iti-luebeck/BEEP/Hardware/3D-CAD/Robot.png

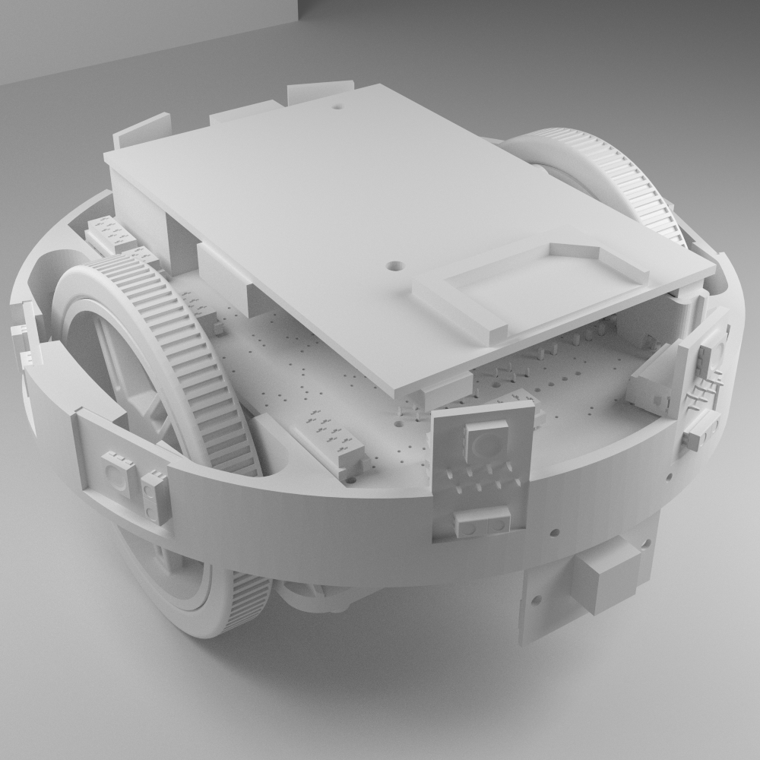
Hardware/3D-CAD/Robot.png
