iti-luebeck/BEEP/Images/BEEP 0.2/case_2.JPG

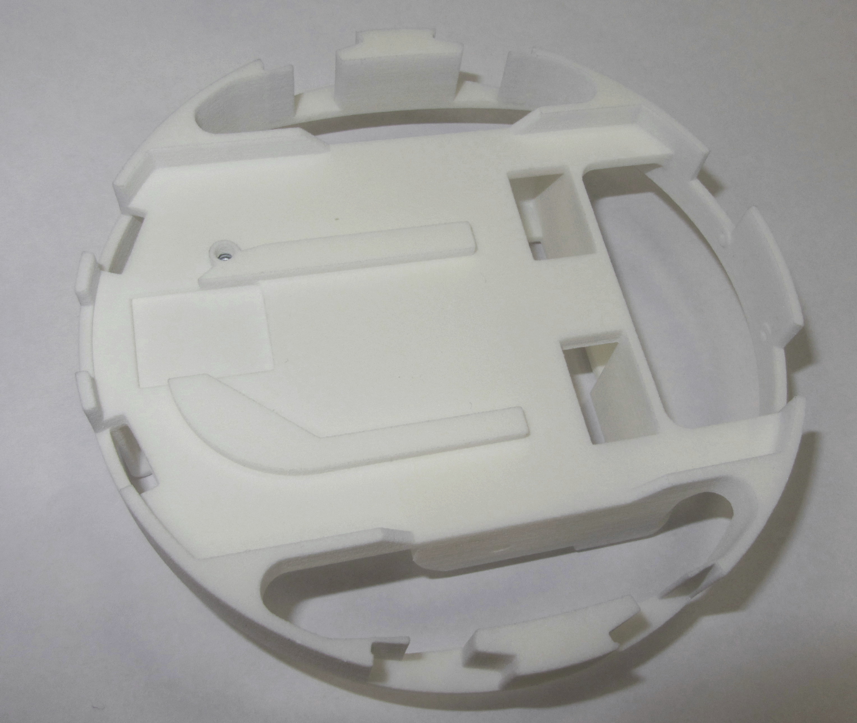
Images/BEEP 0.2/case_2.JPG
