iti-luebeck/BEEP/README.md

BEEP
====

BEEP is a small mobile robot build for education purposes.
