iti-luebeck/BEEP/Hardware/PCBs/BEEP_0.1/AIO/src/AIO.tex

\documentclass[a4paper]{scrartcl}
\usepackage[margin=1cm]{geometry}
\usepackage{graphicx}
\parindent=0pt
\parskip=5mm
\pagestyle{empty}
\begin{document}
\hspace{5mm}
\hspace{5mm}
\hspace{5mm}

\hspace{5mm}
\hspace{5mm}
\hspace{5mm}
\hspace{5mm}

\hspace{5mm}
\hspace{5mm}
\end{document}
