iti-luebeck/BEEP/Hardware/3D-CAD/exploded-view_1000.png

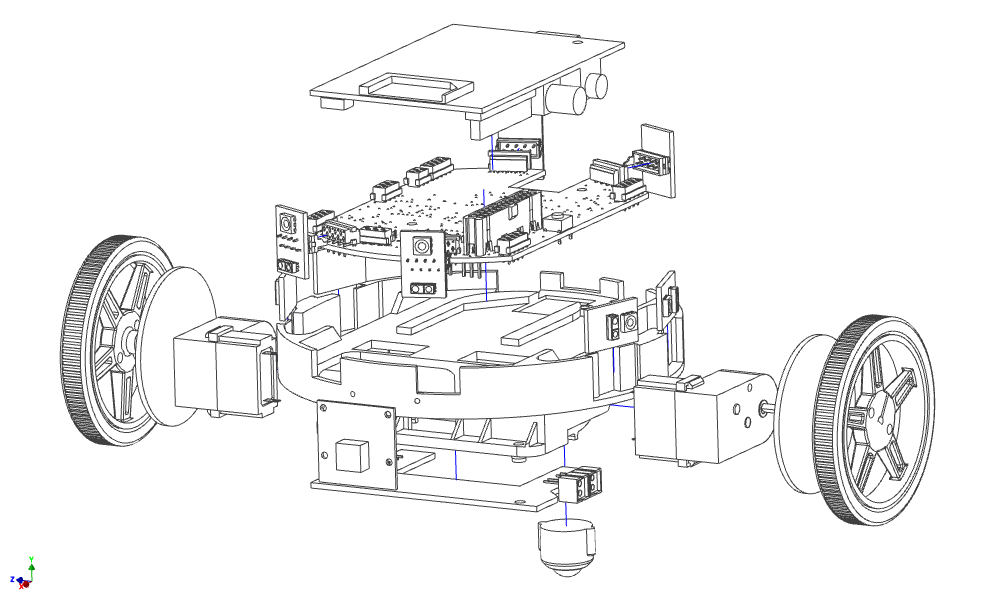
Hardware/3D-CAD/exploded-view_1000.png
