iti-luebeck/BEEP/Hardware/3D-CAD/parts/electronic/BEEP/AIO.png

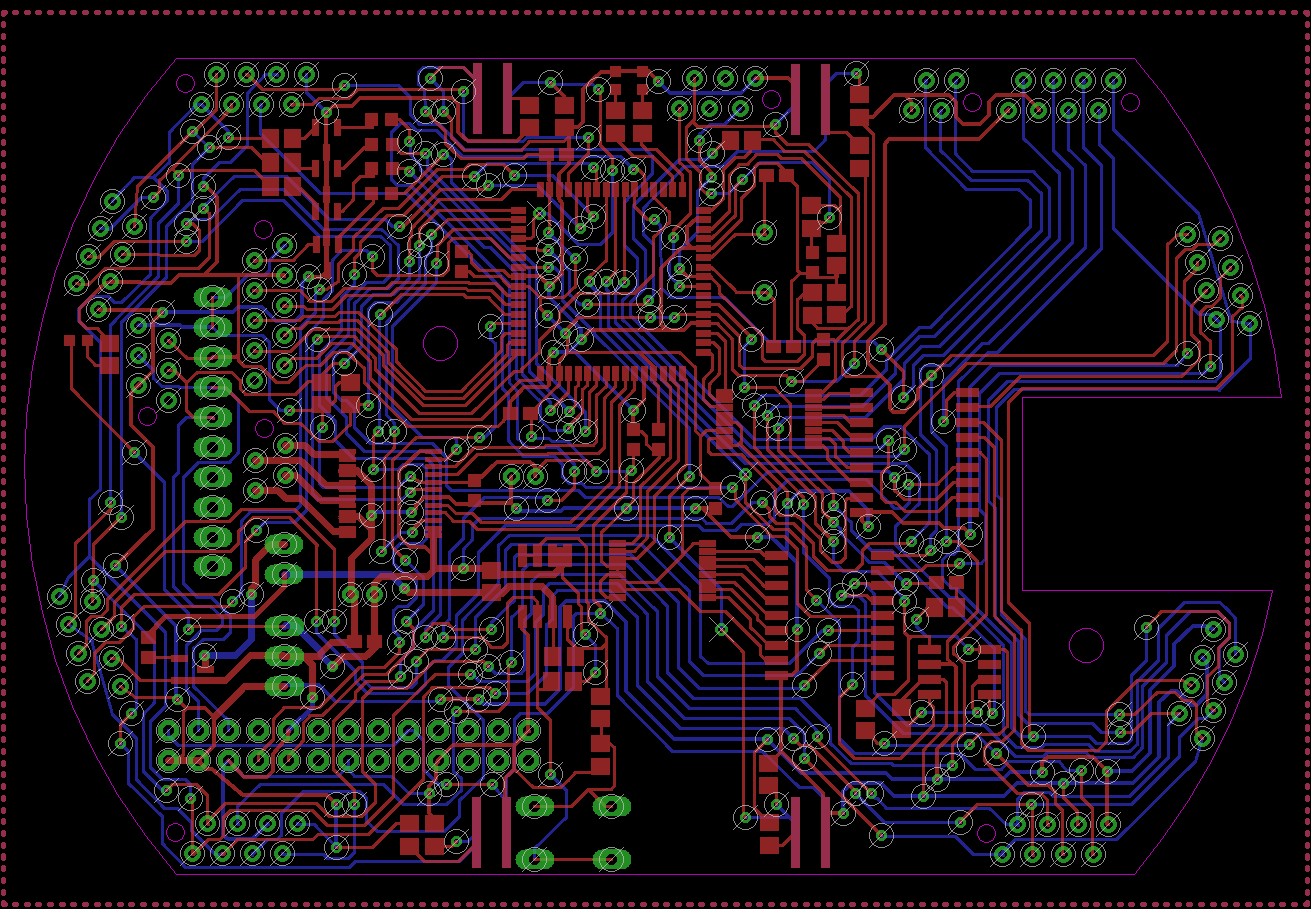
Hardware/3D-CAD/parts/electronic/BEEP/AIO.png
