iti-luebeck/BEEP/Hardware/PCBs/BEEP_0.1/3D/8_RGB_SMD_LEDs/8_RGB_SMD_LEDs_pcb_t.pov.png

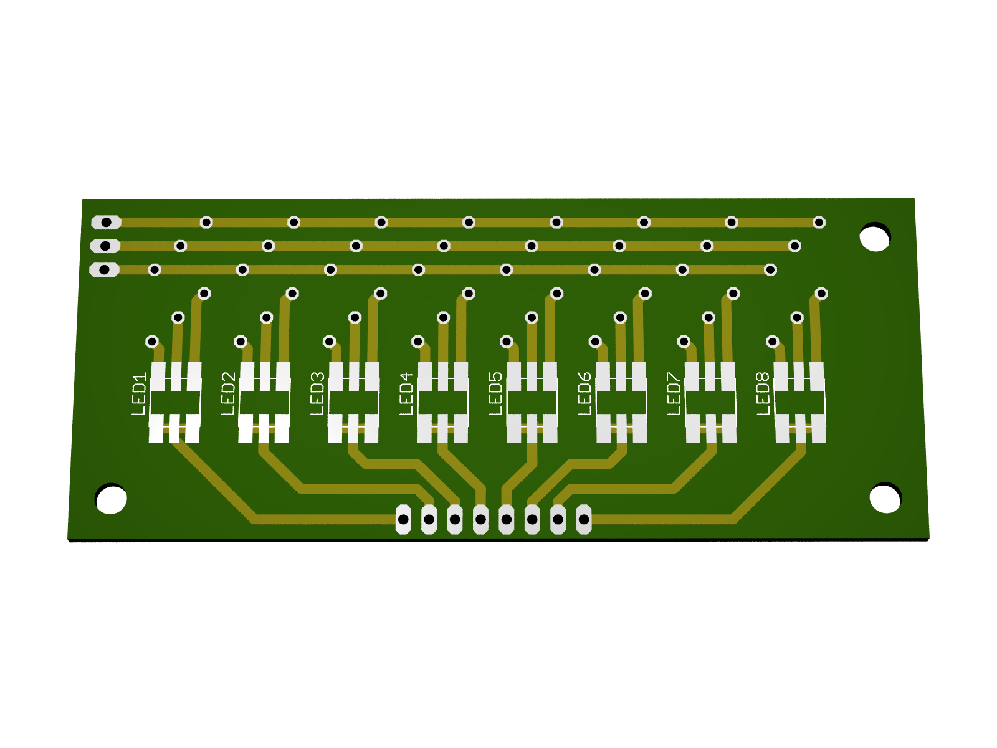
Hardware/PCBs/BEEP_0.1/3D/8_RGB_SMD_LEDs/8_RGB_SMD_LEDs_pcb_t.pov.png
