iti-luebeck/BEEP/Hardware/PCBs/BEEP_0.1/3D/APDS-9801/APDS-9801_pcb_b.pov.png

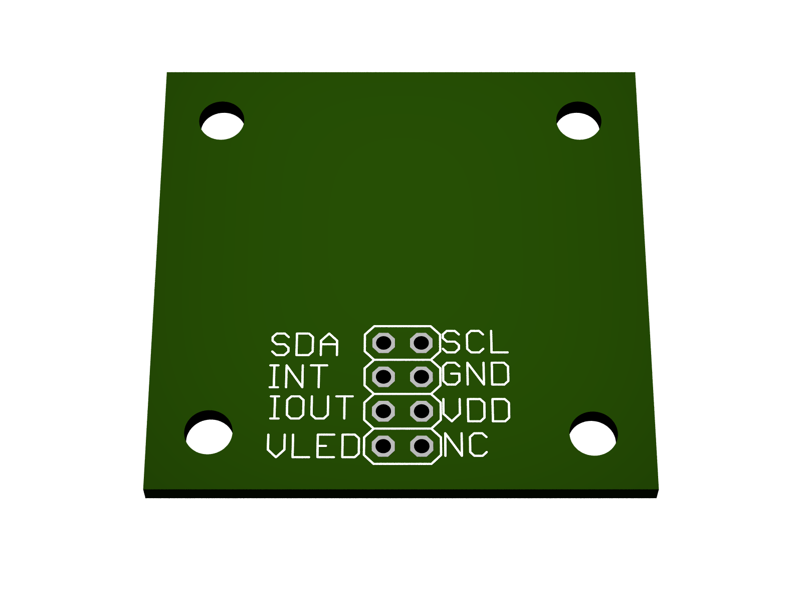
Hardware/PCBs/BEEP_0.1/3D/APDS-9801/APDS-9801_pcb_b.pov.png
