iti-luebeck/BEEP/Hardware/PCBs/BEEP_0.1/3D/ATMEGA168/ATMEGA168_pcb_t.pov.png

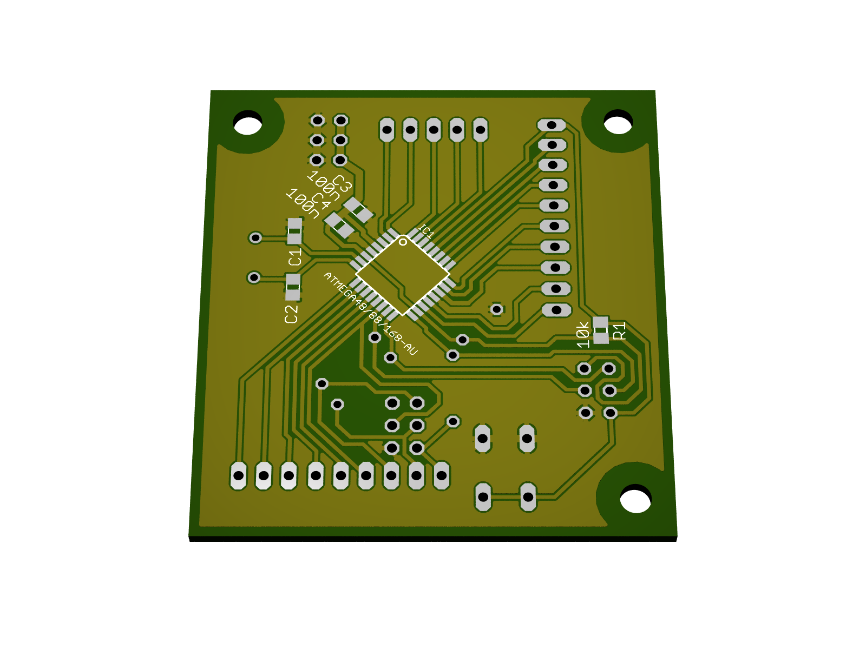
Hardware/PCBs/BEEP_0.1/3D/ATMEGA168/ATMEGA168_pcb_t.pov.png
