iti-luebeck/BEEP/Hardware/PCBs/BEEP_0.1/3D/Easy_LED/Easy_LED_pcb_t.pov.png

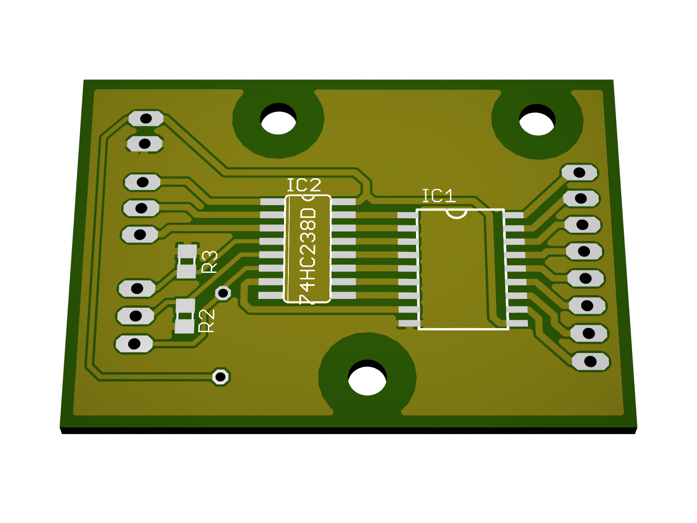
Hardware/PCBs/BEEP_0.1/3D/Easy_LED/Easy_LED_pcb_t.pov.png
