iti-luebeck/BEEP/Hardware/PCBs/BEEP_0.1/3D/HSDL-9100/HSDL-9100_pcb_t.pov.png

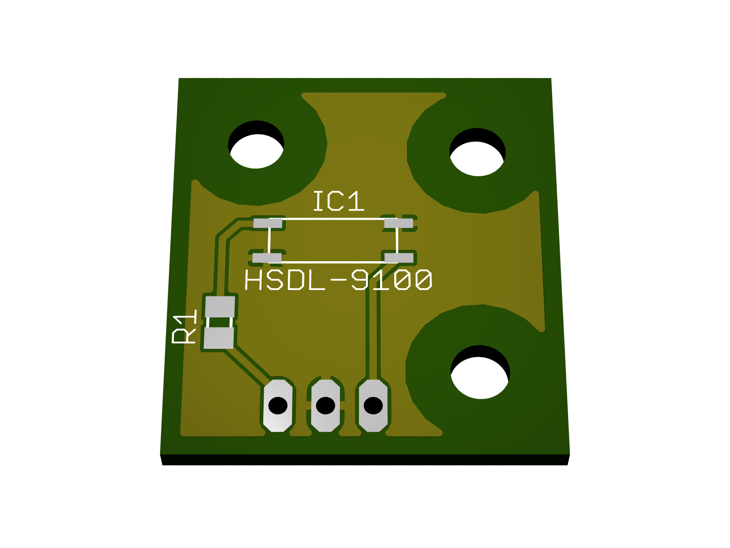
Hardware/PCBs/BEEP_0.1/3D/HSDL-9100/HSDL-9100_pcb_t.pov.png
