iti-luebeck/BEEP/Hardware/PCBs/BEEP_0.1/3D/PCA9548A/PCA9548A_t.pov.png

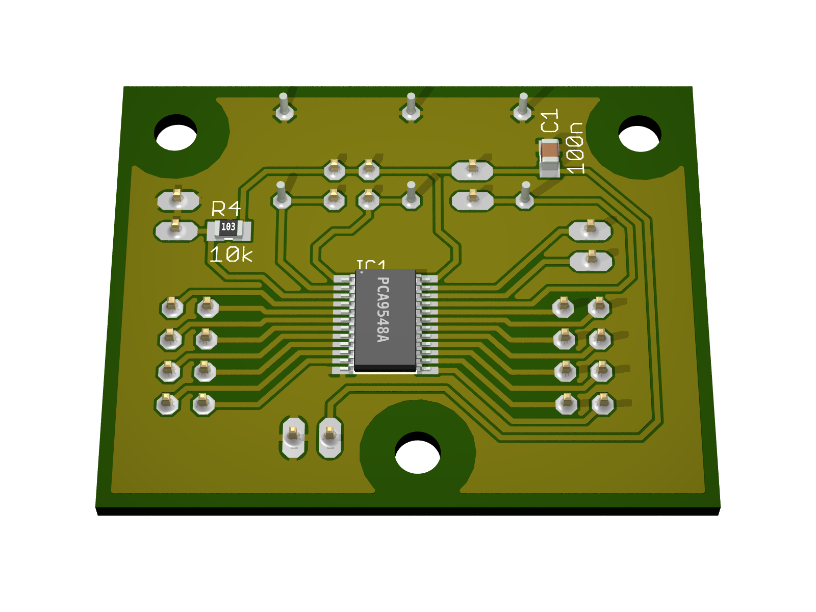
Hardware/PCBs/BEEP_0.1/3D/PCA9548A/PCA9548A_t.pov.png
