iti-luebeck/BEEP/Hardware/PCBs/BEEP_0.1/3D/TCS32X0/TCS32X0_pcb_t.pov.png

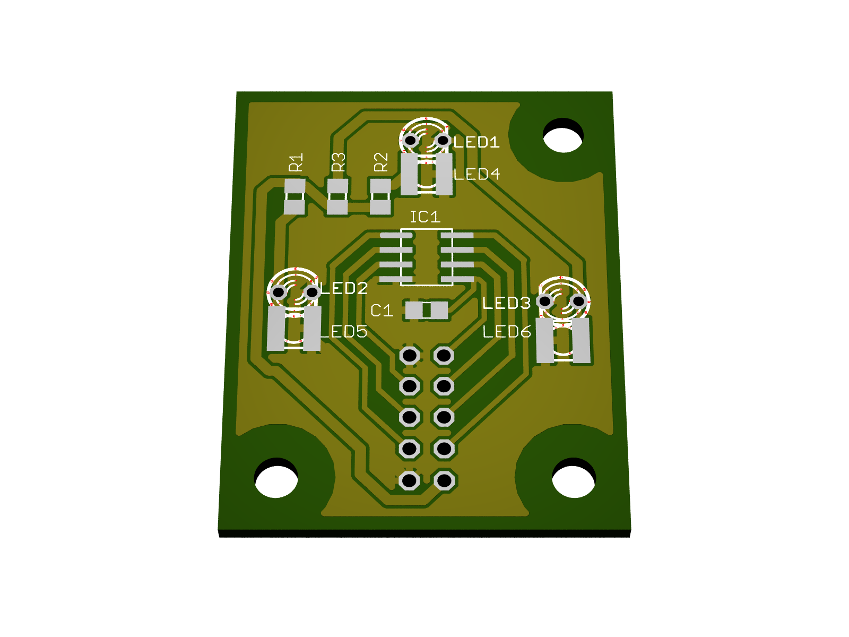
Hardware/PCBs/BEEP_0.1/3D/TCS32X0/TCS32X0_pcb_t.pov.png
