iti-luebeck/BEEP/Hardware/PCBs/BEEP_0.1/3D/TCS3103/TCS3103_b.pov.png

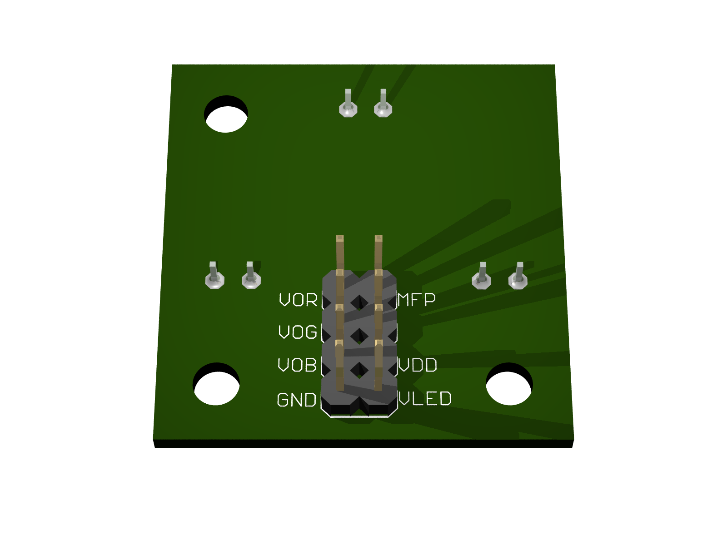
Hardware/PCBs/BEEP_0.1/3D/TCS3103/TCS3103_b.pov.png
