iti-luebeck/BEEP/Hardware/PCBs/BEEP_0.1/3D/TCS3103/TCS3103_pcb_t.pov.png

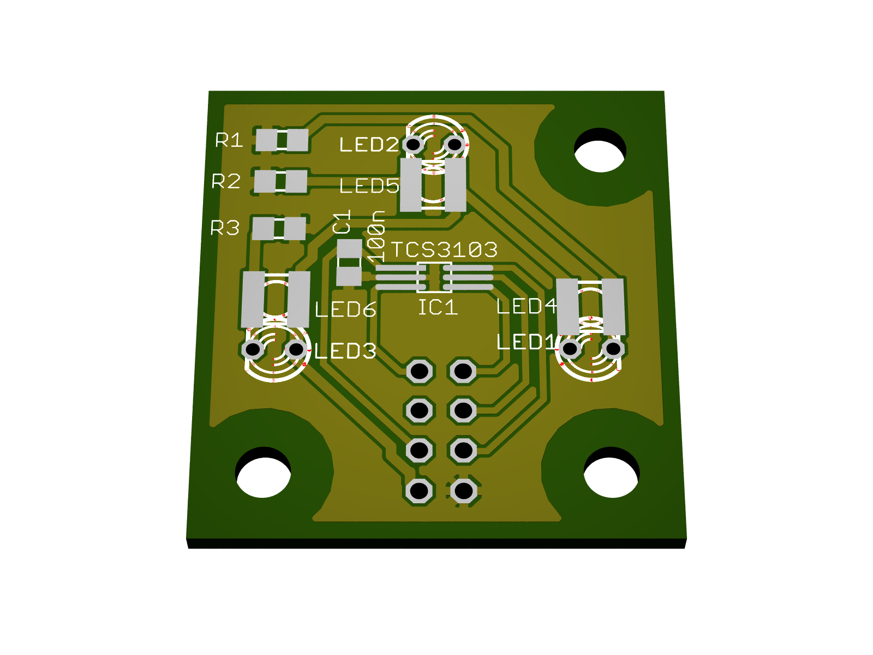
Hardware/PCBs/BEEP_0.1/3D/TCS3103/TCS3103_pcb_t.pov.png
