iti-luebeck/BEEP/Hardware/PCBs/BEEP_0.1/3D/TSL2671/TSL2671_b.pov.png

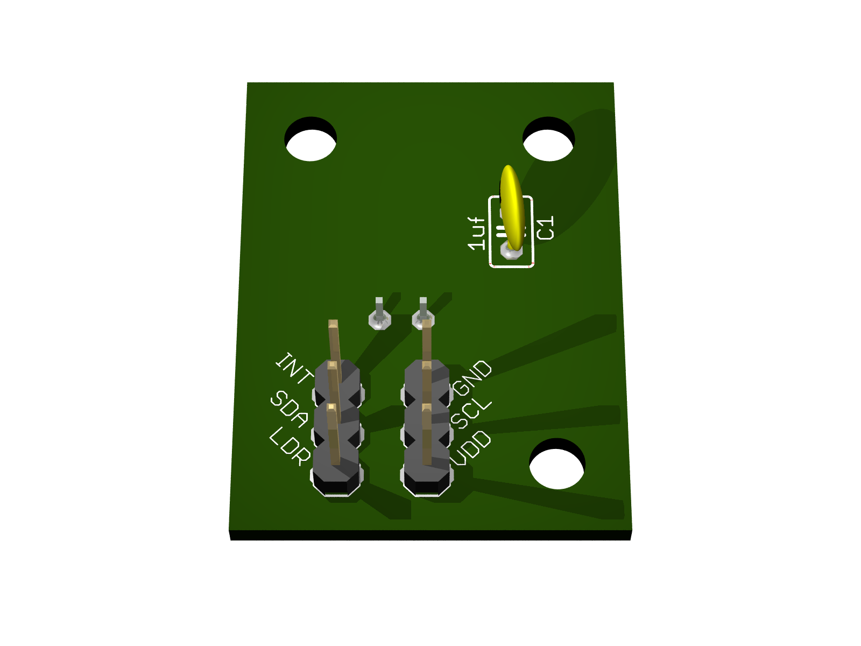
Hardware/PCBs/BEEP_0.1/3D/TSL2671/TSL2671_b.pov.png
