iti-luebeck/BEEP/Hardware/PCBs/BEEP_0.2/main-bottom.png

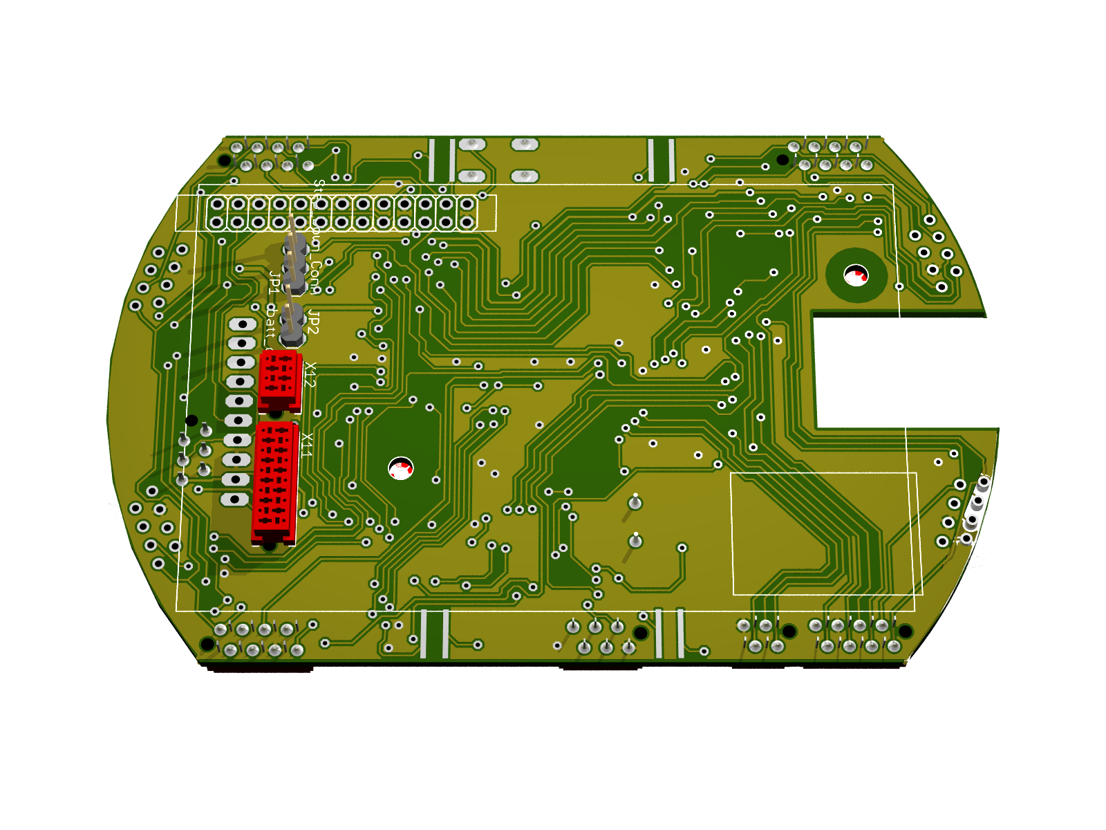
Hardware/PCBs/BEEP_0.2/main-bottom.png
