iti-luebeck/BEEP/Hardware/PCBs/BEEP_0.2/main_top.png

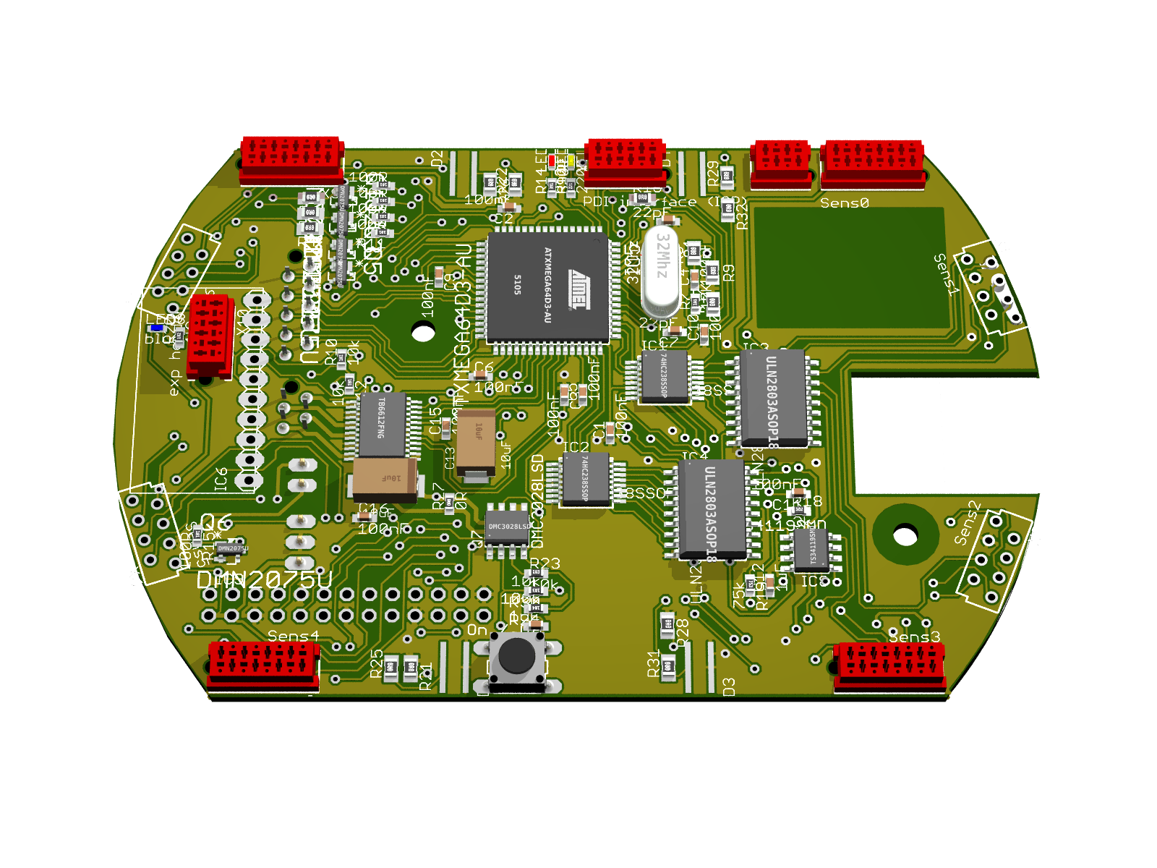
Hardware/PCBs/BEEP_0.2/main_top.png
