iti-luebeck/BEEP/Images/BEEP 0.2/CAD.png

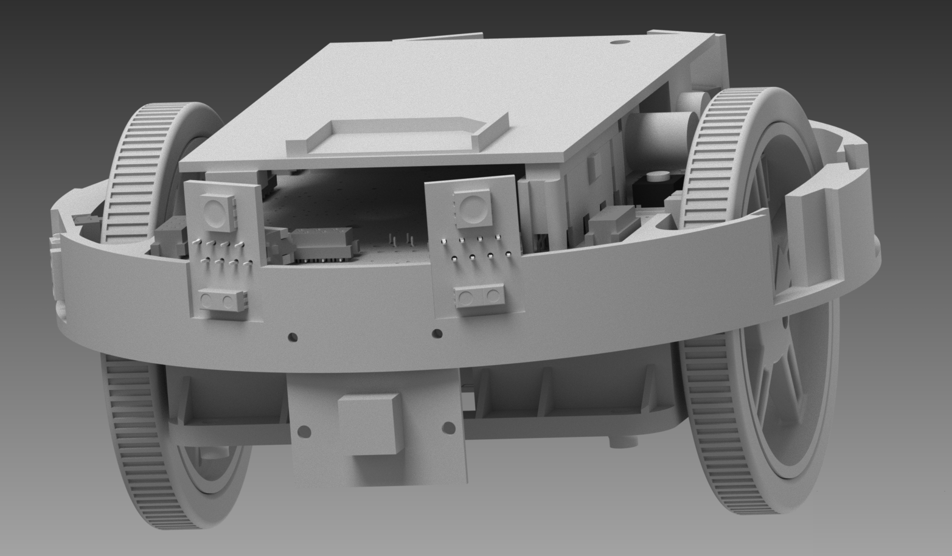
Images/BEEP 0.2/CAD.png
