iti-luebeck/BEEP/Images/BEEP 0.2/case_1.JPG

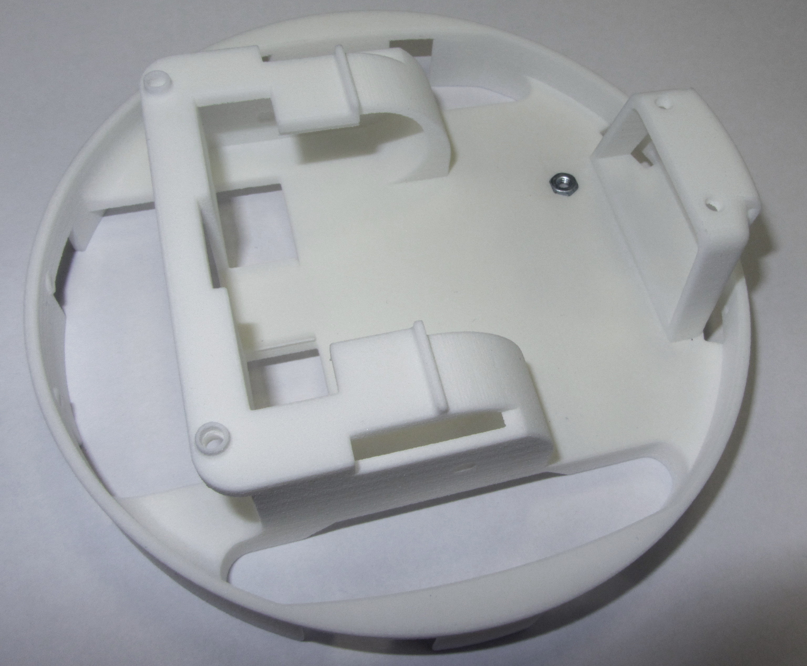
Images/BEEP 0.2/case_1.JPG
