iti-luebeck/BEEP/Images/BEEP 0.2/case_pcb_4.JPG

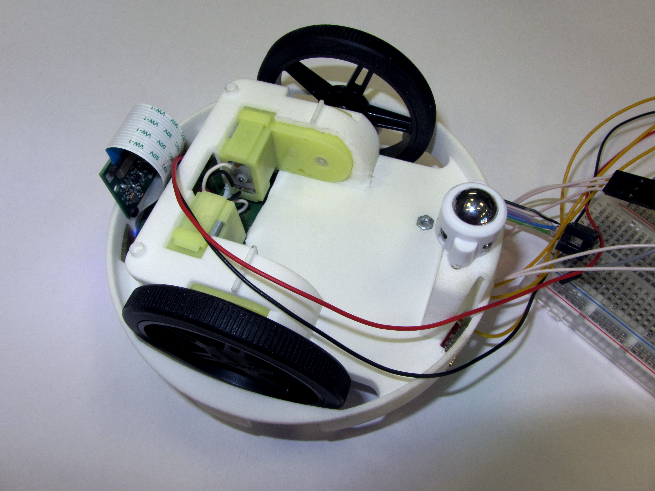
Images/BEEP 0.2/case_pcb_4.JPG
