iti-luebeck/BEEP/Images/BEEP 0.2/pcb_beep_2.JPG

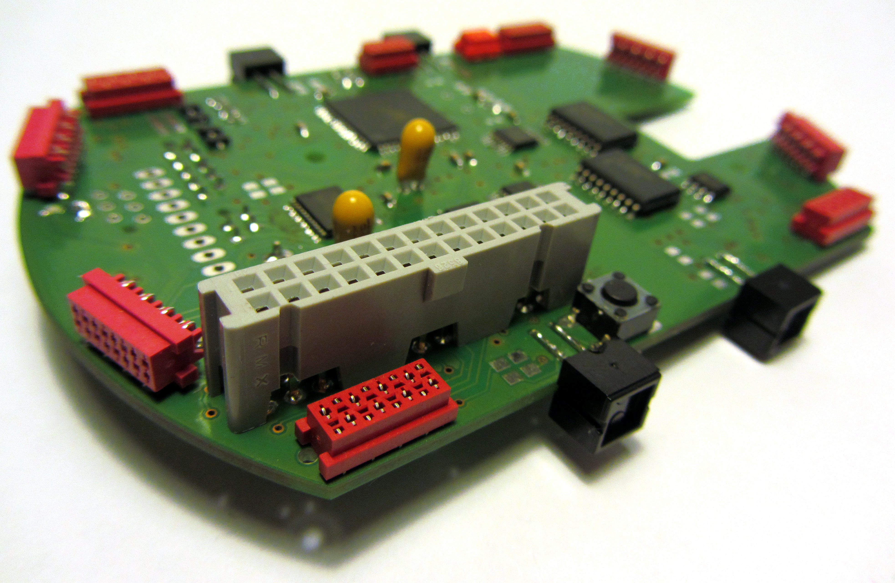
Images/BEEP 0.2/pcb_beep_2.JPG
