iti-luebeck/BEEP/Images/BEEP 0.2/pcb_combo_1.JPG

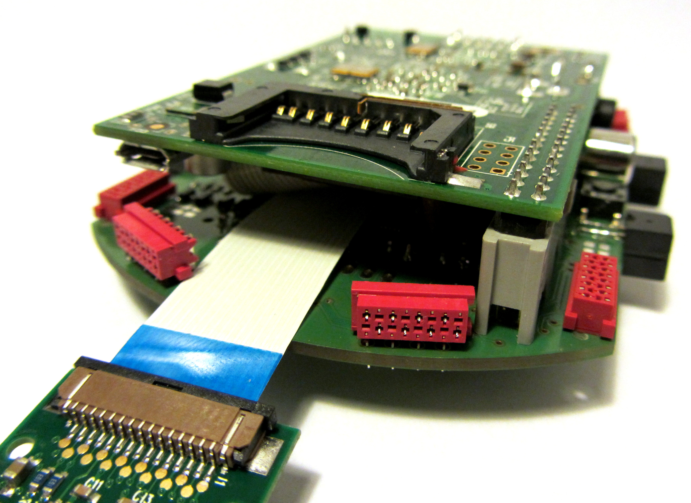
Images/BEEP 0.2/pcb_combo_1.JPG
