iti-luebeck/BEEP/Images/BEEP 0.2/pcb_combo_2.JPG

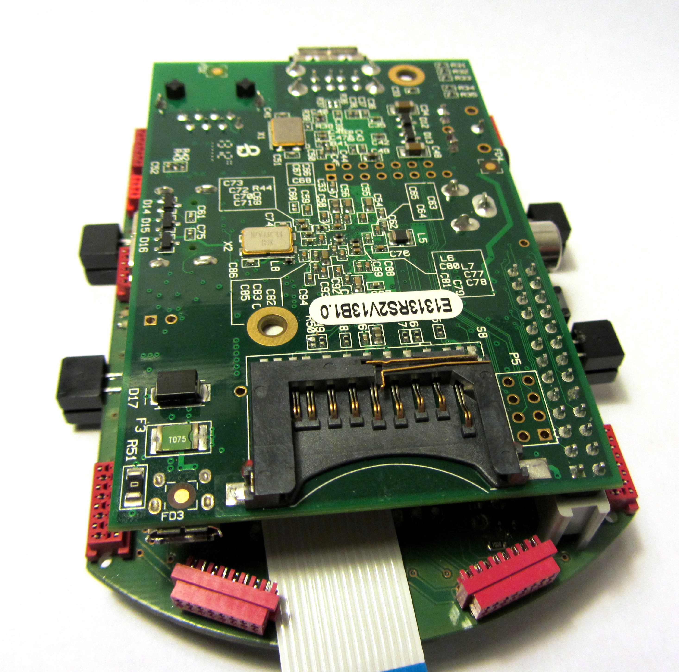
Images/BEEP 0.2/pcb_combo_2.JPG
