iti-luebeck/BEEP/Branding/BEEP.dxf

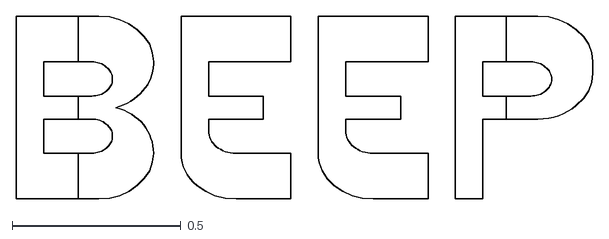
[picture p45: CAD file, 2013-05-05]
Branding/BEEP.dxf
1.71 x 0.541
