iti-luebeck/BEEP/Hardware/3D-CAD/parts/encoder_wheel.stp

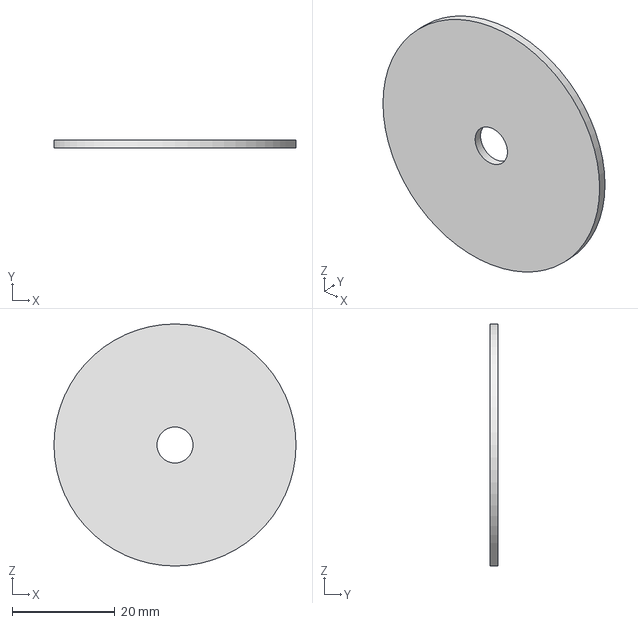
[picture p46: CAD file, 2013-08-02]
Hardware/3D-CAD/parts/encoder_wheel.stp
47.0 x 1.50 x 47.0 mm
