iti-luebeck/BEEP/Hardware/3D-CAD/pcb_space.dxf

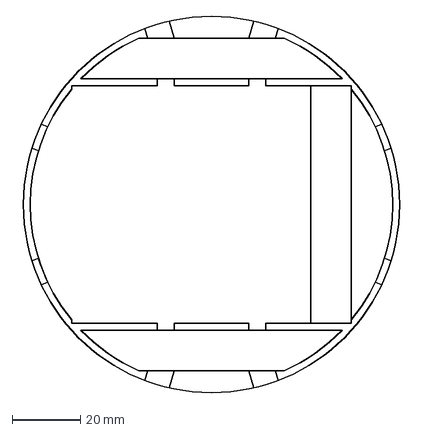
[picture p47: CAD file, 2013-06-28]
Hardware/3D-CAD/pcb_space.dxf
114.1 x 110.0 mm
