iti-luebeck/BEEP/Hardware/PCBs/BEEP_0.2/rgb_and_irdistance.dxf

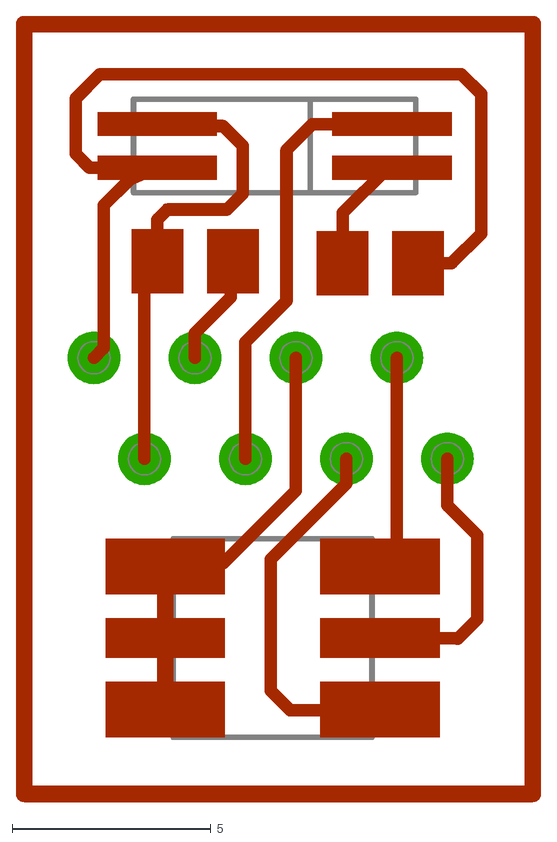
[picture p48: CAD file, 2013-08-30]
Hardware/PCBs/BEEP_0.2/rgb_and_irdistance.dxf
13.2 x 19.8
