iti-luebeck/BEEP/(list of files, cad)

Other CAD files:
Hardware/3D-CAD/ASUS_XtionPro_Live/head.ipt
Hardware/3D-CAD/Robot.iam
Hardware/3D-CAD/Robot.ipn
Hardware/3D-CAD/ball_caster/ball.ipt
Hardware/3D-CAD/ball_caster/ballcaster.iam
Hardware/3D-CAD/ball_caster/case.ipt
Hardware/3D-CAD/bottom_sensor.ipt
Hardware/3D-CAD/case/base.ipt
Hardware/3D-CAD/encoder_wheel.ipt
Hardware/3D-CAD/parts/Pololu_Wheel_6mm/Wheel.iam
Hardware/3D-CAD/parts/Pololu_Wheel_6mm/felloe.ipt
Hardware/3D-CAD/parts/Pololu_Wheel_6mm/tire.ipt
Hardware/3D-CAD/parts/Pololu_gear_motor_1_180/front.ipt
Hardware/3D-CAD/parts/Pololu_gear_motor_1_180/gear_motor.iam
Hardware/3D-CAD/parts/Pololu_gear_motor_1_180/motor_contact.ipt
Hardware/3D-CAD/parts/Pololu_gear_motor_1_180/motor_shaft.ipt
Hardware/3D-CAD/parts/Pololu_gear_motor_1_180/wheel_shaft.ipt
Hardware/3D-CAD/parts/battery_holder/battery_18500.ipt
Hardware/3D-CAD/parts/battery_holder/battery_18650.ipt
Hardware/3D-CAD/parts/battery_holder/holder_18500.ipt
Hardware/3D-CAD/parts/battery_holder/holder_18650.ipt
Hardware/3D-CAD/parts/battery_holder/holder_with_batteries_18500.iam
Hardware/3D-CAD/parts/battery_holder/holder_with_batteries_18650.iam
Hardware/3D-CAD/parts/electronic/BEEP/beep_main_assembled.iam
Hardware/3D-CAD/parts/electronic/BEEP/beep_main_new.ipt
Hardware/3D-CAD/parts/electronic/BEEP/beep_rgb_ir.ipt
Hardware/3D-CAD/parts/electronic/BEEP/beep_rgb_ir_assembled.iam
Hardware/3D-CAD/parts/electronic/BEEP/beep_rgb_ir_assembled_2.iam
Hardware/3D-CAD/parts/electronic/BEEP/components/12520.ipt
Hardware/3D-CAD/parts/electronic/BEEP/components/12521.ipt
Hardware/3D-CAD/parts/electronic/BEEP/components/5050 LED/5050_LED.ipt
Hardware/3D-CAD/parts/electronic/BEEP/components/8526-4500pl-01.ipt
Hardware/3D-CAD/parts/electronic/BEEP/components/HSDL-9100-024/HSDL-9100.iam
Hardware/3D-CAD/parts/electronic/BEEP/components/HSDL-9100-024/bottom_pcb.ipt
Hardware/3D-CAD/parts/electronic/BEEP/components/HSDL-9100-024/top.ipt
Hardware/3D-CAD/parts/electronic/BEEP/components/b3w-1000.ipt
Hardware/3D-CAD/parts/electronic/BEEP/components/ball_caster/top.ipt
Hardware/3D-CAD/parts/electronic/BEEP/components/c-215460-8-h-3d.ipt
Hardware/3D-CAD/parts/electronic/BEEP/components/cny-70.ipt
Hardware/3D-CAD/parts/electronic/BEEP/components/micro-miniature_steckverbinder_a-30-08p-1300.ipt
Hardware/3D-CAD/parts/electronic/BEEP/components/micro-miniature_steckverbinder_a-31-08p-1300.iam
Hardware/3D-CAD/parts/electronic/BEEP/components/micro-miniature_steckverbinder_a-31-08p-1300_01.ipt
Hardware/3D-CAD/parts/electronic/BEEP/components/micro-miniature_steckverbinder_a-31-08p-1300_02.ipt
Hardware/3D-CAD/parts/electronic/BEEP/components/micro-miniature_steckverbinder_a-32-04v-130x0.ipt
Hardware/3D-CAD/parts/electronic/BEEP/components/micro-miniature_steckverbinder_a-32-06v-130x0.ipt
Hardware/3D-CAD/parts/electronic/BEEP/components/micro-miniature_steckverbinder_a-32-08v-130x0.ipt
Hardware/3D-CAD/parts/electronic/BEEP/components/micro-miniature_steckverbinder_a-32-10v-130x0.ipt
Hardware/3D-CAD/parts/electronic/BEEP/components/micro_miniature_a-32-08h-130l.ipt
Hardware/3D-CAD/parts/electronic/RaspberryPi/PCB.ipt
Hardware/3D-CAD/parts/electronic/RaspberryPi/RaspberryPi.iam
Hardware/3D-CAD/parts/electronic/RaspberryPi/RaspberryPi_PCB.ipt
Hardware/3D-CAD/parts/electronic/RaspberryPi/RaspberryPi_with_frame.iam
Hardware/3D-CAD/parts/electronic/RaspberryPi/SD.ipt
Hardware/3D-CAD/parts/electronic/RaspberryPi/frame.ipt
Hardware/3D-CAD/parts/electronic/RaspberryPi_Camera/camera.ipt
Hardware/3D-CAD/parts/electronic/RaspberryPi_Camera/camera_modul.iam
Hardware/3D-CAD/parts/electronic/RaspberryPi_Camera/connector.ipt
Hardware/3D-CAD/parts/electronic/RaspberryPi_Camera/pcb.ipt
Hardware/3D-CAD/parts/electronic/pcb_assembly.iam
Hardware/3D-CAD/parts/encoder_wheel.ipt
Hardware/3D-CAD/parts/encoder_wheel.stl
Hardware/3D-CAD/sensorboard_assembly.iam
Hardware/Model/Baugruppe1.iam
