iti-luebeck/BEEP/Software/Evaluation IRfilterung.ods

Evaluation Tageslichtfilter
Abstand (mm) | Rohdaten |  | Gefiltert
 | unbeleuchtet | beleuchtet | unbeleuchtet | beleuchtet
10 | 201 | 227 | 191 | 192
20 | 77 | 184 | 69 | 70
30 | 41 | 154 | 33 | 34
40 | 26 | 110 | 19 | 19
50 | 18 | 113 | 11 | 11
60 | 14 | 99 | 7 | 7
70 | 12 | 108 | 5 | 5
80 | 10 | 103 | 3 | 3
90 | 9 | 106 | 2 | 2
100 | 9 | 106 | 1 | 1
