iti-luebeck/BEEP/Hardware/PCBs/BEEP_0.2/bottom.pdf

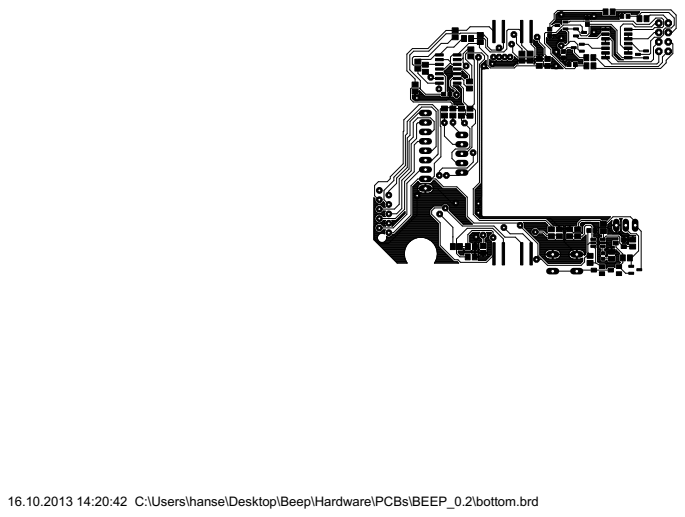
[picture p49: page 1]

16.10.2013 14:20:42 C:\Users\hanse\Desktop\Beep\Hardware\PCBs\BEEP_0.2\bottom.brd
