iti-luebeck/BEEP/Hardware/PCBs/BEEP_0.2/color_sensor.pdf

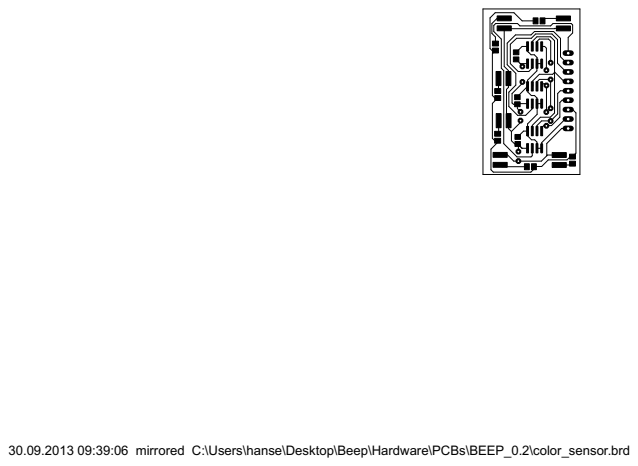
[picture p50: page 1]

30.09.2013 09:39:06 mirrored C:\Users\hanse\Desktop\Beep\Hardware\PCBs\BEEP_0.2\color_sensor.brd
