iti-luebeck/BEEP/Hardware/PCBs/BEEP_0.2/rgb_and_irdistance_side.pdf

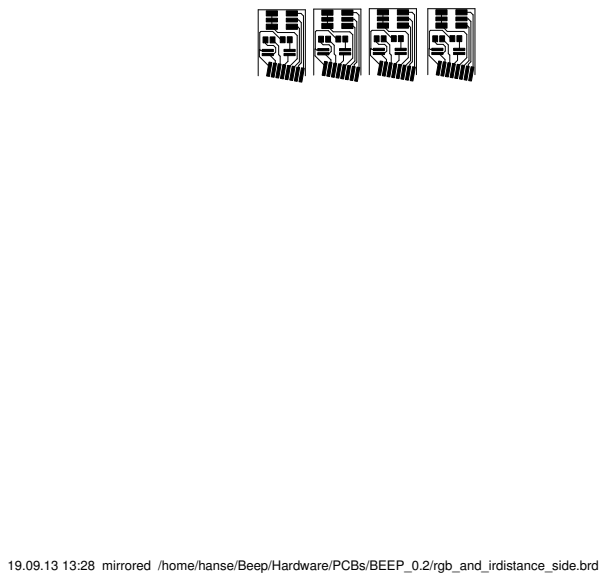
[picture p51: page 1]

19.09.13 13:28 mirrored /home/hanse/Beep/Hardware/PCBs/BEEP_0.2/rgb_and_irdistance_side.brd
