iti-luebeck/BEEP/Hardware/PCBs/BEEP_0.2/rgb_and_irdistance_side2,3.pdf

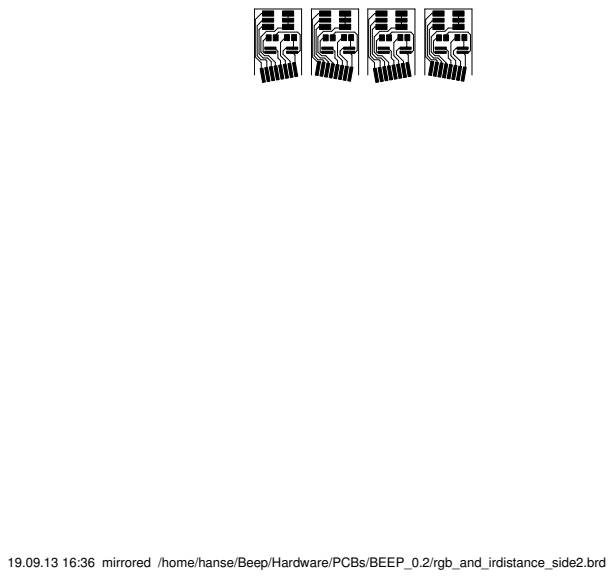
[picture p52: page 1]

19.09.13 16:36 mirrored /home/hanse/Beep/Hardware/PCBs/BEEP_0.2/rgb_and_irdistance_side2.brd
