iti-luebeck/BEEP/Hardware/PCBs/BEEP_0.1/AIO/APDS-9801.pdf

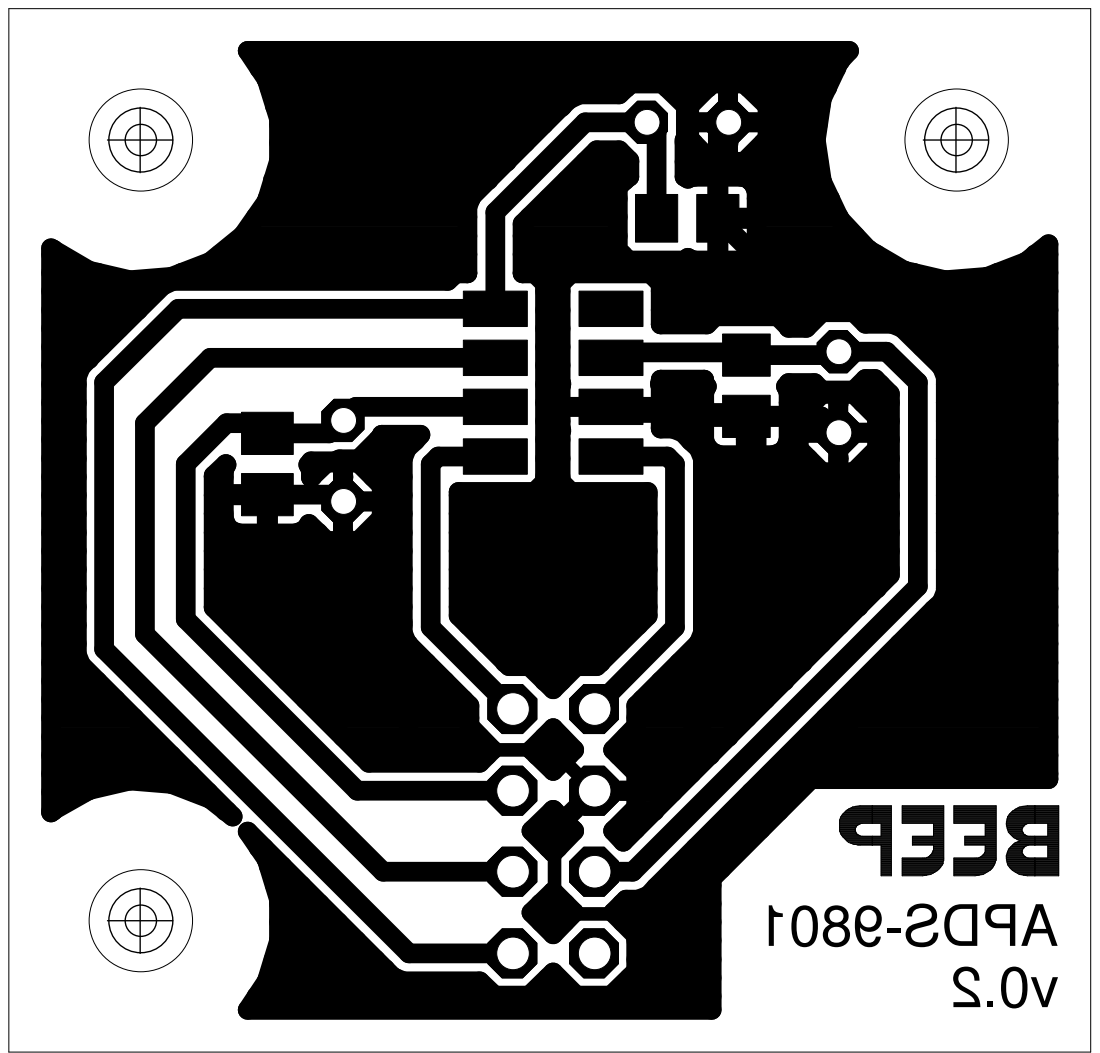
[picture p53: page 1]
1089- SDPA 2. 0v
