iti-luebeck/BEEP/Hardware/PCBs/BEEP_0.1/AIO/Easy_LED.pdf

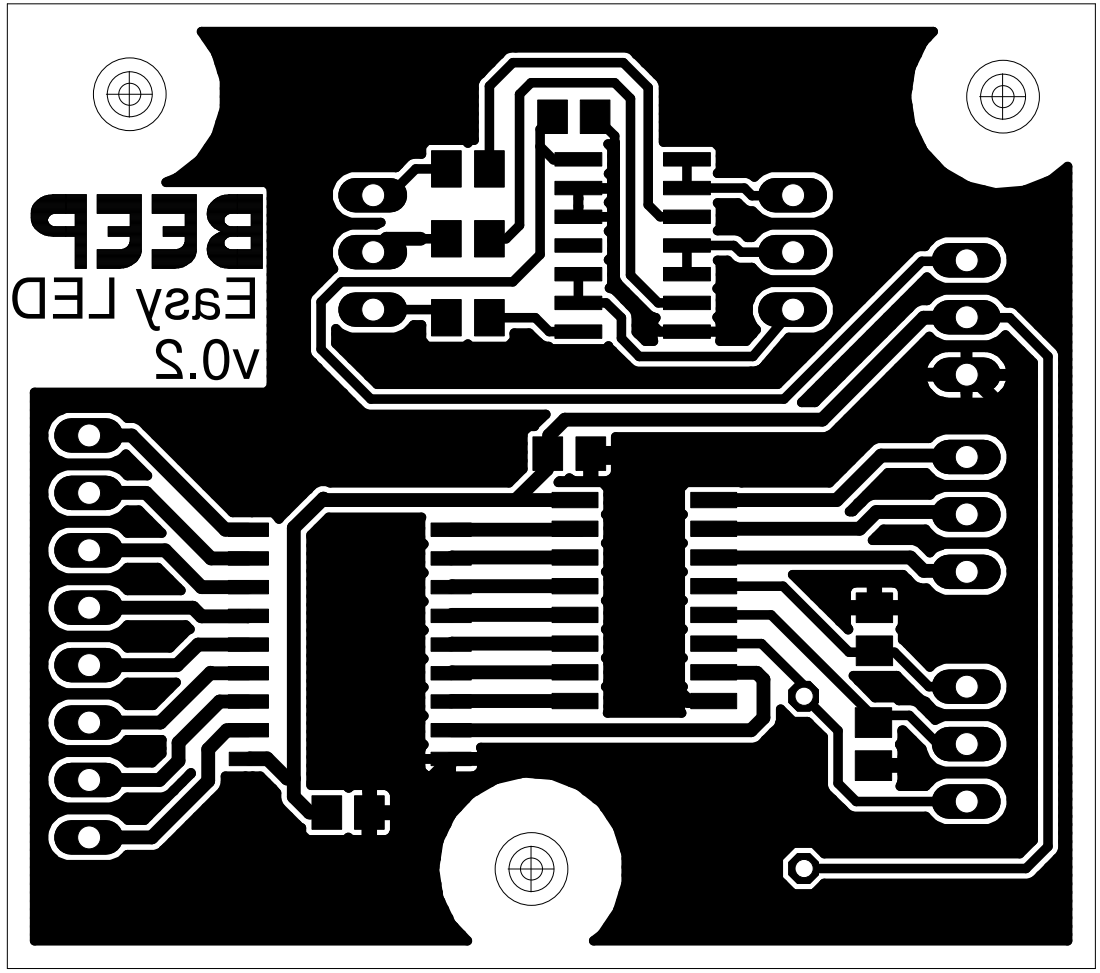
[picture p54: page 1]
DEL ysaE 2. 0v
