iti-luebeck/BEEP/Hardware/PCBs/BEEP_0.1/AIO/HSDL-9100.pdf

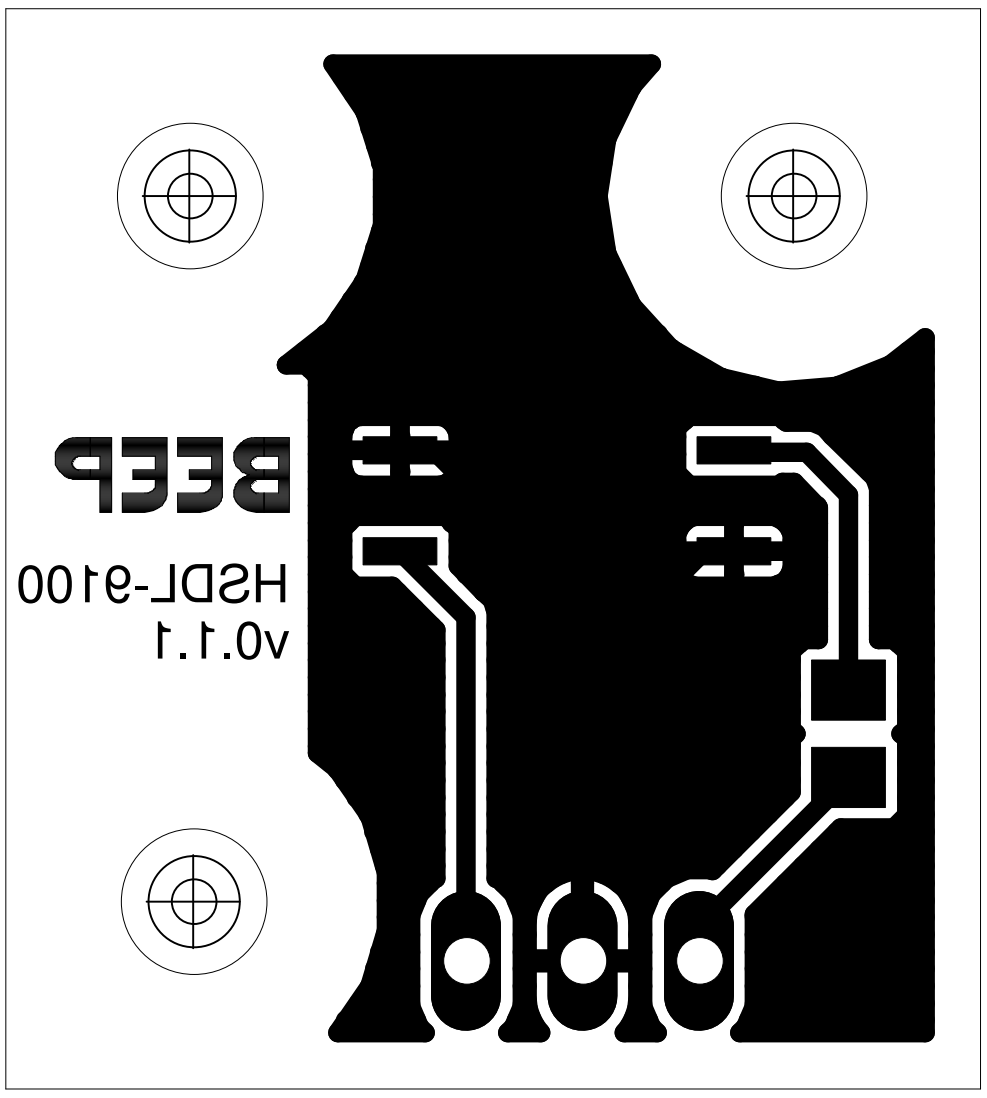
[picture p55: page 1]
0019- L DSH 1. 1. 0v
