iti-luebeck/BEEP/Hardware/PCBs/BEEP_0.1/AIO/PCA9548A.pdf

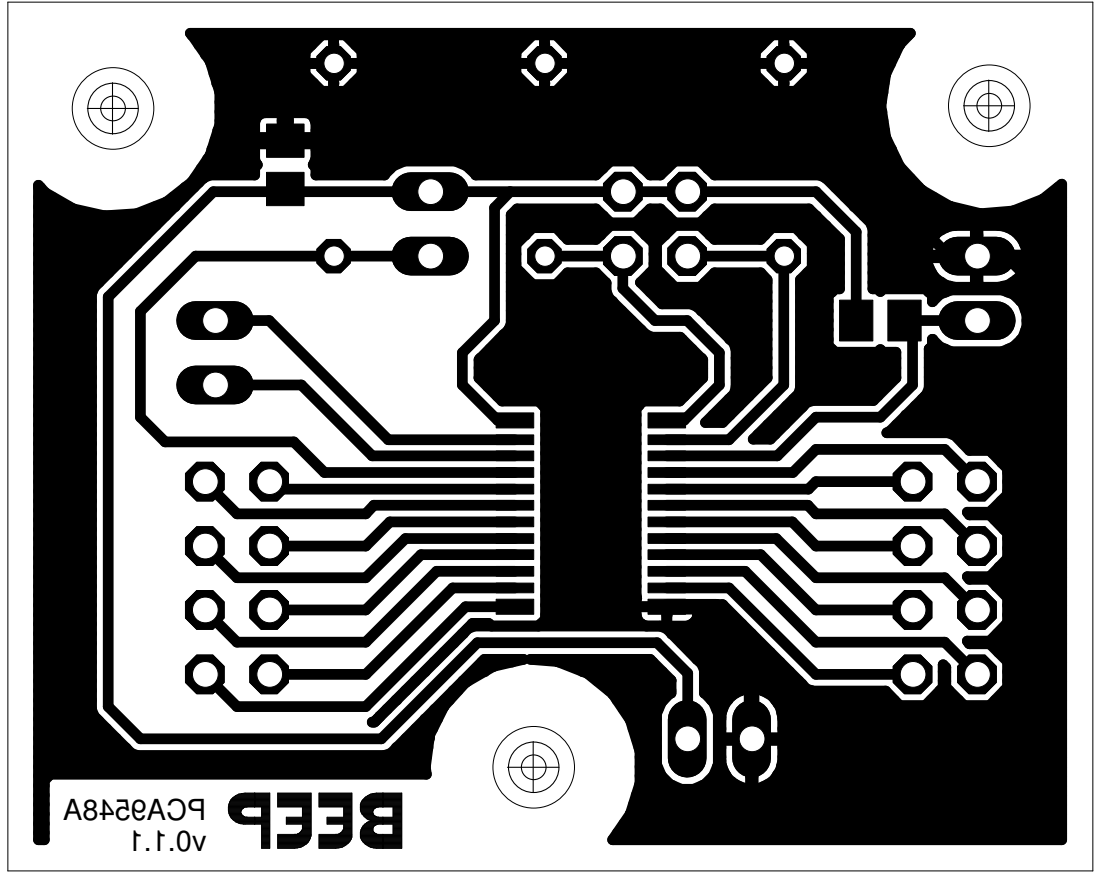
[picture p56: page 1]
A8459ACP 1. 1. 0v
