iti-luebeck/BEEP/Hardware/PCBs/BEEP_0.1/AIO/TCS32X0.pdf

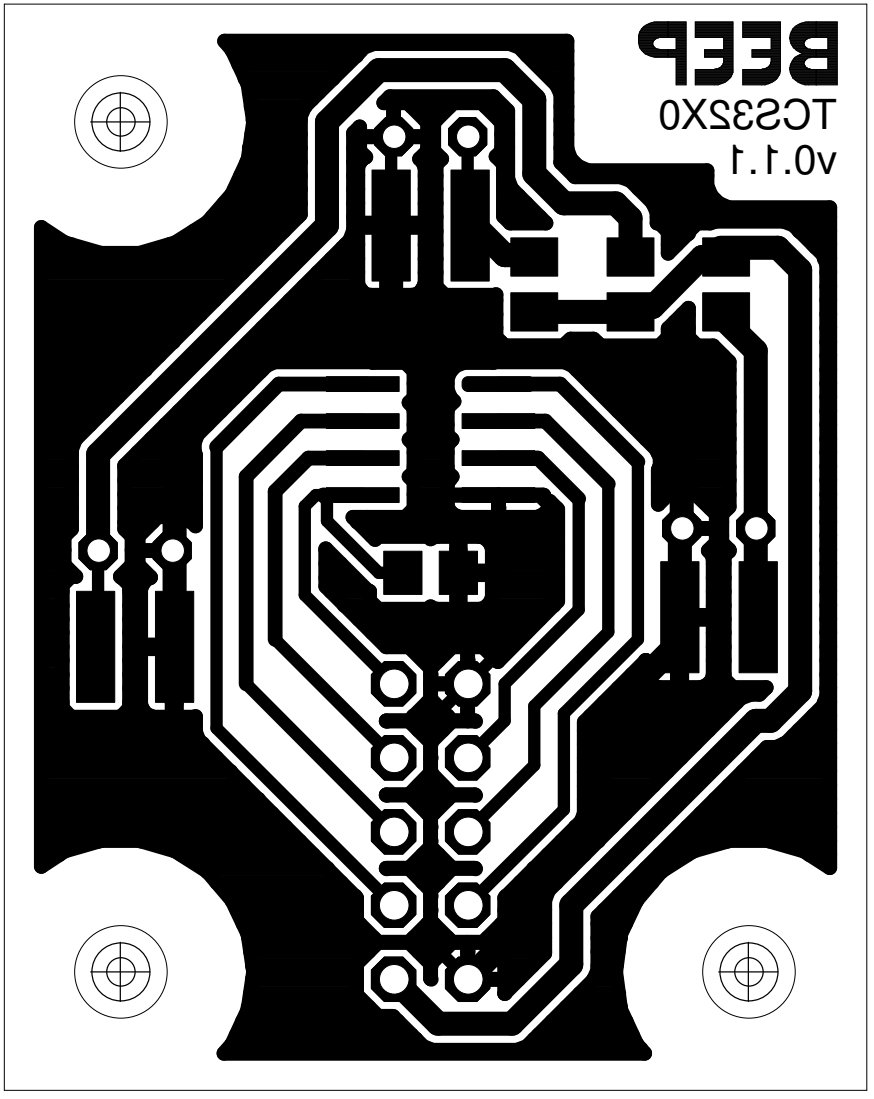
[picture p57: page 1]
0X23SCT 1. 1. 0v
