iti-luebeck/BEEP/Test/Color_Test.pdf

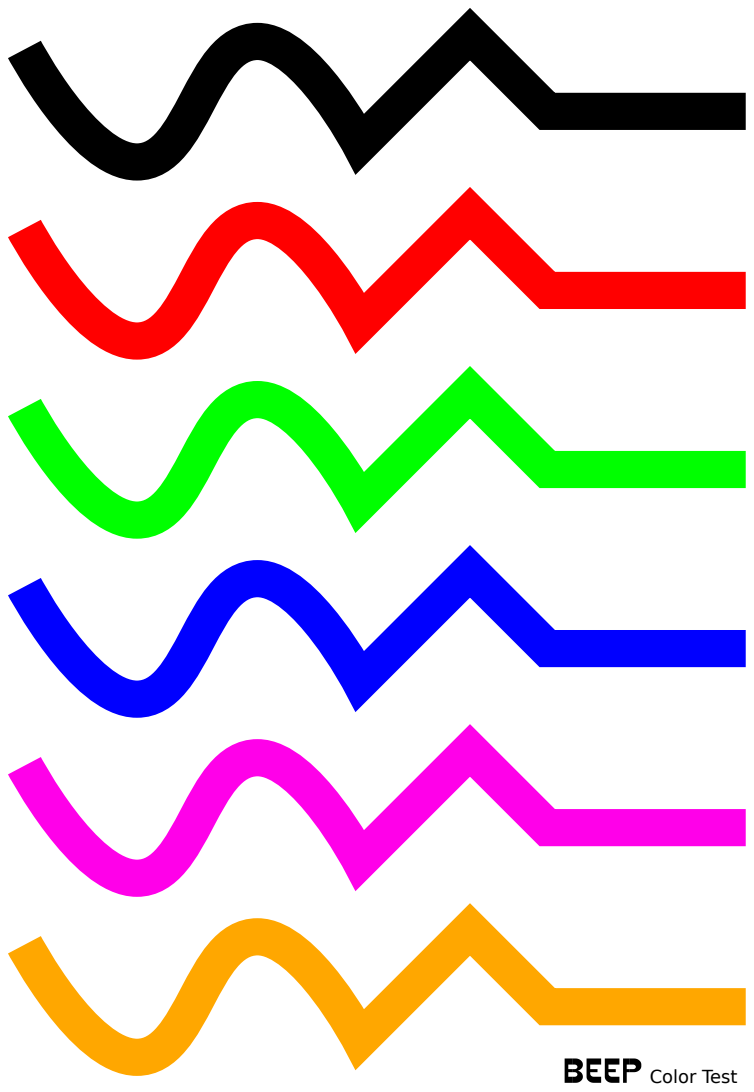
[picture p58: page 1]
Color Test
