iti-luebeck/BEEP/Hardware/PCBs/BEEP_0.1/HSDL-9100.pdf

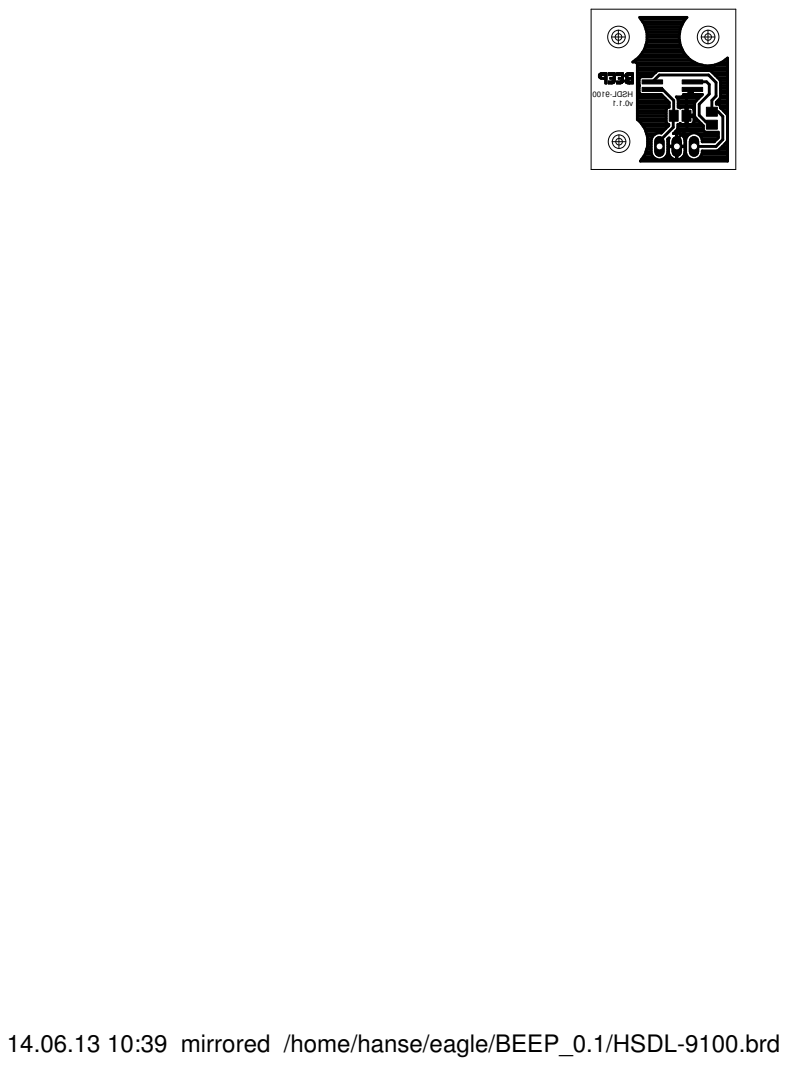
[picture p59: page 1]

14.06.13 10:39 mirrored /home/hanse/eagle/BEEP_0.1/HSDL-9100.brd
