iti-luebeck/BEEP/Hardware/PCBs/BEEP_0.1/EE-SX1131.pdf

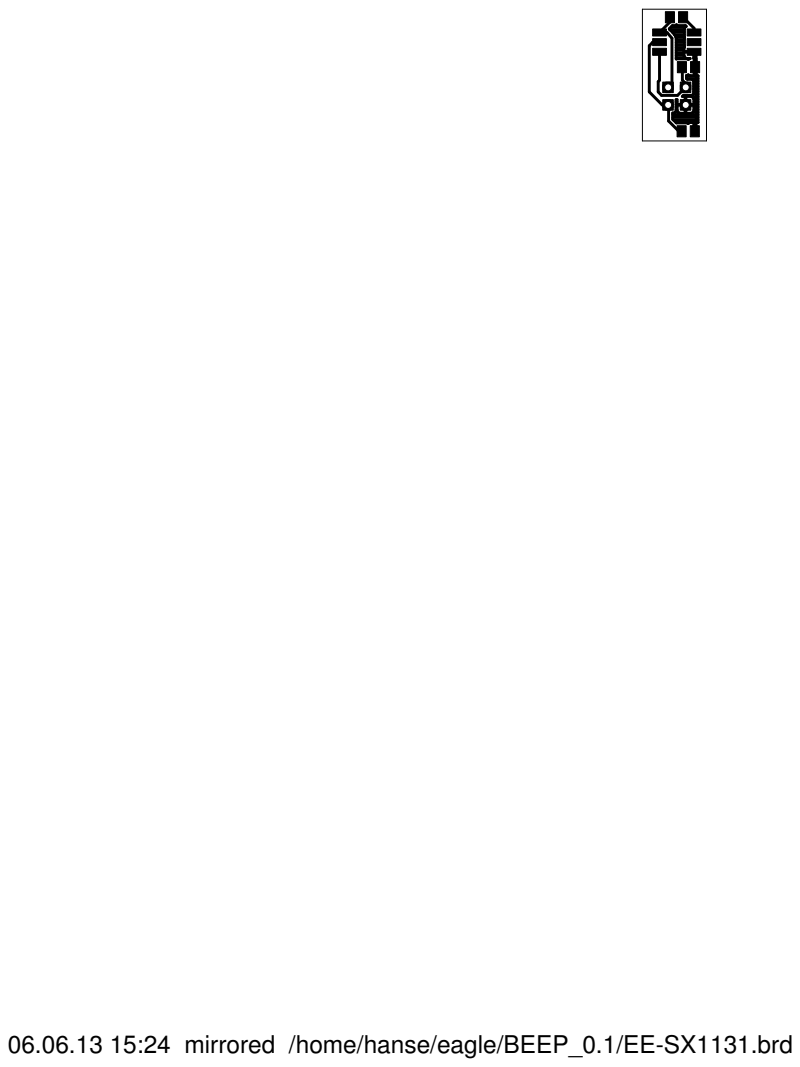
[picture p60: page 1]

06.06.13 15:24 mirrored /home/hanse/eagle/BEEP_0.1/EE-SX1131.brd
