iti-luebeck/BEEP/Hardware/PCBs/BEEP_0.1/TSL2671.pdf

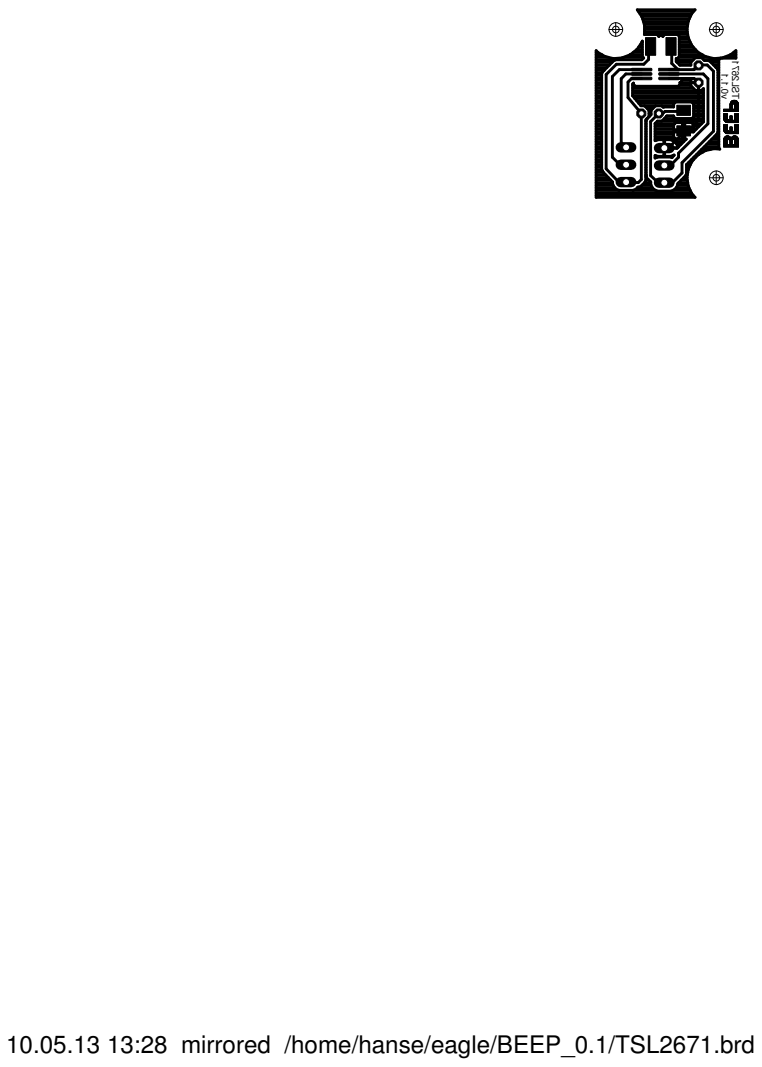
[picture p61: page 1]

10.05.13 13:28 mirrored /home/hanse/eagle/BEEP_0.1/TSL2671.brd
