iti-luebeck/BEEP/Hardware/PCBs/BEEP_0.1/8_RGB_SMD_LEDs.pdf

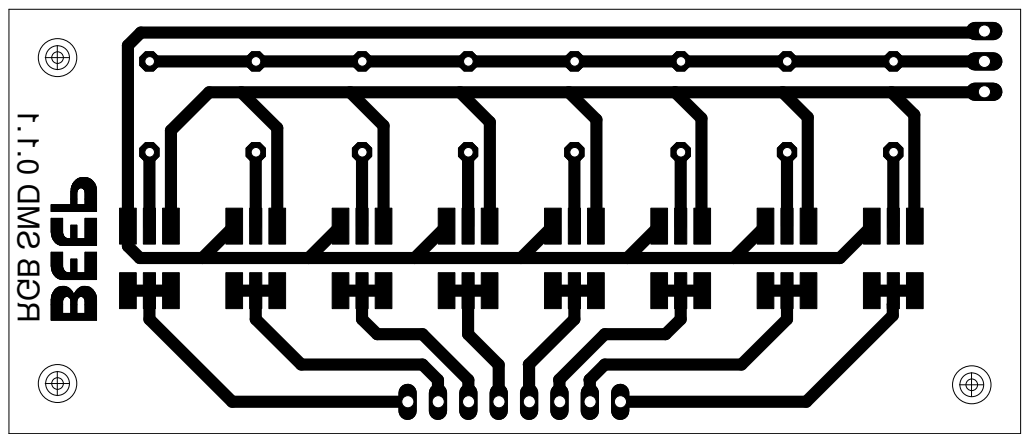
[picture p62: page 1]
