iti-luebeck/BEEP/Hardware/PCBs/BEEP_0.1/APDS-9801.pdf

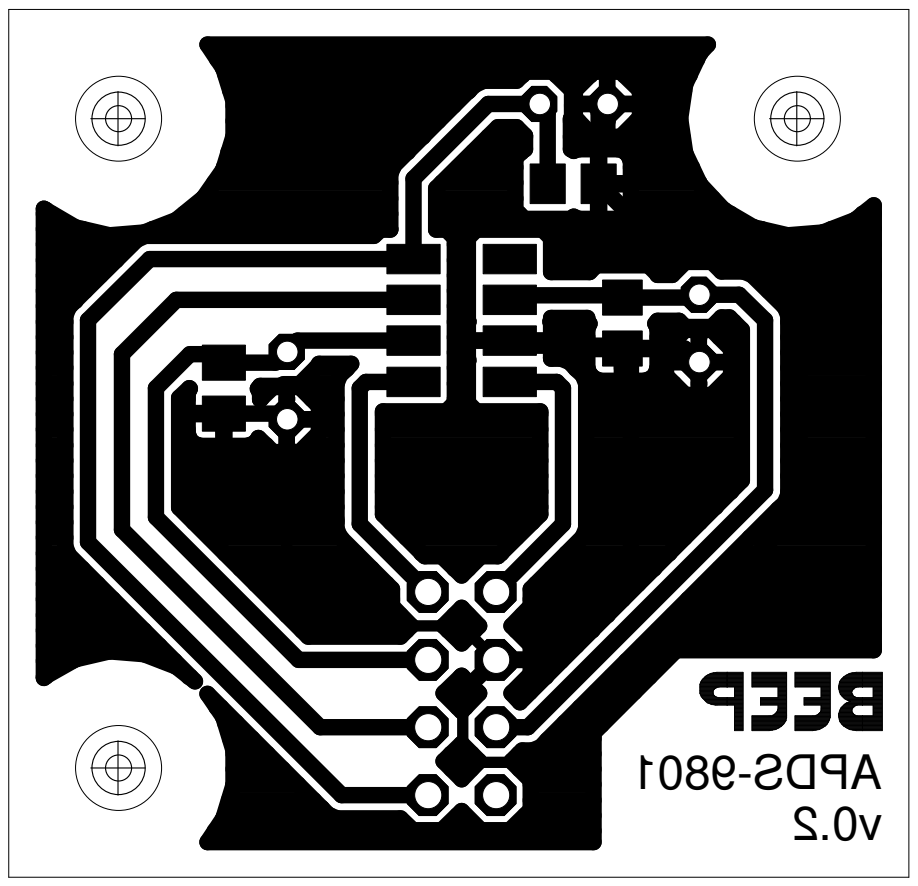
[picture p63: page 1]
