iti-luebeck/BEEP/Hardware/PCBs/BEEP_0.1/ATMEGA168.pdf

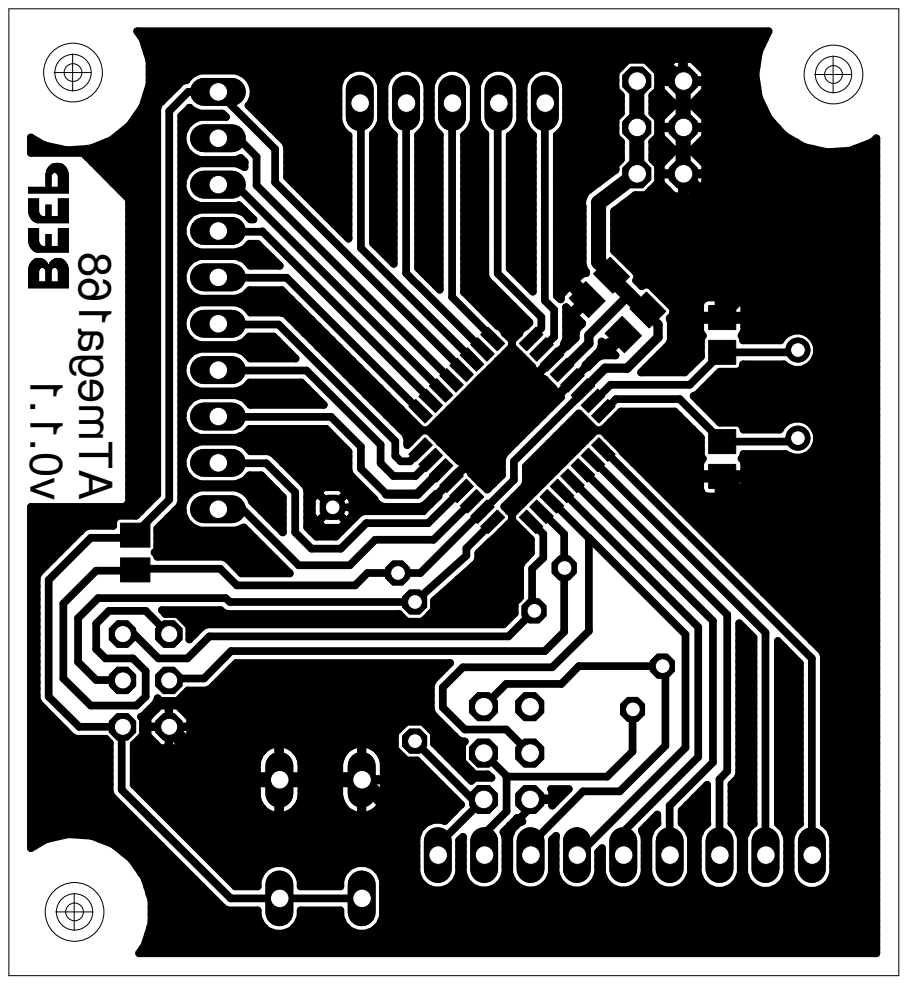
[picture p64: page 1]
