iti-luebeck/BEEP/Hardware/PCBs/BEEP_0.1/Easy_LED.pdf

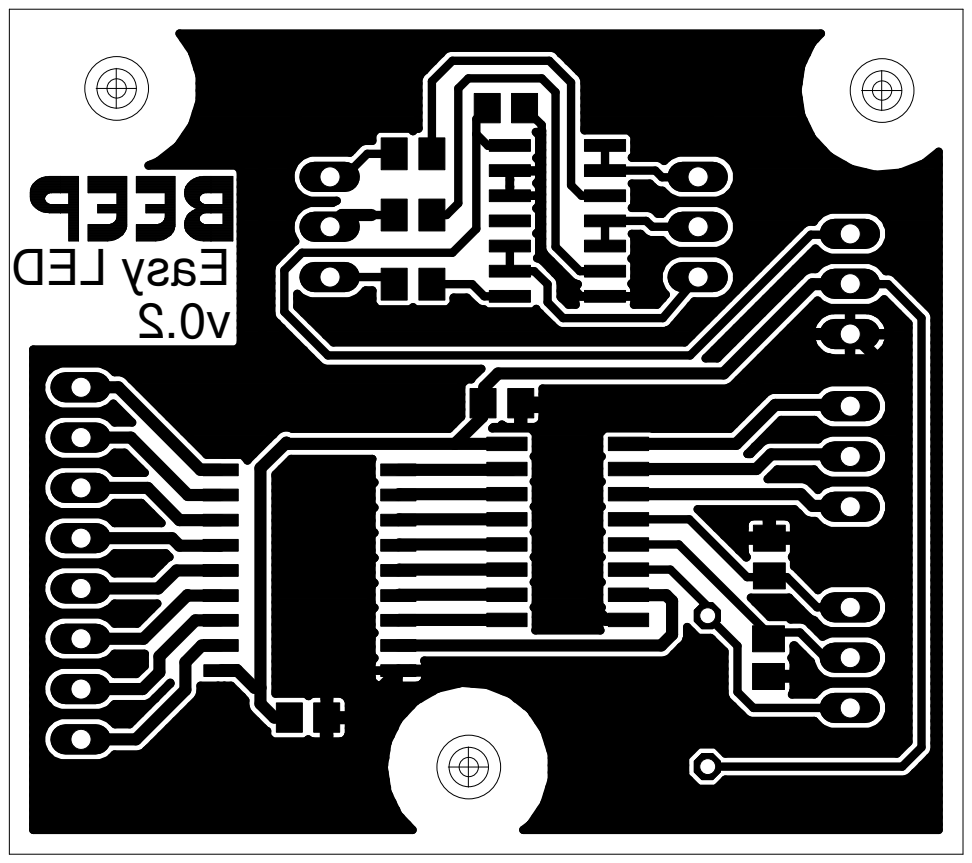
[picture p65: page 1]
