iti-luebeck/BEEP/Hardware/PCBs/BEEP_0.1/PCA9548A.pdf

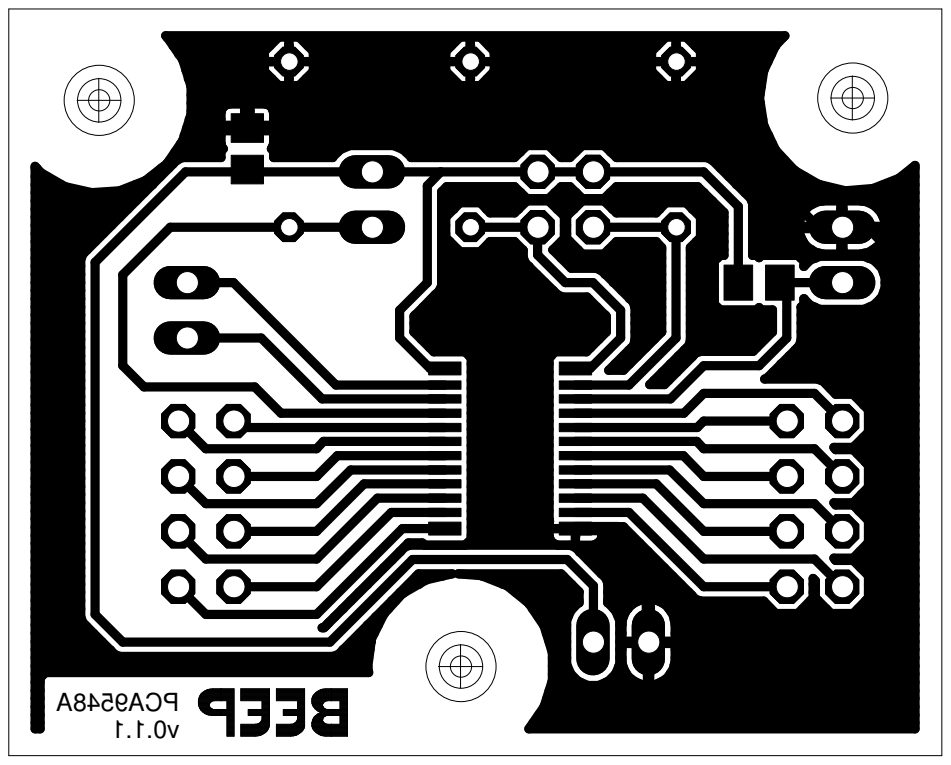
[picture p66: page 1]
