iti-luebeck/BEEP/Hardware/PCBs/BEEP_0.1/TCS3103.pdf

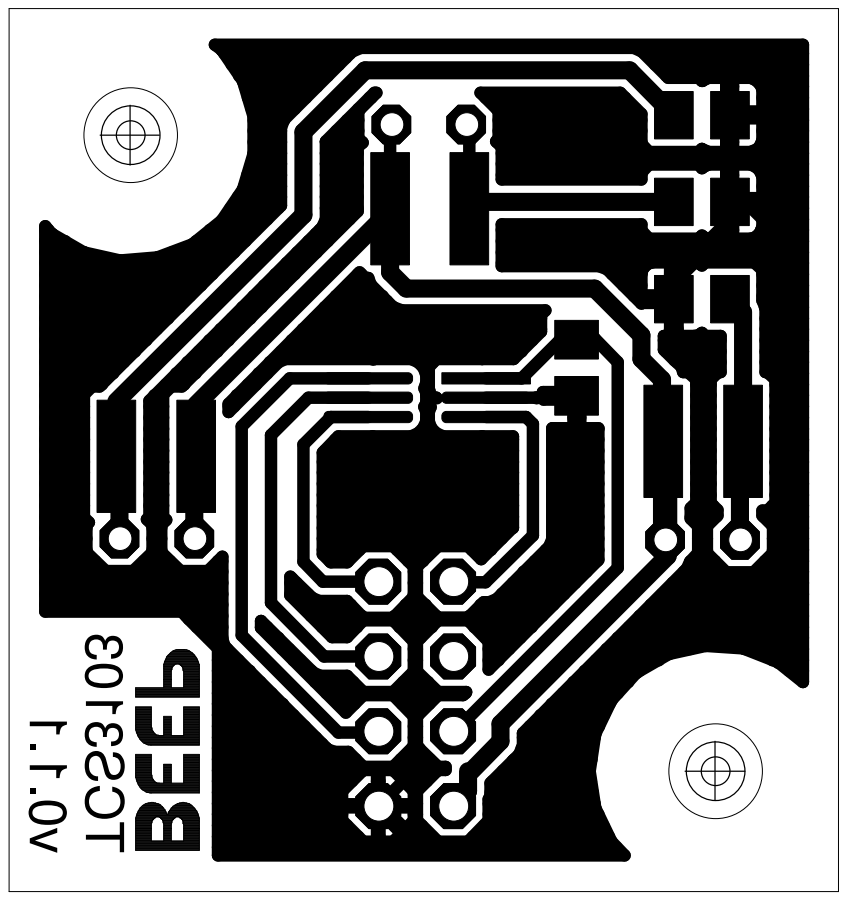
[picture p67: page 1]
