iti-luebeck/BEEP/Hardware/PCBs/BEEP_0.1/TCS32X0.pdf

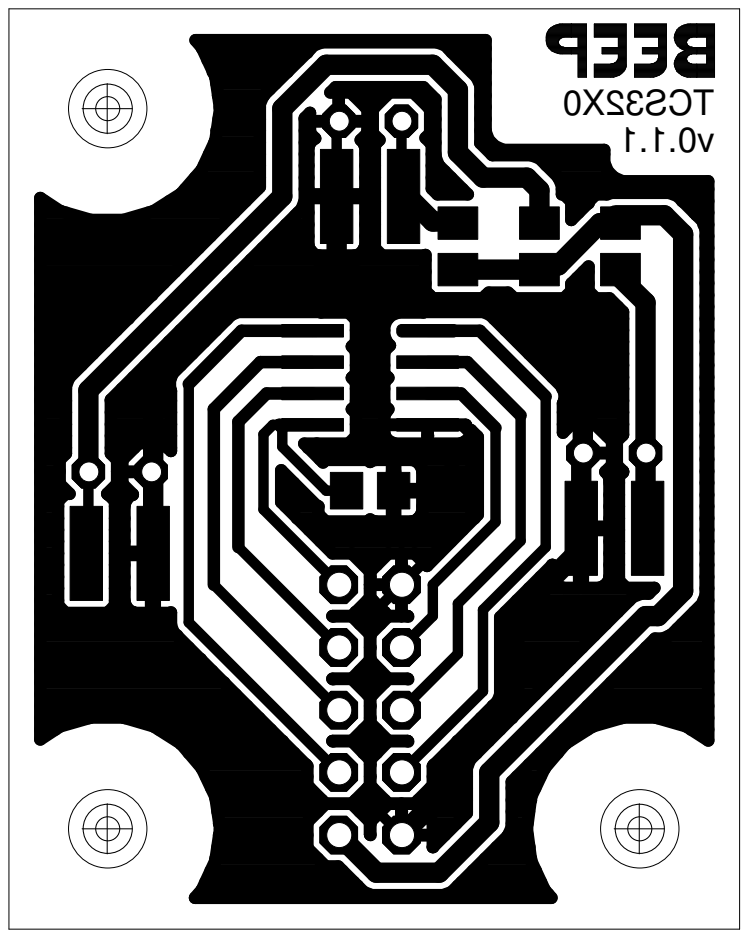
[picture p68: page 1]
