iti-luebeck/BEEP/Hardware/PCBs/BEEP_0.1/AIO/8_RGB_SMD_LEDs.pdf

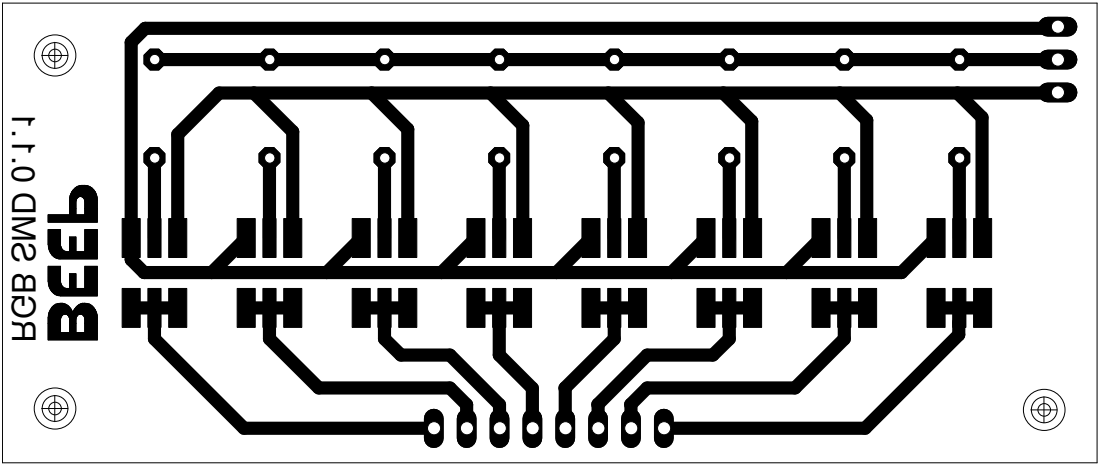
[picture p69: page 1]
RGB SMD 0.1.1
