iti-luebeck/BEEP/Hardware/PCBs/BEEP_0.1/AIO/AIO.pdf

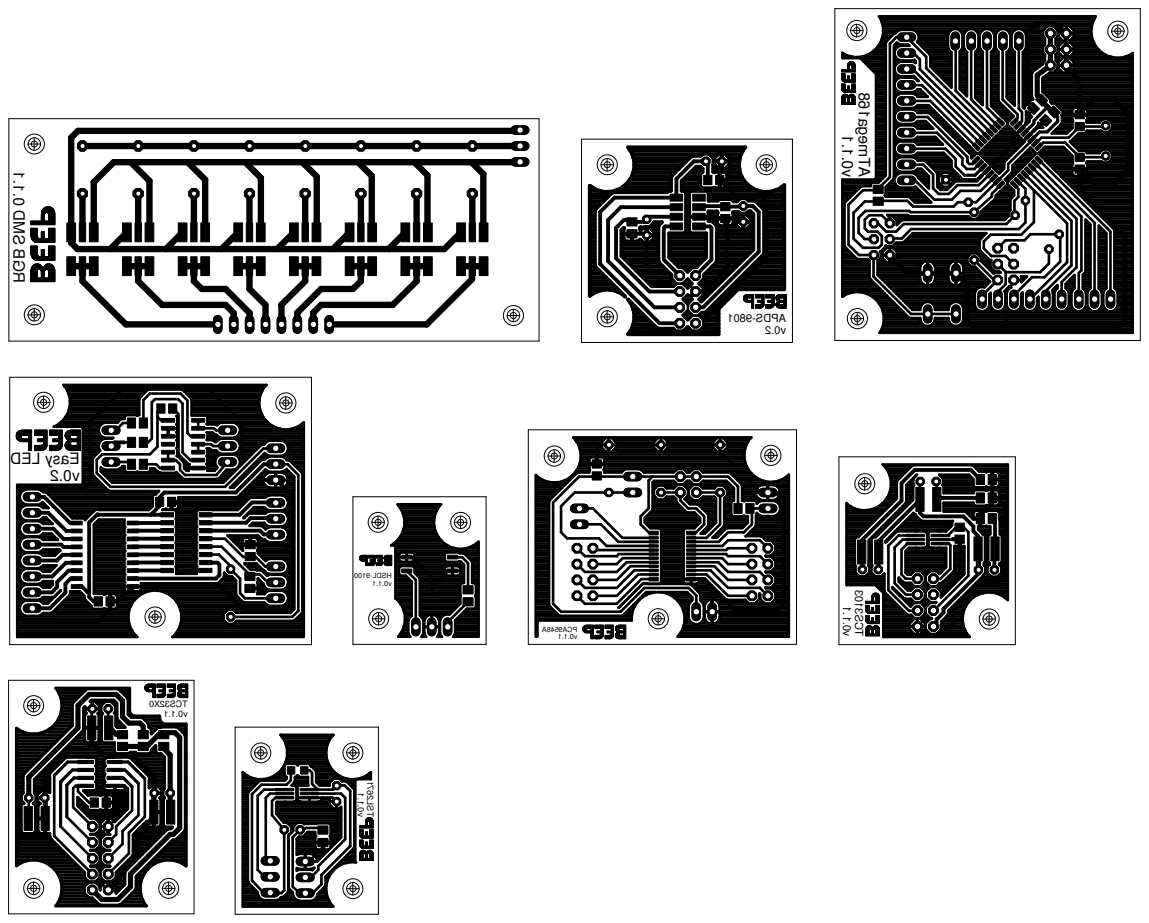
[picture p70: page 1]
RGB SMD 0.1.1; ATmega168; TSL2671 v0.1.1
