iti-luebeck/BEEP/Hardware/PCBs/BEEP_0.1/AIO/ATMEGA168.pdf

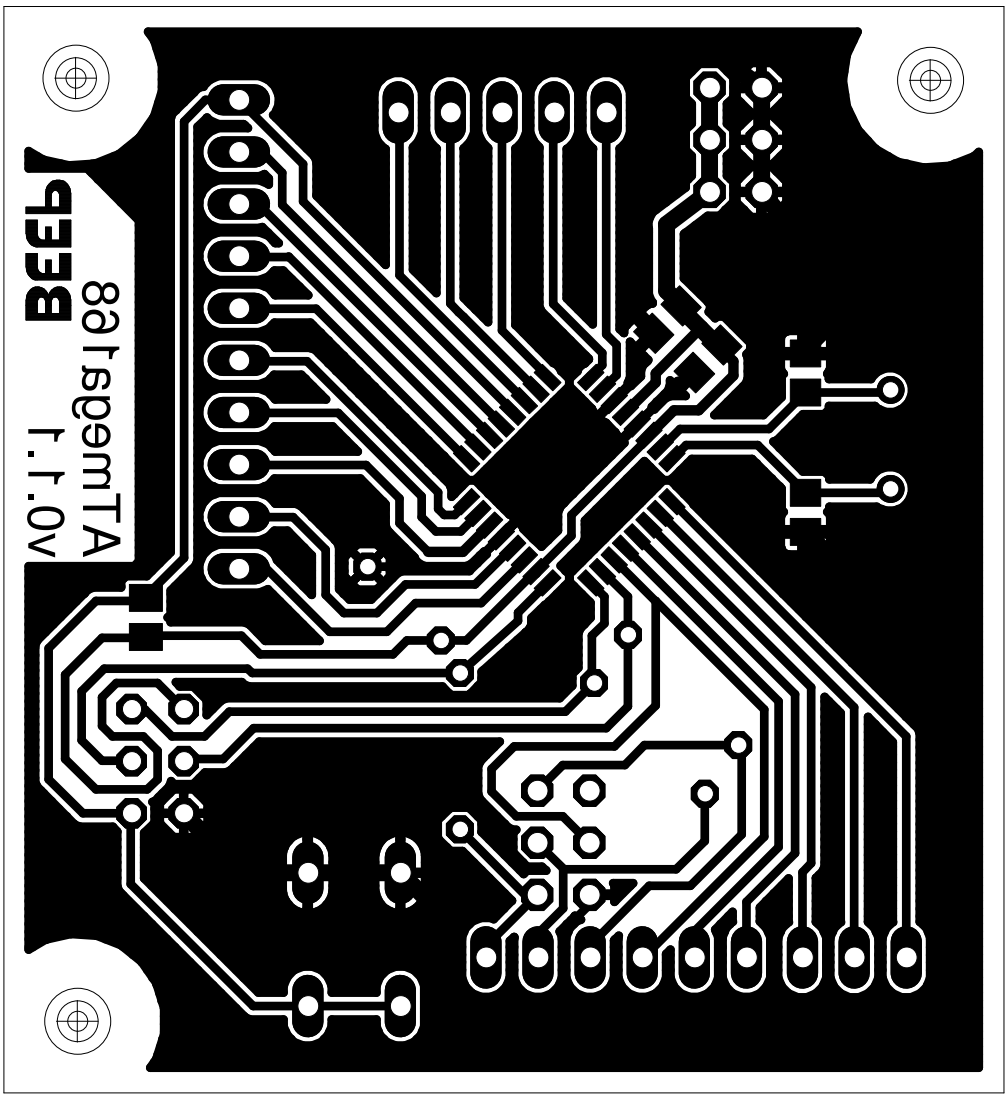
[picture p71: page 1]
ATmega168
