iti-luebeck/BEEP/Hardware/PCBs/BEEP_0.1/AIO/TCS3103.pdf

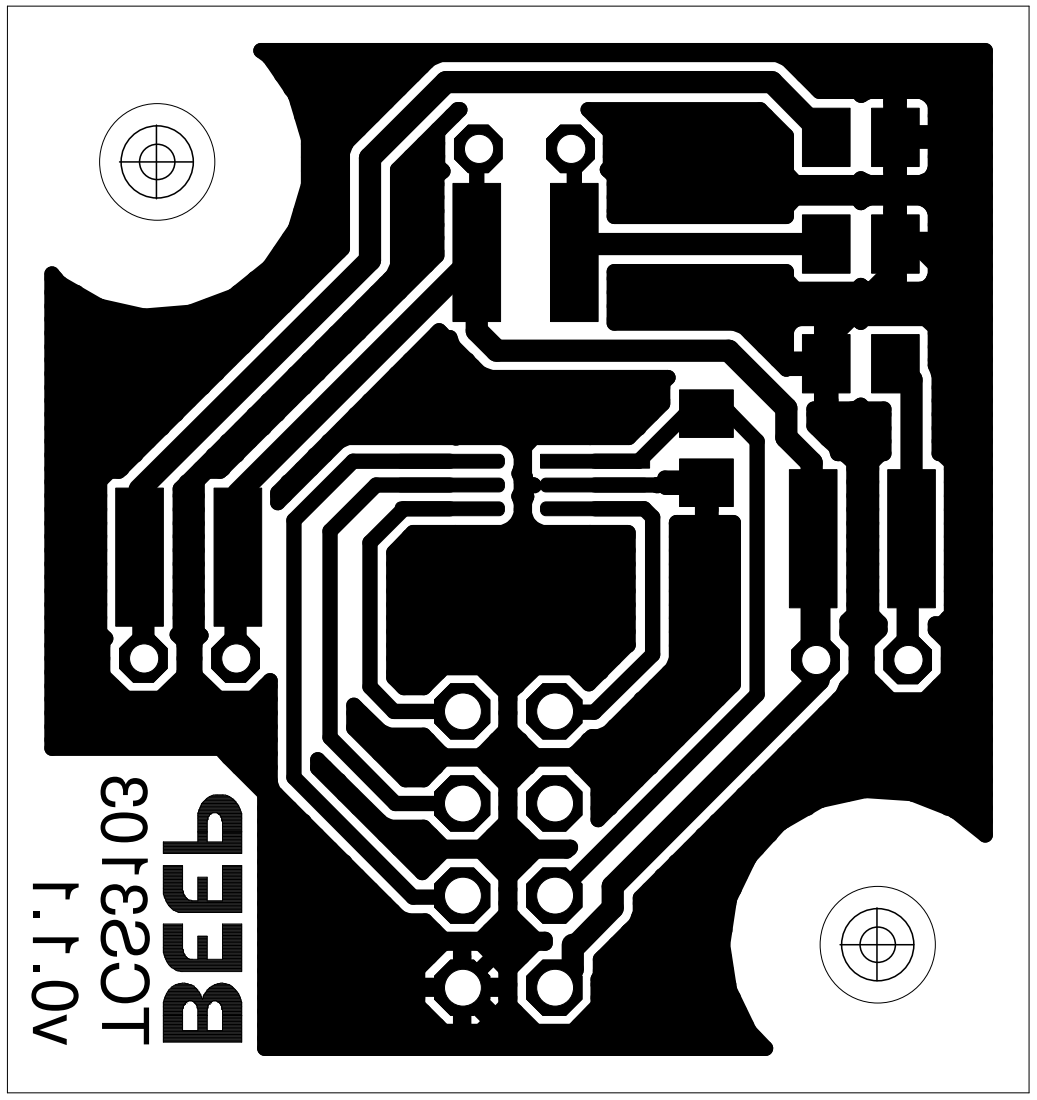
[picture p72: page 1]
TCS3103 v0.1.1
