iti-luebeck/BEEP/Hardware/PCBs/BEEP_0.1/AIO/TSL2671.pdf

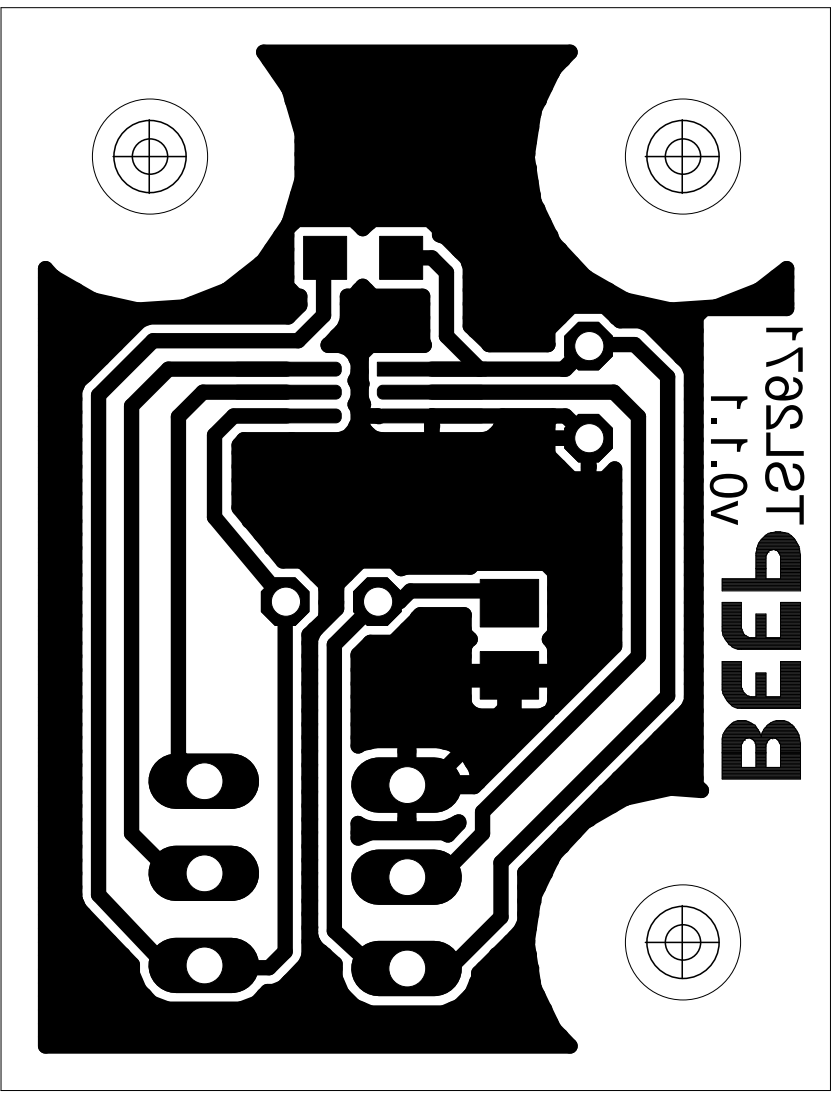
[picture p73: page 1]
TSL2671 v0.1.1
