iti-luebeck/BEEP/Hardware/Simulation/attiny_on_off/simv2.asc

C1: cap; 100µ
D4: schottky; 1N5817
D7: schottky; 1N5817
M2: pmos; IRF7220
Q2: npn; BC547B
R1: res; 1.2k
R2: res; 10k
R3: res; 1
R5: res; 10k
R6: res; 100k
R7: res; 1
R8: res; 10k
R10: res; 10k
R_Last: res; 10
S1: sw; SW_A
S2: sw
S3: sw
U1: 74hc125; VCC=3.3_supply  SPEED=1.0  TRIPDT=1e-9
U2: 74hc125; VCC=3.3_supply  SPEED=1.0  TRIPDT=1e-9
V1: voltage; PULSE(-1 1 500m 0 0 10m)
V2: voltage; 3.3
V5: voltage; 7
V6: voltage; PULSE(-1 1 100m 0 0 10m 50m 2)
Named nets: Sens, 0, _OFF, OUT, 3.3_supply, SENS
.tran 1
.inc DMN2075U.mod
.model SW SW()
.inc 74hc.lib
.model SW_A SW(Vt=5)
ATiny IO Ports
