iti-luebeck/BEEP/Hardware/Simulation/lm239_hysteresis/sim.asc

R1: res; 1meg
R2: res; 100k
R3: res; 100k
R4: res; 56k
R_LOAD: res; 100k
R_PULLUP: res; 4.7k
U1: opamp2; LM239
V1: voltage; 3.3
V3: voltage; SINE(2 0.7 27)
Named nets: 0, OUT
.inc LM239.mod
.tran 600m
