iti-luebeck/BEEP/Hardware/Simulation/mosfet_pwm_high_side/PWM.asc

D1: diode; 1N4148
D2: LED; LUW-W5AP
D5: diode; 1N4148
M1: pmos; nts4101p
MP2: pmos; irlml2244
R1: res; 50
R2: res; 1k
V1: voltage; 5
V2: voltage; PULSE(0 3 70u 0 0 70u 140u 8)
X: nmos; DI_DMN2075U
Named nets: 0
.tran 7m
.inc DMN2075U.mod
Simulate ULN2803
voltage drop ;)
.inc nts4101p.mod
.inc irlml2244.mod
