iti-luebeck/BEEP/Hardware/Simulation/attiny_on_off/simv3.asc

D1: schottky; 1N5817
D3: schottky; 1N5817
D4: schottky; 1N5817
D6: schottky; 1N5817
M1: nmos; DI_DMN2075U
Q1: pnp; BC557C
R1: res; 18k
R2: res; 10k
R4: res; 12k
R5: res; 10k
R7: res; 10k
R8: res; 1
R_Last: res; 10
S1: sw; SW_A
S2: sw
S3: sw
U2: 74hc125; VCC=3.3_supply  SPEED=1.0  TRIPDT=1e-9
V1: voltage; PULSE(-1 1 500m 0 0 10m)
V2: voltage; 3.3
V5: voltage; 7
V6: voltage; PULSE(-1 1 100m 0 0 10m 50m 2)
Named nets: Sens, 0, _OFF, OUT
.tran 1
.inc DMN2075U.mod
.model SW SW()
.inc 74hc.lib
.model SW_A SW(Vt=-2.5)
