iti-luebeck/BEEP/Hardware/Simulation/attiny_on_off/sim.asc

D1: zener; 1N750
D2: zener; 1N750
M1: nmos; DI_DMN2075U
R1: res; 100k
R2: res; 1k
R3: res; 1meg
R4: res; 10R
V1: voltage; 7
V2: voltage; 3.3
Named nets: 0
.tran 100m
.inc DMN2075U.mod
