iti-luebeck/BEEP/Hardware/Simulation/mosfet_power_switch/switch.asc

C1: cap; 1µF
C2: cap; 1000µ
M1: nmos; AO6408
M2: pmos; AO6407
R1: res; 10k
R2: res; 100k
R3: res; 10k
R4: res; 5
S1: sw
V1: voltage; 7.4
V2: voltage; PULSE(-1 1 5 0 0 1 10)
Named nets: 0, OUT
.tran 60
.model SW SW()
