iti-luebeck/BEEP/Hardware/PCBs/eval_boards/lm239d.brd

## EAGLE design Hardware/PCBs/eval_boards/lm239d.brd (2013-12-19)

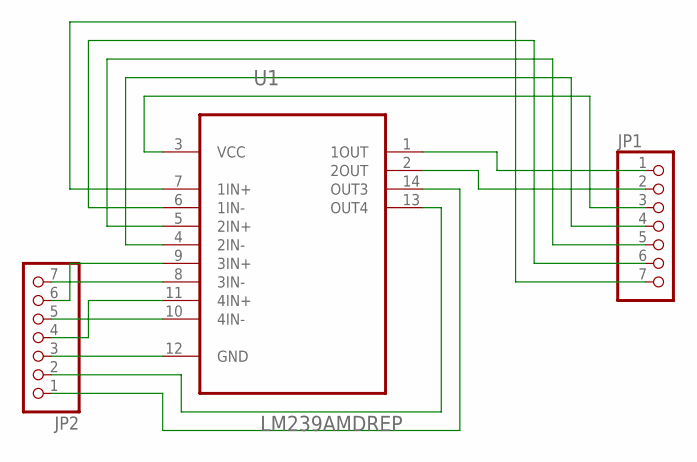
[picture p74: schematic lm239d.sch]

Parts:
JP1, JP2: PINHD-1X7; 1X07
U1: LM239AMDREP; SOIC127P600X175-14N

Connections:
unnamed: JP1.1, U1.1 (1OUT)
unnamed: JP1.2, U1.2 (2OUT)
unnamed: JP1.3, U1.3 (VCC)
unnamed: JP1.4, U1.4 (2IN-)
unnamed: JP1.5, U1.5 (2IN+)
unnamed: JP1.6, U1.6 (1IN-)
unnamed: JP1.7, U1.7 (1IN+)
unnamed: JP2.7, U1.8 (3IN-)
unnamed: JP2.6, U1.9 (3IN+)
unnamed: JP2.4, U1.11 (4IN+)
unnamed: JP2.5, U1.10 (4IN-)
unnamed: JP2.3, U1.12 (GND)
unnamed: JP2.2, U1.13 (OUT4)
unnamed: JP2.1, U1.14 (OUT3)

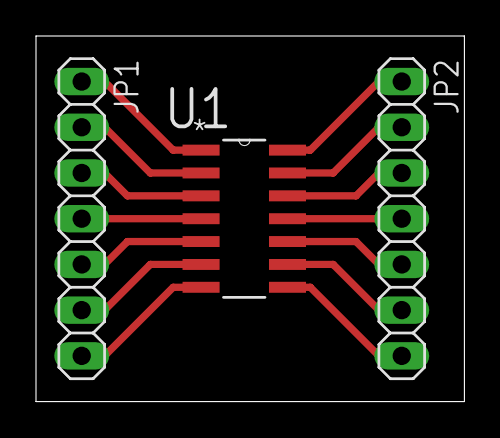
[picture p75: board lm239d.brd from above]

Board: 2 copper layers, 23.8 x 20.3 mm, 3 parts (0 on the bottom side), 14 nets.
