iti-luebeck/BEEP/Hardware/PCBs/BEEP_0.2/bottom.brd

## EAGLE design Hardware/PCBs/BEEP_0.2/bottom.brd (2013-12-19)

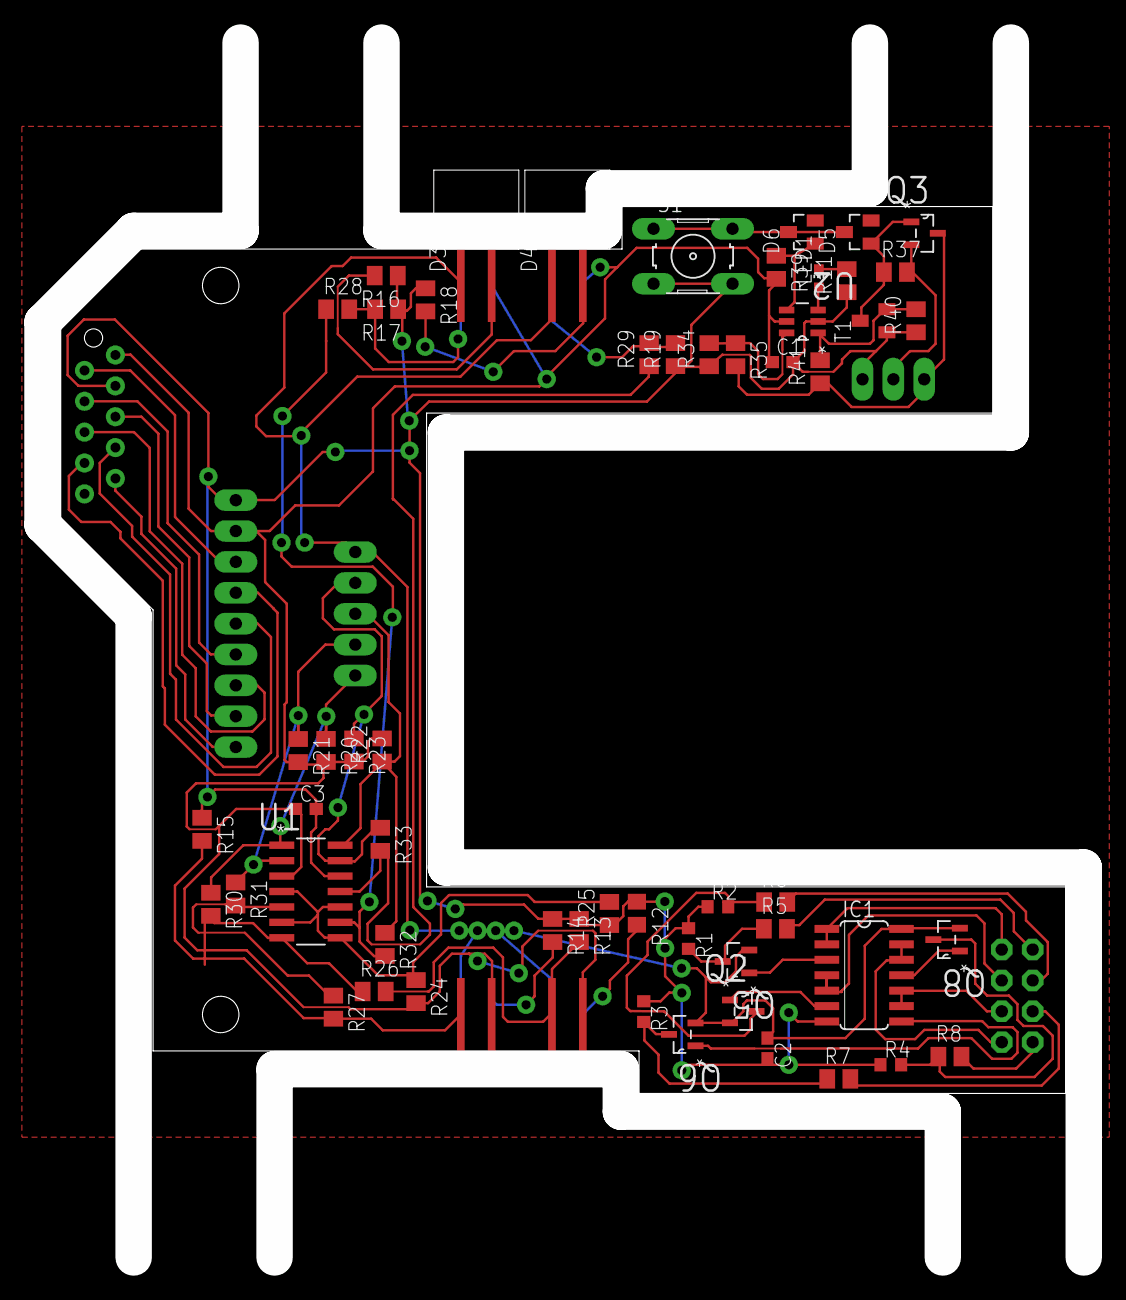
[picture p76: board bottom.brd from above]

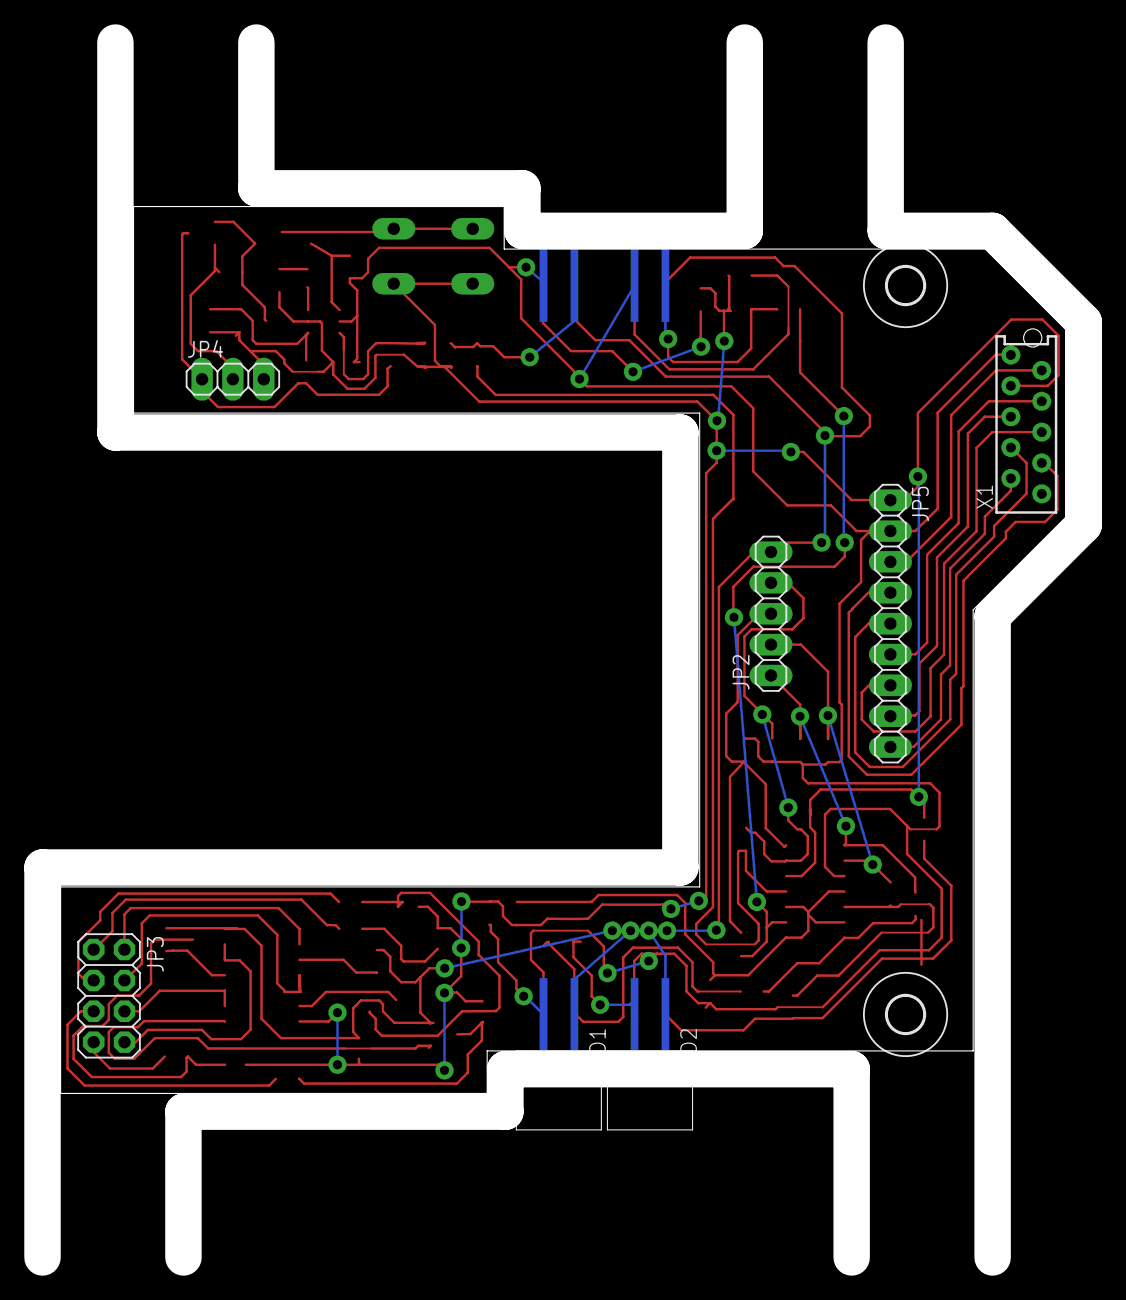
[picture p77: board bottom.brd from below]

Board: 2 copper layers, 82.7 x 73.0 mm, 64 parts (9 on the bottom side), 52 nets.

Parts:
C1, C2: 100n; C0603
C3: C0603
D1, D2, D3, D4: CNY70
D5, D6: BAS40; SOT23
IC1: 74HCT00D; SO14
JP2: 1X05
JP3: 2X04
JP4: 1X03
JP5: 1X09
LED1: CHIP-LED0603
Q2, Q3, Q5, Q6, Q8: IRLML2244; SOT95P240X112-3N
R1, R2, R3, R4: 10k; R0603
R5, R6, R7: 22R; M0805
R8: 0; M0805
R11: 100R; M0805
R12: 330R; R0805
R13, R15, R17, R19, R25, R37, R41: 10k; M0805
R14, R16, R18: 330R; M0805
R20, R21, R22, R23: 4.7k; M0805
R24: 5.6k; M0805
R26, R27, R28, R29, R39: 100k; M0805
R30, R31, R32, R33: 1M; M0805
R34, R35: M0805
R40: 1k; M0805
S1: B3F-10XX
T1: SOT23-EBC
U1: LM239AMDREP; SOIC127P600X175-14N
U2: ATTINY10-TSHR; SOT95P280X145-6N
U$1, U$2: 3,0
X1: FTOP-10

Connections:
!OFF!: R40.2, R41.2, T1.B, U2.1
+3V3: C1.1, C3.1, D1.TRANS_C, D2.TRANS_C, D3.TRANS_C, D4.TRANS_C, JP5.2, R20.2, R21.2, R22.2, R23.2, R24.2, R39.2, U1.3, U2.5, X1.10
+5V: C2.1, D1.LED_A, D2.LED_A, D3.LED_A, D4.LED_A, IC1.14, JP2.5, Q2.S, Q5.S, Q6.S, Q8.S
BATT: JP4.2, Q3.S, R37.2
COLOR_DIODE_1: JP5.5, X1.4
COLOR_DIODE_2: JP5.4, X1.3
COLOR_FREQ_OUT: JP5.6, X1.7
COLOR_SENSOR_1: JP5.9, X1.2
COLOR_SENSOR_2: JP5.8, X1.6
COLOR_SENSOR_3: JP5.7, X1.5
COLOR_SENSOR_PWM_LED: JP5.3, X1.9
ENC_L1: JP2.1, R20.1, R30.1, U1.1
ENC_L1_RAW: D1.TRANS_E, R13.2, R26.2
ENC_L2: JP2.2, R21.1, R31.1, U1.2
ENC_L2_RAW: D2.TRANS_E, R15.2, R27.2
ENC_R1: JP2.3, R22.1, R32.1, U1.14
ENC_R1_RAW: D3.TRANS_E, R17.2, R28.2
ENC_R2: JP2.4, R23.1, R33.1, U1.13
ENC_R2_RAW: D4.TRANS_E, R19.2, R29.2
GND: C1.2, C2.2, C3.2, IC1.7, JP4.3, JP5.1, R1.1, R2.1, R3.1, R4.1, R11.1, R12.1, R13.1, R14.1, R15.1, R16.1, R17.1, R18.1, R19.1, R25.1, R34.1, R40.1, S1.3, S1.4, T1.E, U1.12, U2.2, X1.8
unnamed: IC1.3, Q5.G
unnamed: IC1.6, Q2.G
unnamed: Q5.D, R1.2, R5.1
unnamed: IC1.8, Q6.G
unnamed: IC1.11, Q8.G
unnamed: LED1.C, R11.2
unnamed: D5.1, Q3.G, R37.1, T1.C
unnamed: D5.3, D6.3, S1.1, S1.2
unnamed: Q8.D, R4.2, R8.1
unnamed: Q6.D, R3.2, R7.1
unnamed: Q2.D, R2.2, R6.1
unnamed: D1.LED_C, R12.2
unnamed: R26.1, R30.2, U1.7
unnamed: R27.1, R31.2, U1.5
unnamed: D2.LED_C, R14.2
unnamed: R28.1, R32.2, U1.9
unnamed: D3.LED_C, R16.2
unnamed: R29.1, R33.2, U1.11
unnamed: D4.LED_C, R18.2
PB1/TPICLK: LED1.A, U2.3
PWM_IN1: IC1.1, IC1.2, JP3.2
PWM_IN2: IC1.4, IC1.5, JP3.4
PWM_IN3: IC1.9, IC1.10, JP3.6
PWM_IN4: IC1.12, IC1.13, JP3.8
PWM_OUT1: JP3.1, R5.2
PWM_OUT2: JP3.3, R6.2
PWM_OUT3: JP3.5, R7.2
PWM_OUT4: JP3.7, R8.2
RESET: R34.2, R35.1, U2.6
SENS: D6.1, R39.1, U2.4
SWITCHED_BATT: JP4.1, Q3.D, R35.2, R41.1
U_REF: R24.1, R25.2, U1.4, U1.6, U1.8, U1.10
