iti-luebeck/BEEP/Hardware/PCBs/eval_boards/tiny10.brd

## EAGLE design Hardware/PCBs/eval_boards/tiny10.brd (2013-12-19)

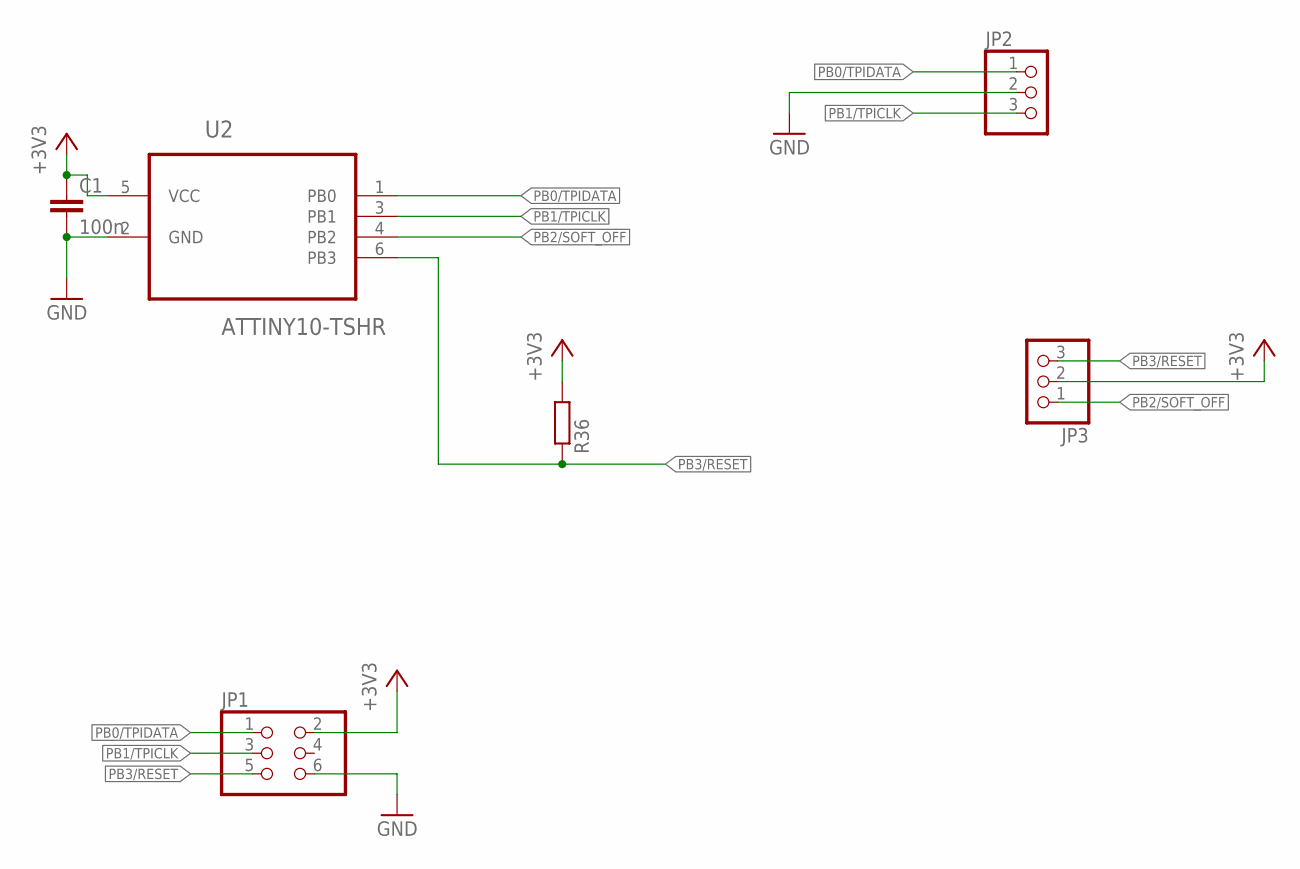
[picture p78: schematic tiny10.sch]

Parts:
C1: 100n; C0603
JP1: PINHD-2X3; 2X03
JP2, JP3: PINHD-1X3; 1X03
R36: R-EU_M0805; M0805
U2: ATTINY10-TSHR; SOT95P280X145-6N

Connections:
+3V3: C1.1, JP1.2, JP3.2, R36.2, U2.5 (VCC)
GND: C1.2, JP1.6, JP2.2, U2.2 (GND)
PB0/TPIDATA: JP1.1, JP2.1, U2.1 (PB0)
PB1/TPICLK: JP1.3, JP2.3, U2.3 (PB1)
PB2/SOFT_OFF: JP3.1, U2.4 (PB2)
PB3/RESET: JP1.5, JP3.3, R36.1, U2.6 (PB3)

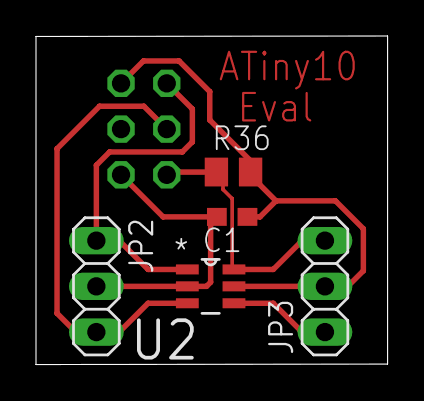
[picture p79: board tiny10.brd from above]

Board: 2 copper layers, 19.5 x 18.3 mm, 6 parts (1 on the bottom side), 6 nets.
