iti-luebeck/BEEP/Hardware/PCBs/BEEP_0.2/rgb_and_irdistance_side.brd

## EAGLE design Hardware/PCBs/BEEP_0.2/rgb_and_irdistance_side.brd (2013-12-19)

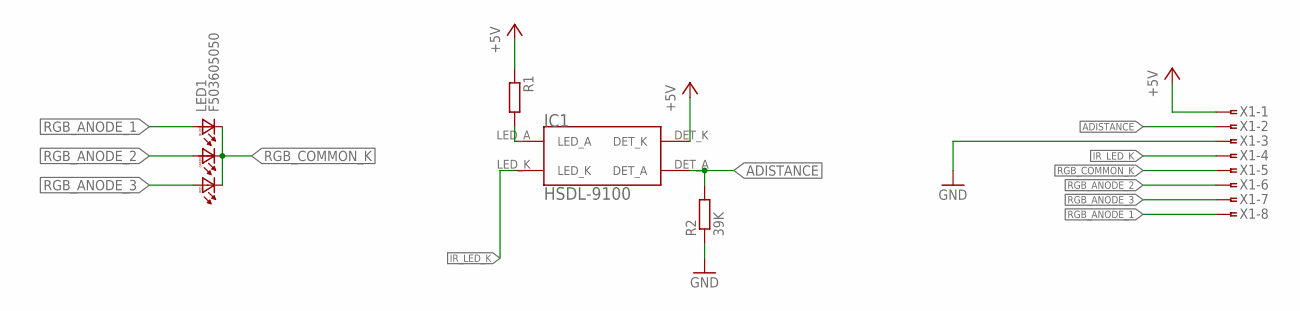
[picture p80: schematic rgb_and_irdistance_side.sch]

Parts:
IC1: HSDL-9100
LED1: F503605050; 5050LED
R1: R-EU_M0805; M0805
R2: 39K; M0805
X1: FTOP-8

Connections:
+5V: IC1.DET_K, R1.1, X1.1
ADISTANCE: IC1.DET_A, R2.2, X1.2
GND: R2.1, X1.3
IR_LED_K: IC1.LED_K, X1.4
unnamed: IC1.LED_A, R1.2
RGB_ANODE_1: LED1.B1 (BA), X1.8
RGB_ANODE_2: LED1.G1 (GA), X1.6
RGB_ANODE_3: LED1.R1 (RA), X1.7
RGB_COMMON_K: LED1.B2 (BC), LED1.G2 (GC), LED1.R2 (RC), X1.5

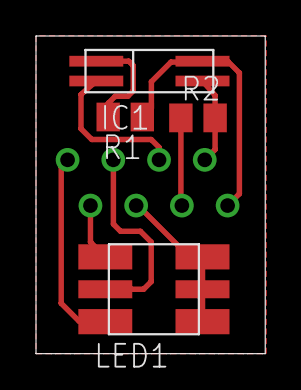
[picture p81: board rgb_and_irdistance_side.brd from above]

Board: 2 copper layers, 12.7 x 17.7 mm, 5 parts (1 on the bottom side), 9 nets.
