iti-luebeck/BEEP/Hardware/PCBs/BEEP_0.2/color_sensor.brd

## EAGLE design Hardware/PCBs/BEEP_0.2/color_sensor.brd (2013-12-19)

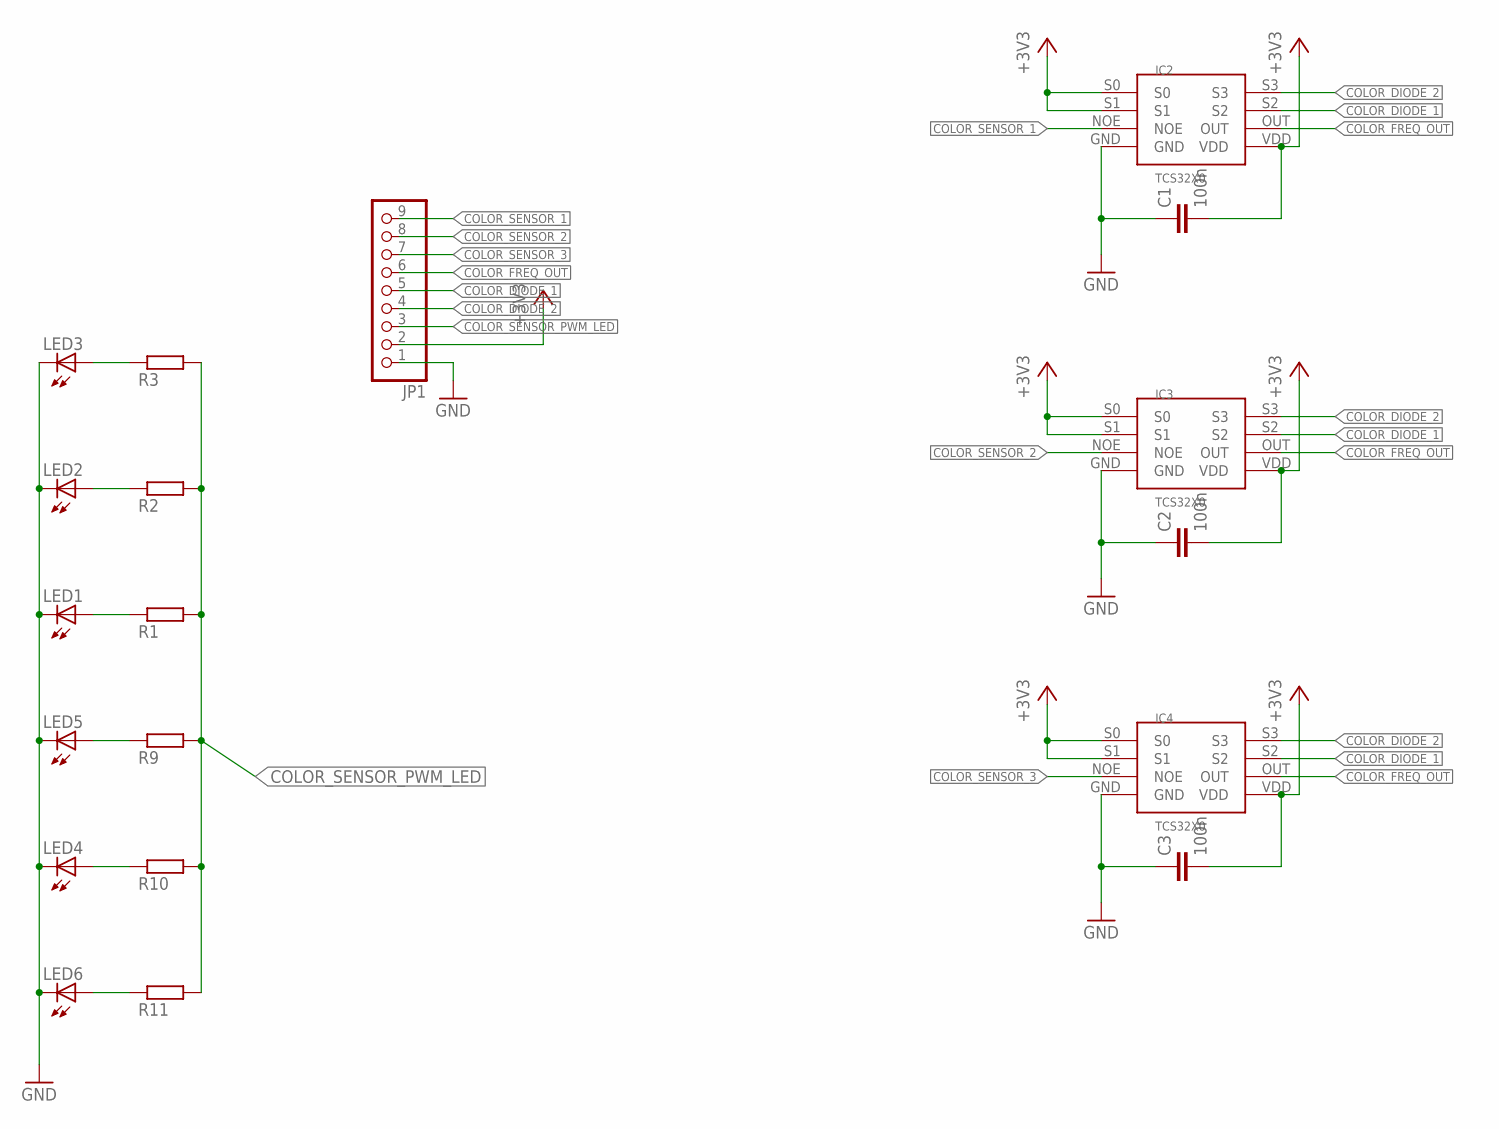
[picture p82: schematic color_sensor.sch]

Parts:
C1, C2, C3: 100n; C0805
IC2, IC3, IC4: TCS32X0
JP1: PINHD-1X9; 1X09
LED1, LED2, LED3, LED4, LED5, LED6: NFSG036BT
R1, R2, R3, R9, R10, R11: R-EU_M0805; M0805

Connections:
+3V3: C1.2, C2.2, C3.2, IC2.S0, IC2.S1, IC2.VDD, IC3.S0, IC3.S1, IC3.VDD, IC4.S0, IC4.S1, IC4.VDD, JP1.2
COLOR_DIODE_1: IC2.S2, IC3.S2, IC4.S2, JP1.5
COLOR_DIODE_2: IC2.S3, IC3.S3, IC4.S3, JP1.4
COLOR_FREQ_OUT: IC2.OUT, IC3.OUT, IC4.OUT, JP1.6
COLOR_SENSOR_1: IC2.NOE, JP1.9
COLOR_SENSOR_2: IC3.NOE, JP1.8
COLOR_SENSOR_3: IC4.NOE, JP1.7
COLOR_SENSOR_PWM_LED: JP1.3, R1.2, R2.2, R3.2, R9.2, R10.2, R11.2
GND: C1.1, C2.1, C3.1, IC2.GND, IC3.GND, IC4.GND, JP1.1, LED1.C, LED2.C, LED3.C, LED4.C, LED5.C, LED6.C
unnamed: LED1.A, R1.1
unnamed: LED2.A, R2.1
unnamed: LED3.A, R3.1
unnamed: LED5.A, R9.1
unnamed: LED4.A, R10.1
unnamed: LED6.A, R11.1

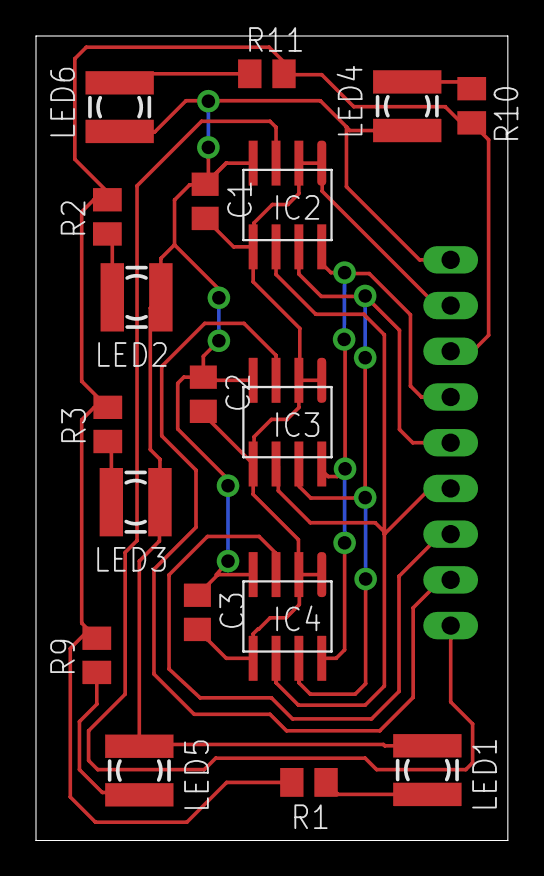
[picture p83: board color_sensor.brd from above]

Board: 2 copper layers, 26.2 x 44.7 mm, 19 parts (1 on the bottom side), 15 nets.
