iti-luebeck/BEEP/Hardware/PCBs/BEEP_0.2/high_side_driver_fix.brd

## EAGLE design Hardware/PCBs/BEEP_0.2/high_side_driver_fix.brd (2013-09-10)

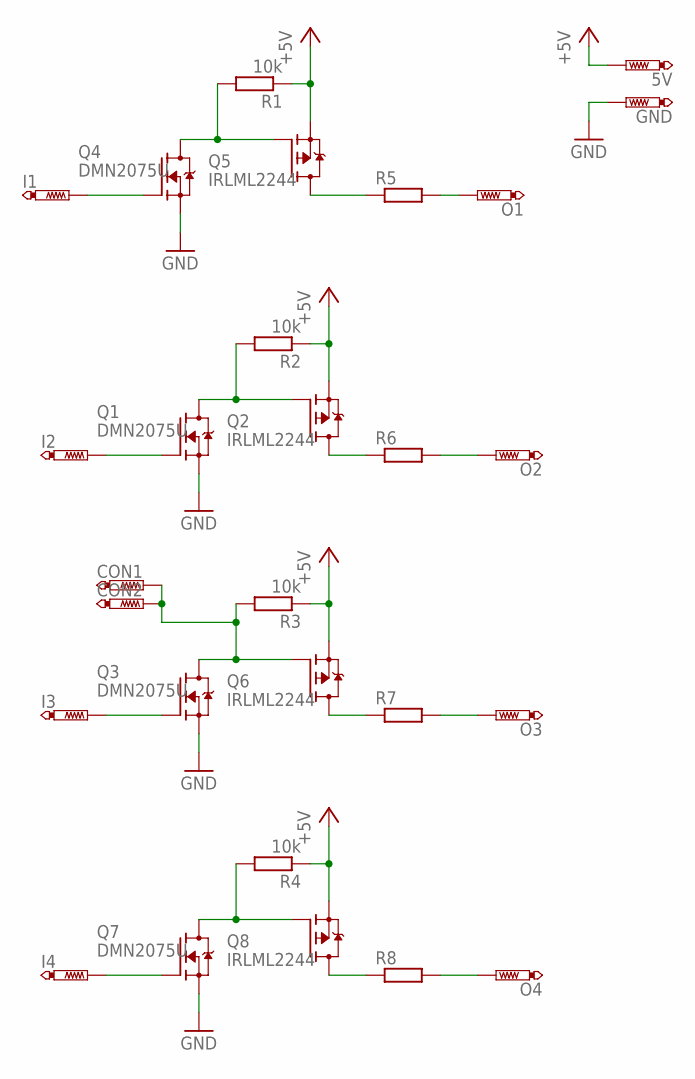
[picture p84: schematic high_side_driver_fix.sch]

Parts:
5V: PTR1TP11SQ; TP11SQ
CON1, CON2: PTR1TP08SQ; TP08SQ
GND: PTR1TP11SQ; TP11SQ
I1, I2, I3, I4: PTR1TP11SQ; TP11SQ
O1, O2, O3, O4: PTR1TP11SQ; TP11SQ
Q1, Q3, Q4, Q7: DMN2075U; SOT95P240X112-3N
Q2, Q5, Q6, Q8: IRLML2244; SOT95P240X112-3N
R1, R2, R3, R4: 10k; R0603
R5, R6, R7, R8: R-EU_M0805; M0805

Connections:
+5V: 5V.TP, Q2.S, Q5.S, Q6.S, Q8.S, R1.1, R2.1, R3.1, R4.1
GND: GND.TP, Q1.S, Q3.S, Q4.S, Q7.S
unnamed: Q4.D, Q5.G, R1.2
unnamed: I1.TP, Q4.G
unnamed: Q5.D, R5.1
unnamed: Q1.D, Q2.G, R2.2
unnamed: I2.TP, Q1.G
unnamed: O2.TP, R6.2
unnamed: CON1.TP, CON2.TP, Q3.D, Q6.G, R3.2
unnamed: I3.TP, Q3.G
unnamed: O3.TP, R7.2
unnamed: Q7.D, Q8.G, R4.2
unnamed: I4.TP, Q7.G
unnamed: O4.TP, R8.2
unnamed: Q8.D, R8.1
unnamed: Q6.D, R7.1
unnamed: Q2.D, R6.1
unnamed: O1.TP, R5.2

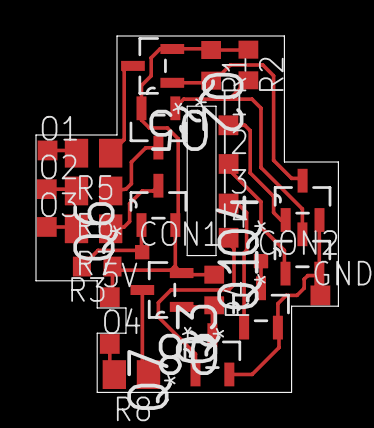
[picture p85: board high_side_driver_fix.brd from above]

Board: 2 copper layers, 16.8 x 19.8 mm, 28 parts (0 on the bottom side), 18 nets.
