iti-luebeck/BEEP/Hardware/PCBs/BEEP_0.2/rgb_and_irdistance_side1.brd

## EAGLE design Hardware/PCBs/BEEP_0.2/rgb_and_irdistance_side1.brd (2013-08-02)

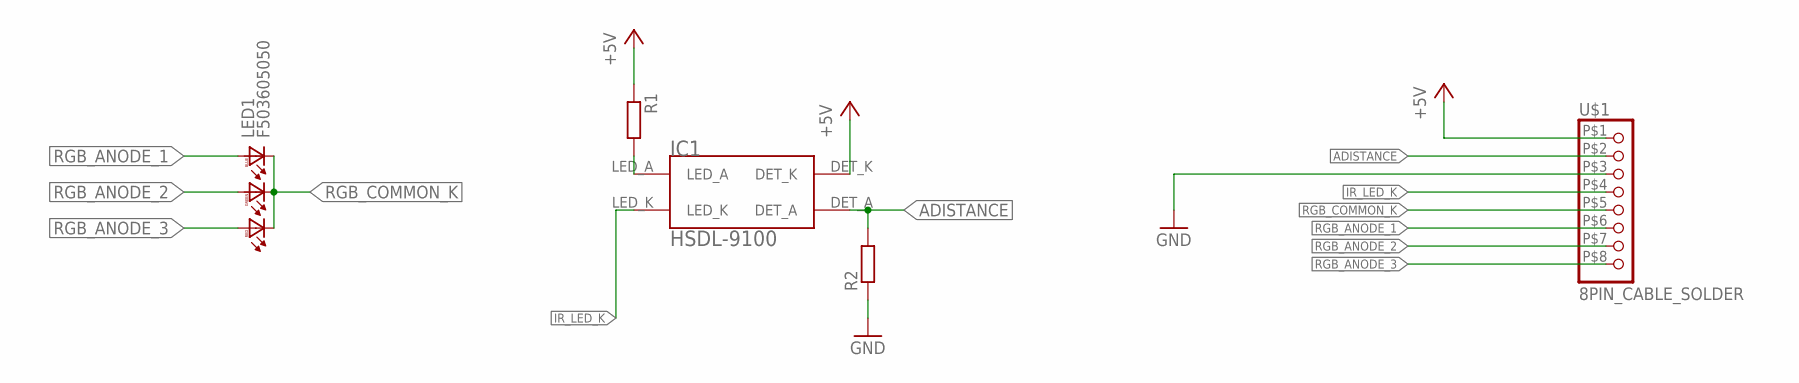
[picture p86: schematic rgb_and_irdistance_side1.sch]

Parts:
IC1: HSDL-9100
LED1: F503605050; 5050LED
R1, R2: R-EU_M0805; M0805
U$1: 8PIN_CABLE_SOLDER

Connections:
+5V: IC1.DET_K, R1.1, U$1.P$1 (1)
ADISTANCE: IC1.DET_A, R2.2, U$1.P$2 (2)
GND: R2.1, U$1.P$3 (3)
IR_LED_K: IC1.LED_K, U$1.P$4 (4)
unnamed: IC1.LED_A, R1.2
RGB_ANODE_1: LED1.B1 (BA), U$1.P$6 (6)
RGB_ANODE_2: LED1.G1 (GA), U$1.P$7 (7)
RGB_ANODE_3: LED1.R1 (RA), U$1.P$8 (8)
RGB_COMMON_K: LED1.B2 (BC), LED1.G2 (GC), LED1.R2 (RC), U$1.P$5 (5)

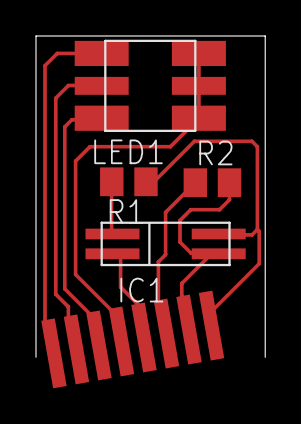
[picture p87: board rgb_and_irdistance_side1.brd from above]

Board: 2 copper layers, 12.7 x 17.9 mm, 5 parts (0 on the bottom side), 9 nets.
