iti-luebeck/BEEP/Hardware/PCBs/BEEP_0.1/Easy_LED.brd

## EAGLE design Hardware/PCBs/BEEP_0.1/Easy_LED.brd (2013-05-05)

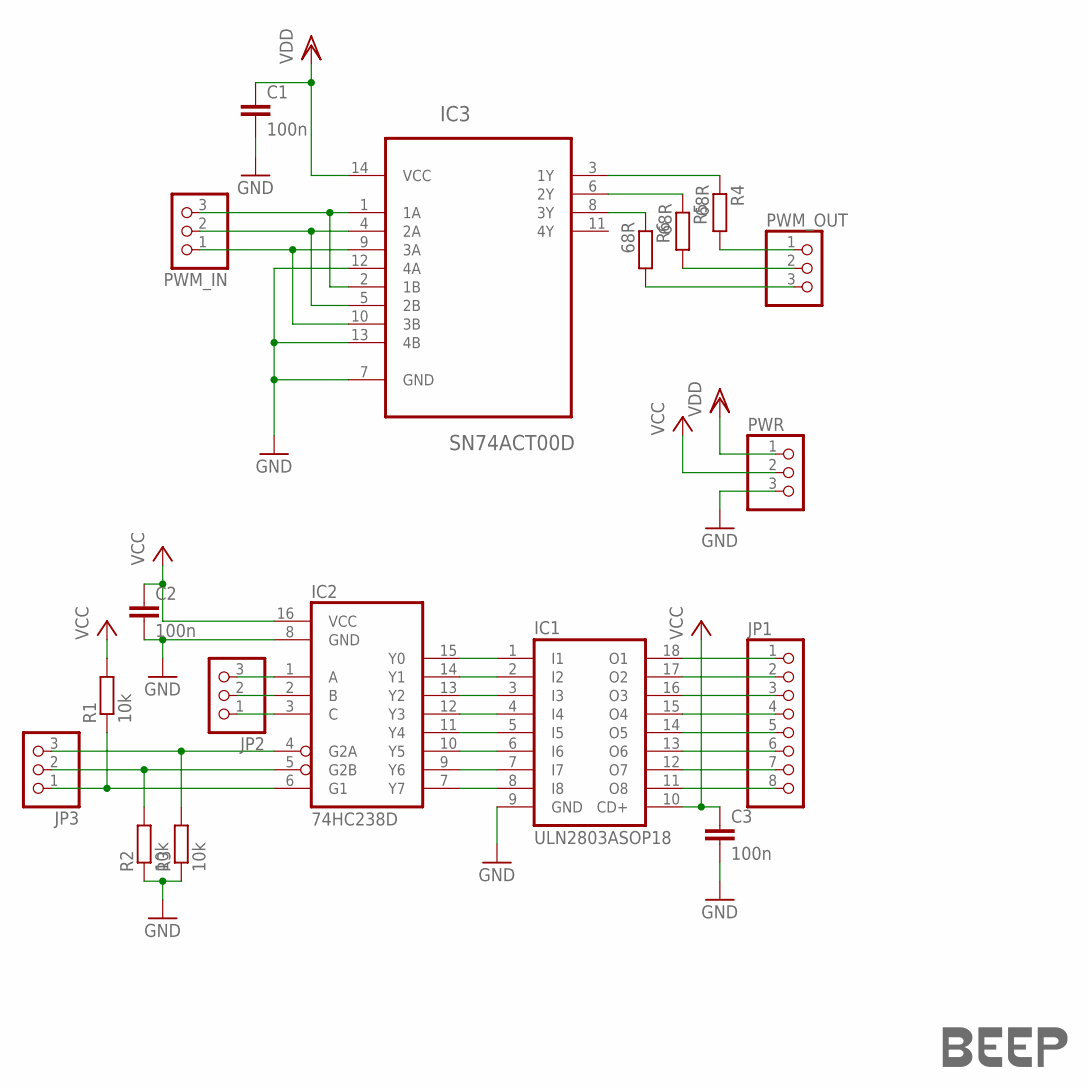
[picture p92: schematic Easy_LED.sch]

Parts:
C1, C2, C3: 100n; C0805
IC1: ULN2803ASOP18; SOP18
IC2: 74HC238D; SO16
IC3: SN74ACT00D; SOIC127P600X175-14N
JP1: PINHD-1X8; 1X08
JP2, JP3: PINHD-1X3; 1X03
PWM_IN: PINHD-1X3; 1X03
PWM_OUT: PINHD-1X3; 1X03
PWR: PINHD-1X3; 1X03
R1: 10k; 0207/7
R2, R3: 10k; M0805
R4, R5, R6: 68R; M0805
U$4: LOGO-COPPER6; COPPER6

Connections:
GND: C1.2, C2.2, C3.2, IC1.9 (GND), IC2.8 (GND), IC3.7 (GND), IC3.12 (4A), IC3.13 (4B), PWR.3, R2.1, R3.1
unnamed: IC1.17 (O2), JP1.2
unnamed: IC1.16 (O3), JP1.3
unnamed: IC1.15 (O4), JP1.4
unnamed: IC1.14 (O5), JP1.5
unnamed: IC1.13 (O6), JP1.6
unnamed: IC1.12 (O7), JP1.7
unnamed: IC1.18 (O1), JP1.1
unnamed: IC1.1 (I1), IC2.15 (Y0)
unnamed: IC1.2 (I2), IC2.14 (Y1)
unnamed: IC1.3 (I3), IC2.13 (Y2)
unnamed: IC1.11 (O8), JP1.8
unnamed: IC3.1 (1A), IC3.2 (1B), PWM_IN.3
unnamed: IC3.4 (2A), IC3.5 (2B), PWM_IN.2
unnamed: IC3.9 (3A), IC3.10 (3B), PWM_IN.1
unnamed: IC1.4 (I4), IC2.12 (Y3)
unnamed: IC1.5 (I5), IC2.11 (Y4)
unnamed: IC1.6 (I6), IC2.10 (Y5)
unnamed: PWM_OUT.3, R6.2
unnamed: PWM_OUT.2, R5.2
unnamed: PWM_OUT.1, R4.2
unnamed: IC3.3 (1Y), R4.1
unnamed: IC1.7 (I7), IC2.9 (Y6)
unnamed: IC1.8 (I8), IC2.7 (Y7)
unnamed: IC2.1 (A), JP2.3
unnamed: IC3.6 (2Y), R5.1
unnamed: IC3.8 (3Y), R6.1
unnamed: IC2.2 (B), JP2.2
unnamed: IC2.3 (C), JP2.1
unnamed: IC2.4 (G2A), JP3.3, R3.2
unnamed: IC2.5 (G2B), JP3.2, R2.2
unnamed: IC2.6 (G1), JP3.1, R1.1
VCC: C2.1, C3.1, IC1.10 (CD+), IC2.16 (VCC), PWR.2, R1.2
VDD: C1.1, IC3.14 (VCC), PWR.1

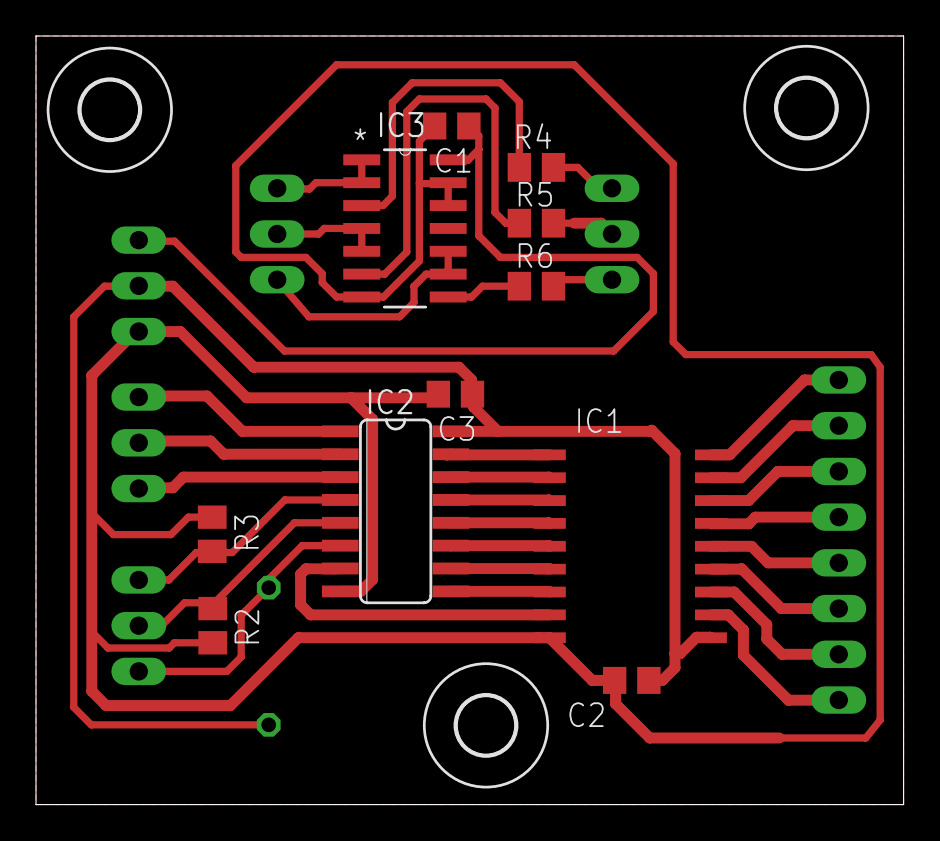
[picture p93: board Easy_LED.brd from above]

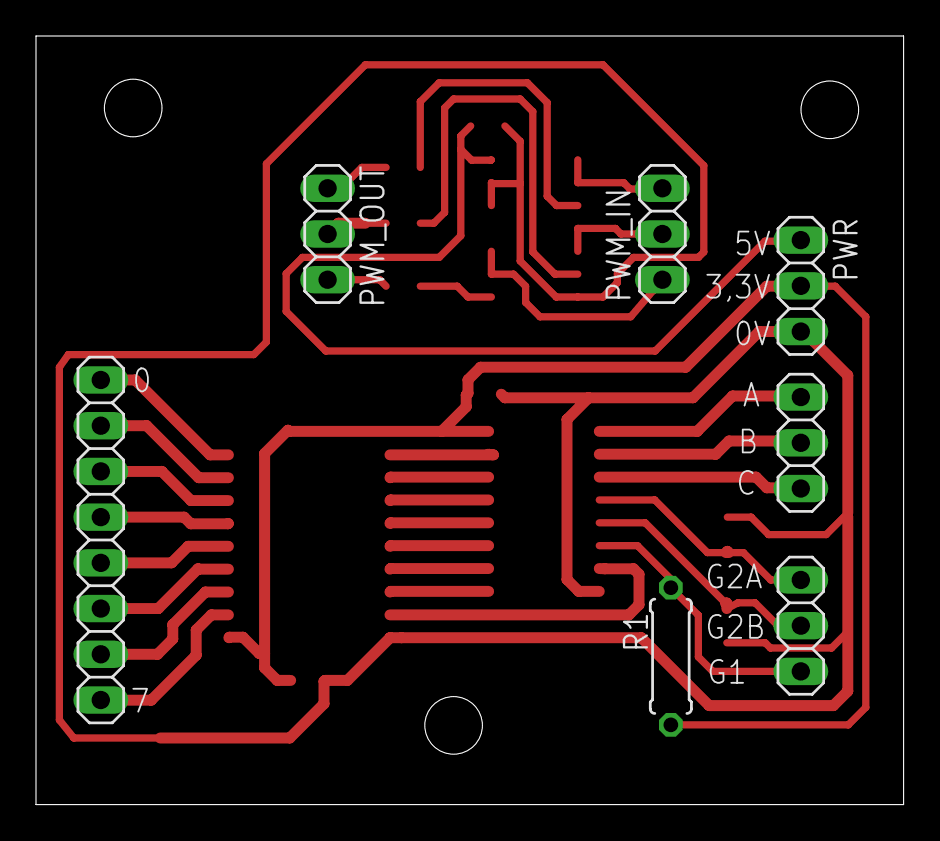
[picture p94: board Easy_LED.brd from below]

Board: 2 copper layers, 48.2 x 42.7 mm, 22 parts (7 on the bottom side), 34 nets.

Other parts of the board:
U$1, U$2, U$3: 3,2
