iti-luebeck/BEEP/Hardware/PCBs/BEEP_0.1/TSL2671.brd

## EAGLE design Hardware/PCBs/BEEP_0.1/TSL2671.brd (2013-05-10)

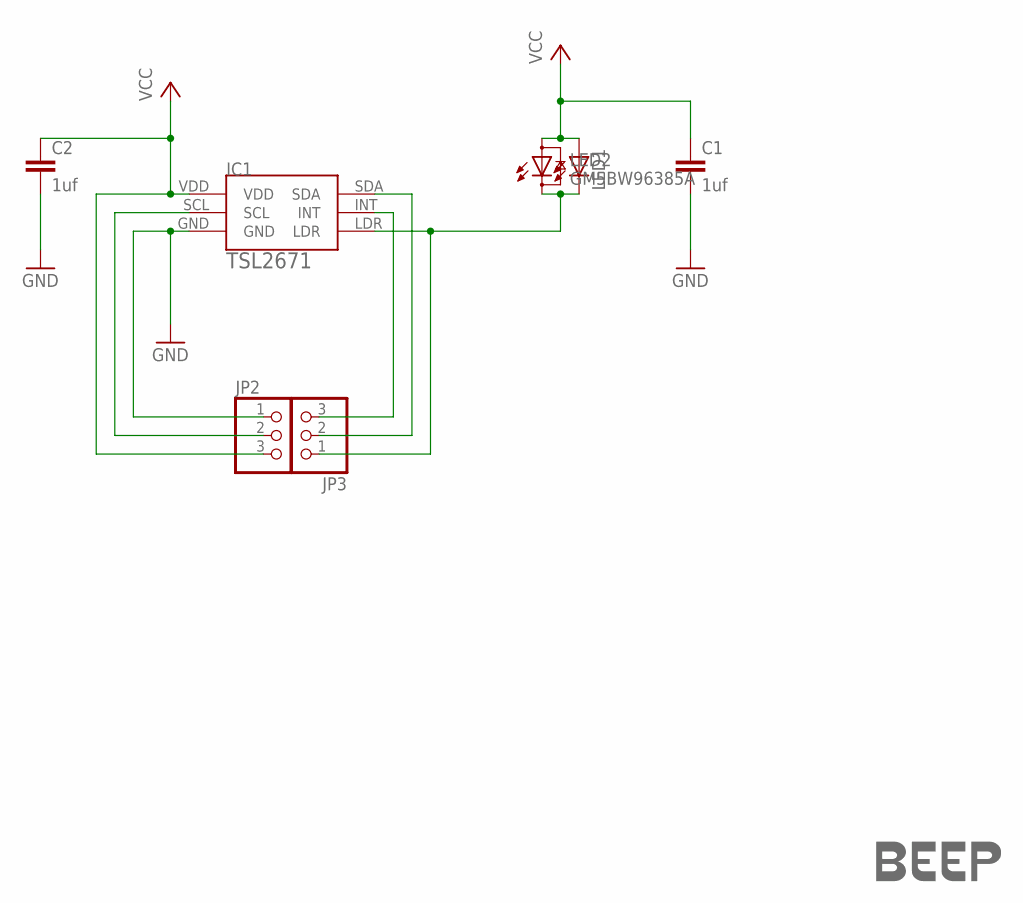
[picture p95: schematic TSL2671.sch]

Parts:
C1: 1uf; C025-025X050
C2: 1uf; C1206K
IC1: TSL2671
JP2, JP3: PINHD-1X3; 1X03
LED1: LED5MM
LED2: GM5BW96385A
U$1: LOGO-COPPER4; COPPER4

Connections:
GND: C1.2, C2.2, IC1.GND, JP2.1
unnamed: IC1.LDR, JP3.1, LED1.K (C), LED2.C
unnamed: IC1.SCL, JP2.2
unnamed: IC1.SDA, JP3.2
unnamed: IC1.INT, JP3.3
VCC: C1.1, C2.1, IC1.VDD, JP2.3, LED1.A, LED2.A

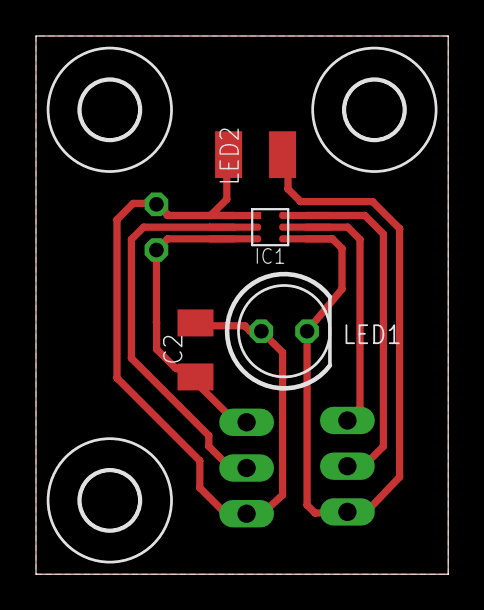
[picture p96: board TSL2671.brd from above]

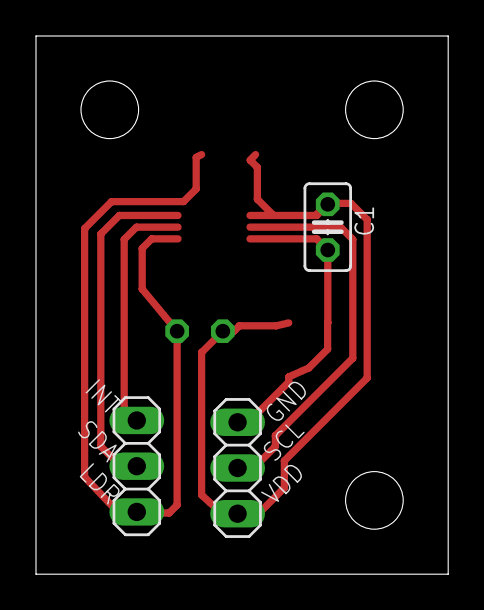
[picture p97: board TSL2671.brd from below]

Board: 2 copper layers, 22.9 x 29.9 mm, 11 parts (3 on the bottom side), 6 nets.

Other parts of the board:
U$2, U$3, U$4: 3,2
