iti-luebeck/BEEP/Hardware/PCBs/BEEP_0.1/8_RGB_SMD_LEDs.brd

## EAGLE design Hardware/PCBs/BEEP_0.1/8_RGB_SMD_LEDs.brd (2013-05-05)

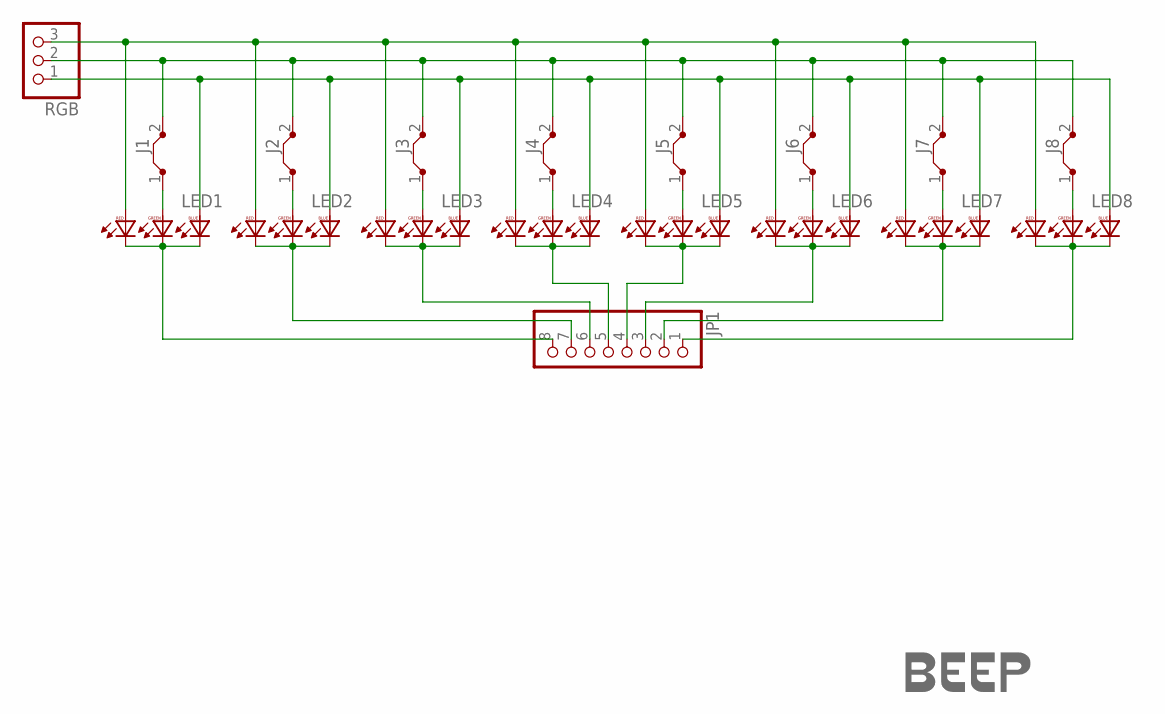
[picture p98: schematic 8_RGB_SMD_LEDs.sch]

Parts:
J1, J2, J3, J4, J5, J6, J7, J8: J7MM; 07
JP1: PINHD-1X8; 1X08
LED1, LED2, LED3, LED4, LED5, LED6, LED7, LED8: F503605050; 5050LED
RGB: PINHD-1X3; 1X03
U$5: LOGO-COPPER7; COPPER7

Connections:
unnamed: J1.2, J2.2, J3.2, J4.2, J5.2, J6.2, J7.2, J8.2, RGB.2
unnamed: J1.1, LED1.G1 (GA)
unnamed: JP1.8, LED1.B2 (BC), LED1.G2 (GC), LED1.R2 (RC)
unnamed: JP1.7, LED2.B2 (BC), LED2.G2 (GC), LED2.R2 (RC)
unnamed: JP1.6, LED3.B2 (BC), LED3.G2 (GC), LED3.R2 (RC)
unnamed: JP1.5, LED4.B2 (BC), LED4.G2 (GC), LED4.R2 (RC)
unnamed: J2.1, LED2.G1 (GA)
unnamed: JP1.4, LED5.B2 (BC), LED5.G2 (GC), LED5.R2 (RC)
unnamed: JP1.3, LED6.B2 (BC), LED6.G2 (GC), LED6.R2 (RC)
unnamed: JP1.2, LED7.B2 (BC), LED7.G2 (GC), LED7.R2 (RC)
unnamed: JP1.1, LED8.B2 (BC), LED8.G2 (GC), LED8.R2 (RC)
unnamed: J3.1, LED3.G1 (GA)
unnamed: J4.1, LED4.G1 (GA)
unnamed: J5.1, LED5.G1 (GA)
unnamed: J6.1, LED6.G1 (GA)
unnamed: J7.1, LED7.G1 (GA)
unnamed: LED1.R1 (RA), LED2.R1 (RA), LED3.R1 (RA), LED4.R1 (RA), LED5.R1 (RA), LED6.R1 (RA), LED7.R1 (RA), LED8.R1 (RA), RGB.3
unnamed: J8.1, LED8.G1 (GA)
unnamed: LED1.B1 (BA), LED2.B1 (BA), LED3.B1 (BA), LED4.B1 (BA), LED5.B1 (BA), LED6.B1 (BA), LED7.B1 (BA), LED8.B1 (BA), RGB.1

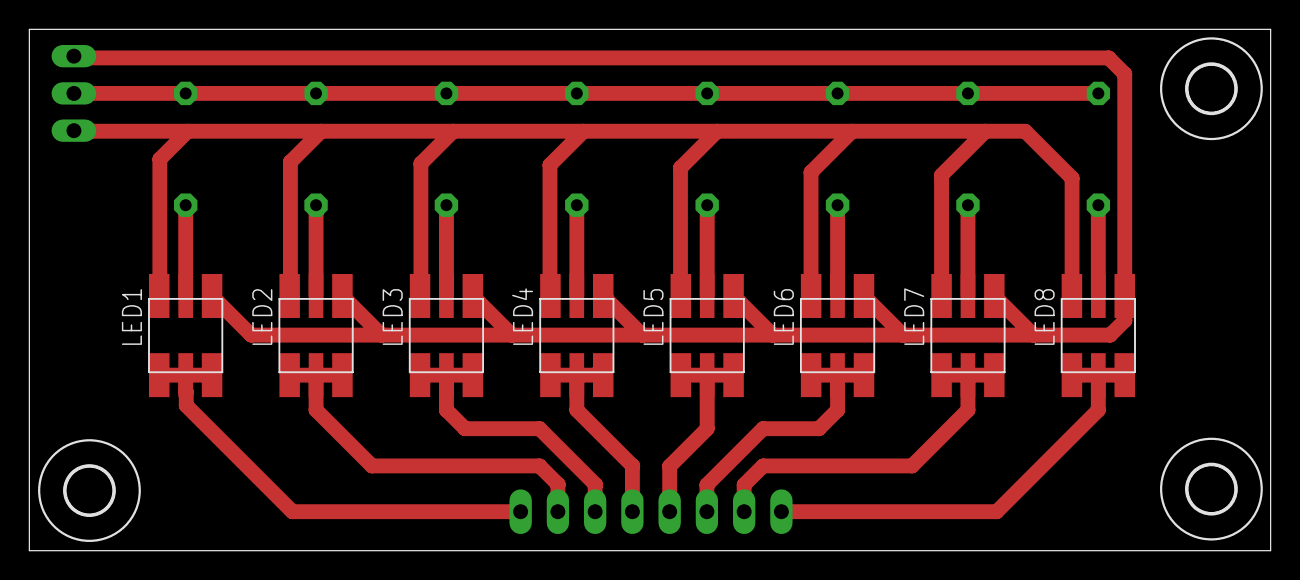
[picture p99: board 8_RGB_SMD_LEDs.brd from above]

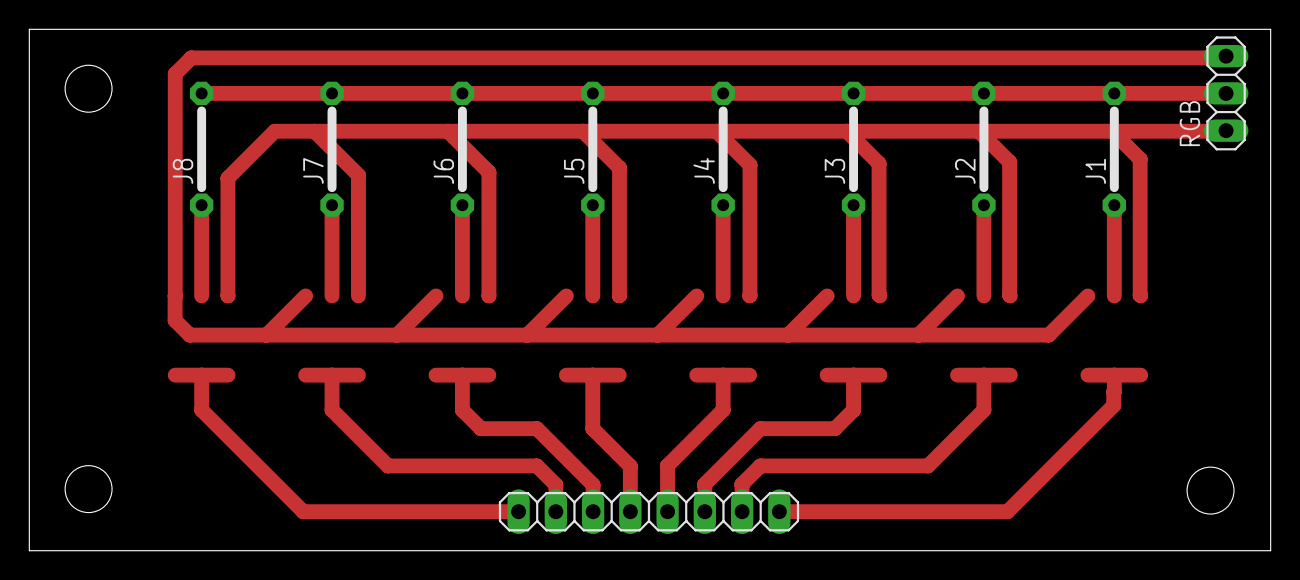
[picture p100: board 8_RGB_SMD_LEDs.brd from below]

Board: 2 copper layers, 84.6 x 35.5 mm, 22 parts (10 on the bottom side), 19 nets.

Other parts of the board:
U$1, U$2, U$3: 3,2
