iti-luebeck/BEEP/Hardware/PCBs/BEEP_0.1/ATMEGA168.brd

## EAGLE design Hardware/PCBs/BEEP_0.1/ATMEGA168.brd (2013-05-17)

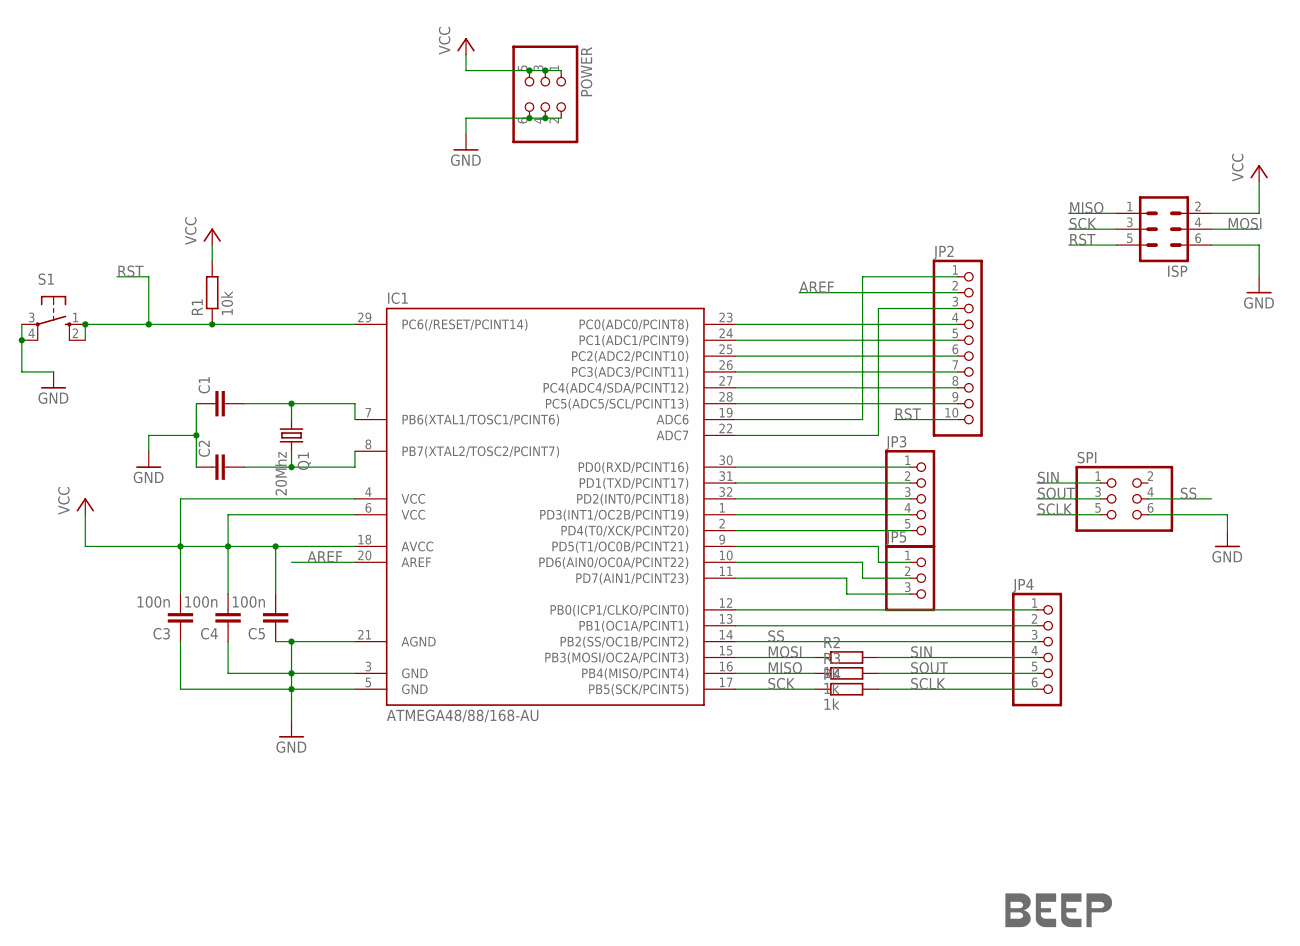
[picture p101: schematic ATMEGA168.sch]

Parts:
C1, C2: C-EUC0805; C0805
C3, C4: 100n; C0805
C5: 100n; C050-025X075
IC1: ATMEGA48/88/168-AU; TQFP32-08
ISP: ML6
JP2: PINHD-1X10; 1X10
JP3: PINHD-1X5; 1X05
JP4: PINHD-1X6; 1X06
JP5: PINHD-1X3; 1X03
POWER: PINHD-2X3; 2X03
Q1: 20Mhz; HC49/S
R1: 10k; M0805
R2, R3, R4: 1k; 0207/7
S1: 10-XX; B3F-10XX
SPI: PINHD-2X3; 2X03
U$1: LOGO-COPPER4; COPPER4

Connections:
AREF: IC1.20 (AREF), JP2.2
GND: C1.1, C2.1, C3.1, C4.1, C5.1, IC1.3 (GND), IC1.5 (GND), IC1.21 (AGND), ISP.6, POWER.2, POWER.4, POWER.6, S1.3, S1.4 (P1), SPI.6
MISO: IC1.16 (PB4(MISO/PCINT4)), ISP.1, R3.1
MOSI: IC1.15 (PB3(MOSI/OC2A/PCINT3)), ISP.4, R2.1
unnamed: C1.2, IC1.7 (PB6(XTAL1/TOSC1/PCINT6)), Q1.1
unnamed: C2.2, IC1.8 (PB7(XTAL2/TOSC2/PCINT7)), Q1.2
unnamed: IC1.28 (PC5(ADC5/SCL/PCINT13)), JP2.9
unnamed: IC1.27 (PC4(ADC4/SDA/PCINT12)), JP2.8
unnamed: IC1.26 (PC3(ADC3/PCINT11)), JP2.7
unnamed: IC1.25 (PC2(ADC2/PCINT10)), JP2.6
unnamed: IC1.9 (PD5(T1/OC0B/PCINT21)), JP5.1
unnamed: IC1.10 (PD6(AIN0/OC0A/PCINT22)), JP5.2
unnamed: IC1.30 (PD0(RXD/PCINT16)), JP3.1
unnamed: IC1.31 (PD1(TXD/PCINT17)), JP3.2
unnamed: IC1.32 (PD2(INT0/PCINT18)), JP3.3
unnamed: IC1.1 (PD3(INT1/OC2B/PCINT19)), JP3.4
unnamed: IC1.2 (PD4(T0/XCK/PCINT20)), JP3.5
unnamed: IC1.11 (PD7(AIN1/PCINT23)), JP5.3
unnamed: IC1.24 (PC1(ADC1/PCINT9)), JP2.5
unnamed: IC1.23 (PC0(ADC0/PCINT8)), JP2.4
unnamed: IC1.12 (PB0(ICP1/CLKO/PCINT0)), JP4.1
unnamed: IC1.13 (PB1(OC1A/PCINT1)), JP4.2
unnamed: IC1.19 (ADC6), JP2.1
unnamed: IC1.22 (ADC7), JP2.3
RST: IC1.29 (PC6(/RESET/PCINT14)), ISP.5, JP2.10, R1.1, S1.1 (S), S1.2 (S1)
SCK: IC1.17 (PB5(SCK/PCINT5)), ISP.3, R4.1
SCLK: JP4.6, R4.2, SPI.5
SIN: JP4.4, R2.2, SPI.1
SOUT: JP4.5, R3.2, SPI.3
SS: IC1.14 (PB2(SS/OC1B/PCINT2)), JP4.3, SPI.4
VCC: C3.2, C4.2, C5.2, IC1.4 (VCC), IC1.6 (VCC), IC1.18 (AVCC), ISP.2, POWER.1, POWER.3, POWER.5, R1.2

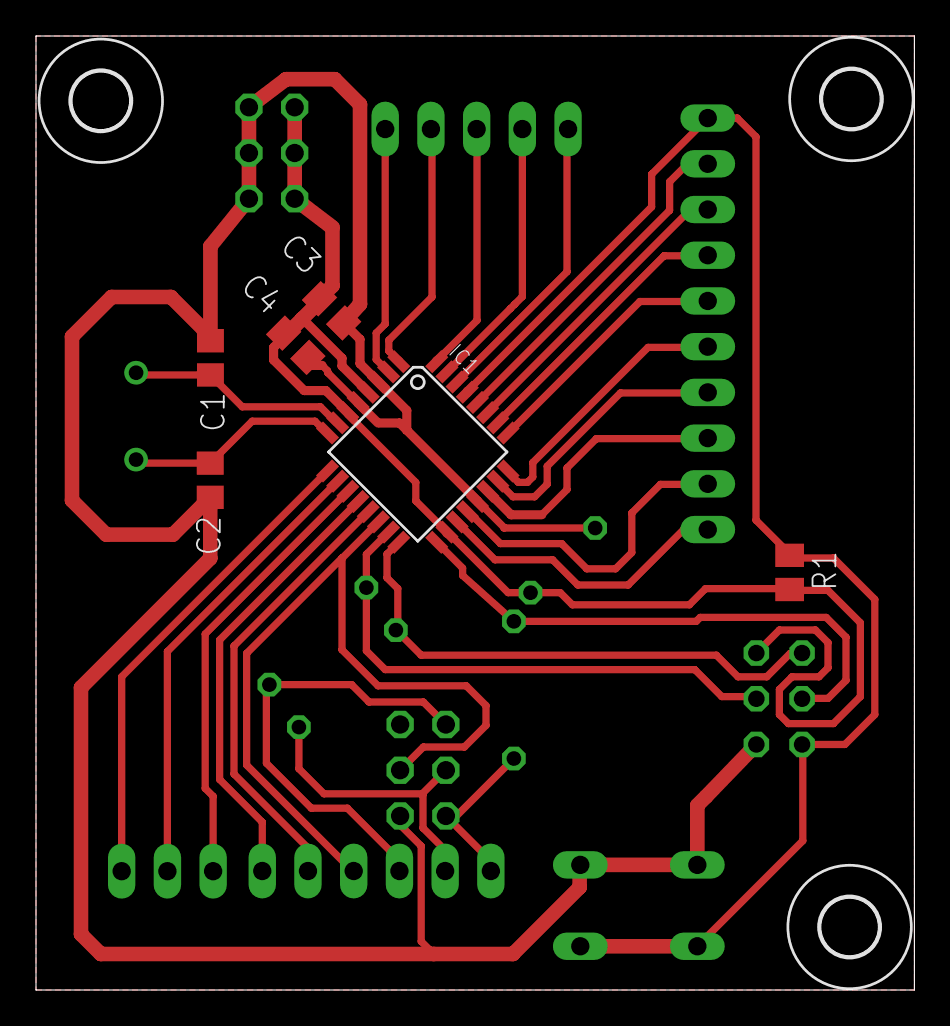
[picture p102: board ATMEGA168.brd from above]

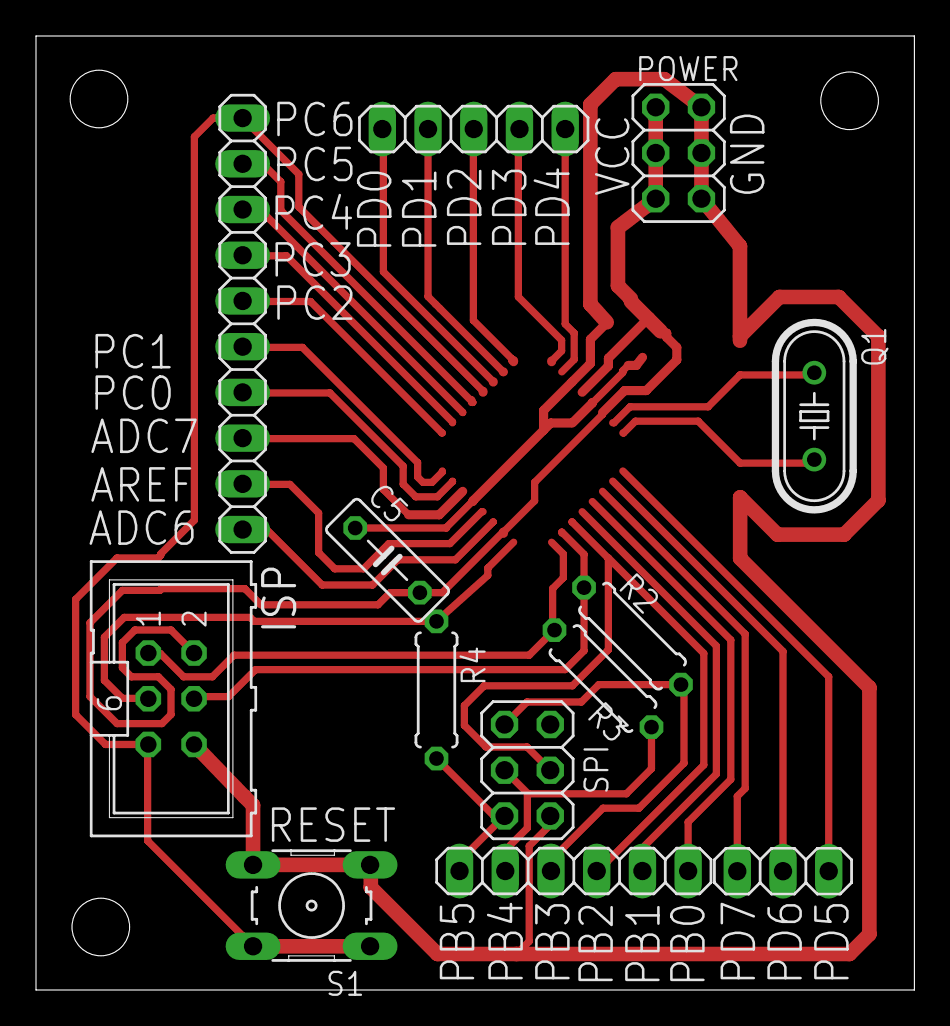
[picture p103: board ATMEGA168.brd from below]

Board: 2 copper layers, 48.8 x 53.0 mm, 23 parts (13 on the bottom side), 31 nets.

Other parts of the board:
H1, H2, H3: 3,2
