iti-luebeck/BEEP/Hardware/PCBs/BEEP_0.1/APDS-9801.brd

## EAGLE design Hardware/PCBs/BEEP_0.1/APDS-9801.brd (2013-05-05)

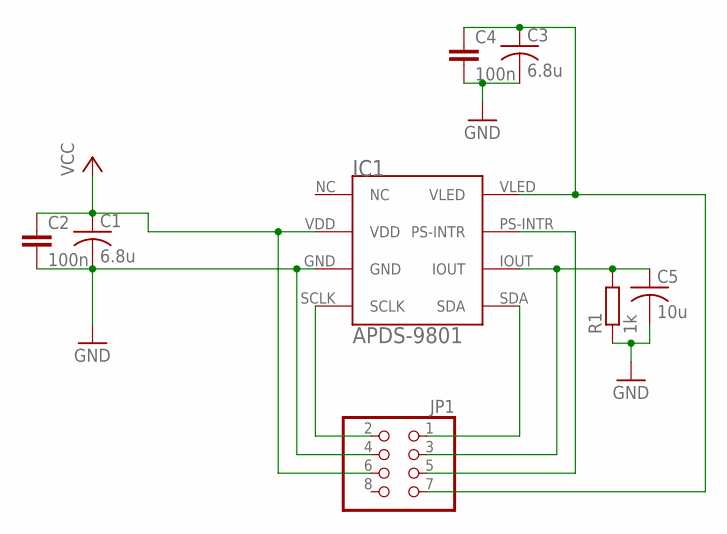
[picture p104: schematic APDS-9801.sch]

Parts:
C1, C3: 6.8u; C025-024X044
C2, C4: 100n; C0805
C5: 10u; C025-024X044
IC1: APDS-9801
JP1: PINHD-2X4; 2X04
R1: 1k; M0805

Connections:
GND: C1.2, C2.2, C3.2, C4.2, C5.2, IC1.GND, JP1.4, R1.1
unnamed: IC1.PS-INTR, JP1.5
unnamed: C5.1, IC1.IOUT, JP1.3, R1.2
unnamed: C3.1, C4.1, IC1.VLED, JP1.7
unnamed: IC1.SCLK, JP1.2
unnamed: IC1.SDA, JP1.1
VCC: C1.1, C2.1, IC1.VDD, JP1.6

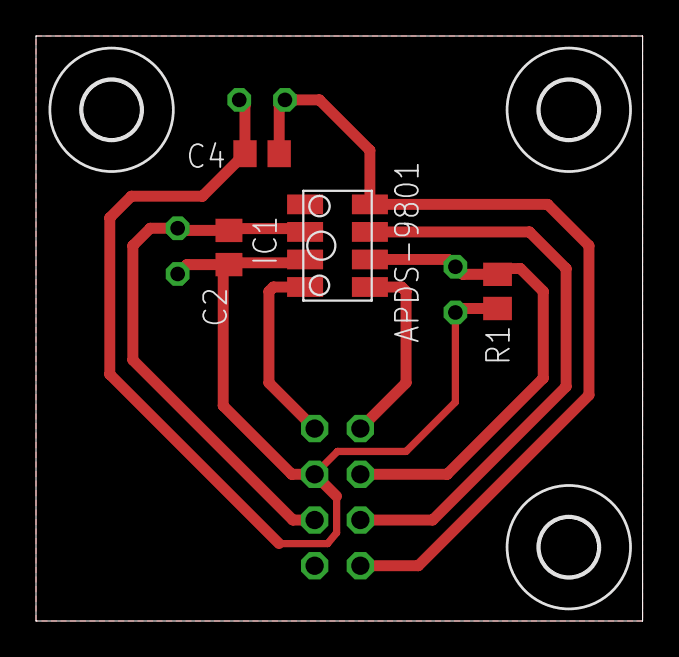
[picture p105: board APDS-9801.brd from above]

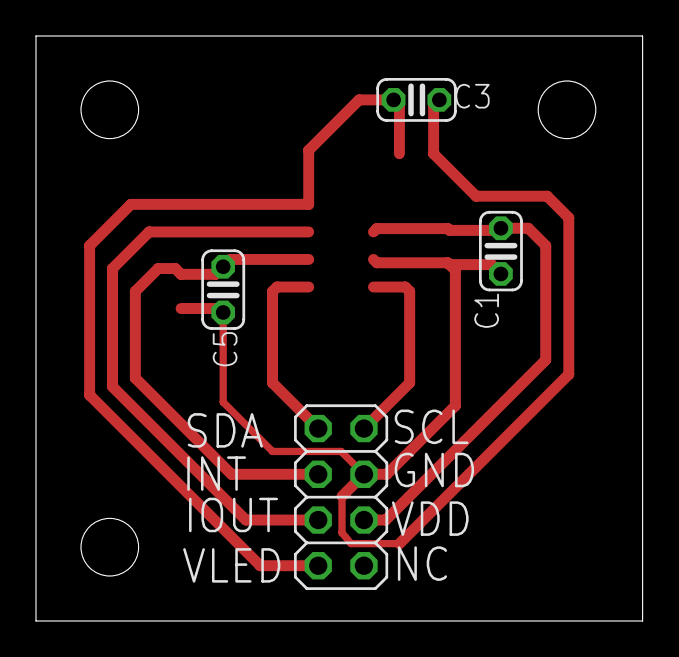
[picture p106: board APDS-9801.brd from below]

Board: 2 copper layers, 33.7 x 32.5 mm, 12 parts (4 on the bottom side), 7 nets.

Other parts of the board:
U$1: COPPER4
U$3, U$4, U$5: 3,2
