iti-luebeck/BEEP/Hardware/PCBs/BEEP_0.1/HSDL-9100.brd

## EAGLE design Hardware/PCBs/BEEP_0.1/HSDL-9100.brd (2013-06-14)

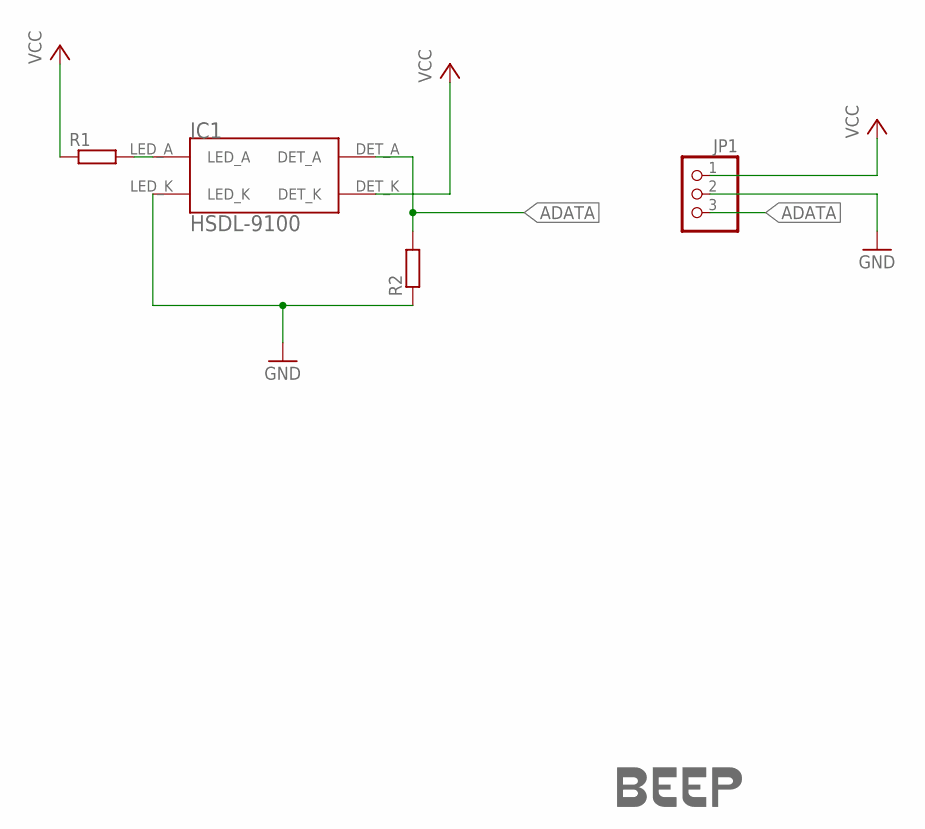
[picture p107: schematic HSDL-9100.sch]

Parts:
IC1: HSDL-9100
JP1: PINHD-1X3; 1X03
R1, R2: R-EU_M0805; M0805
U$1: LOGO-COPPER3; COPPER3

Connections:
ADATA: IC1.DET_A, JP1.3, R2.2
GND: IC1.LED_K, JP1.2, R2.1
unnamed: IC1.LED_A, R1.2
VCC: IC1.DET_K, JP1.1, R1.1

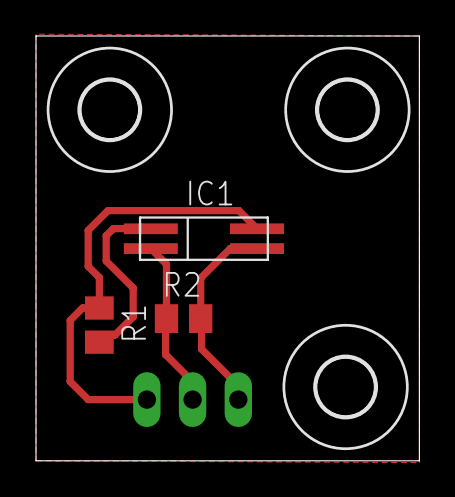
[picture p108: board HSDL-9100.brd from above]

Board: 2 copper layers, 21.3 x 23.6 mm, 8 parts (1 on the bottom side), 4 nets.

Other parts of the board:
U$2, U$3, U$4: 3,2
