iti-luebeck/BEEP/Hardware/PCBs/BEEP_0.1/PCA9548A.brd

## EAGLE design Hardware/PCBs/BEEP_0.1/PCA9548A.brd (2013-05-05)

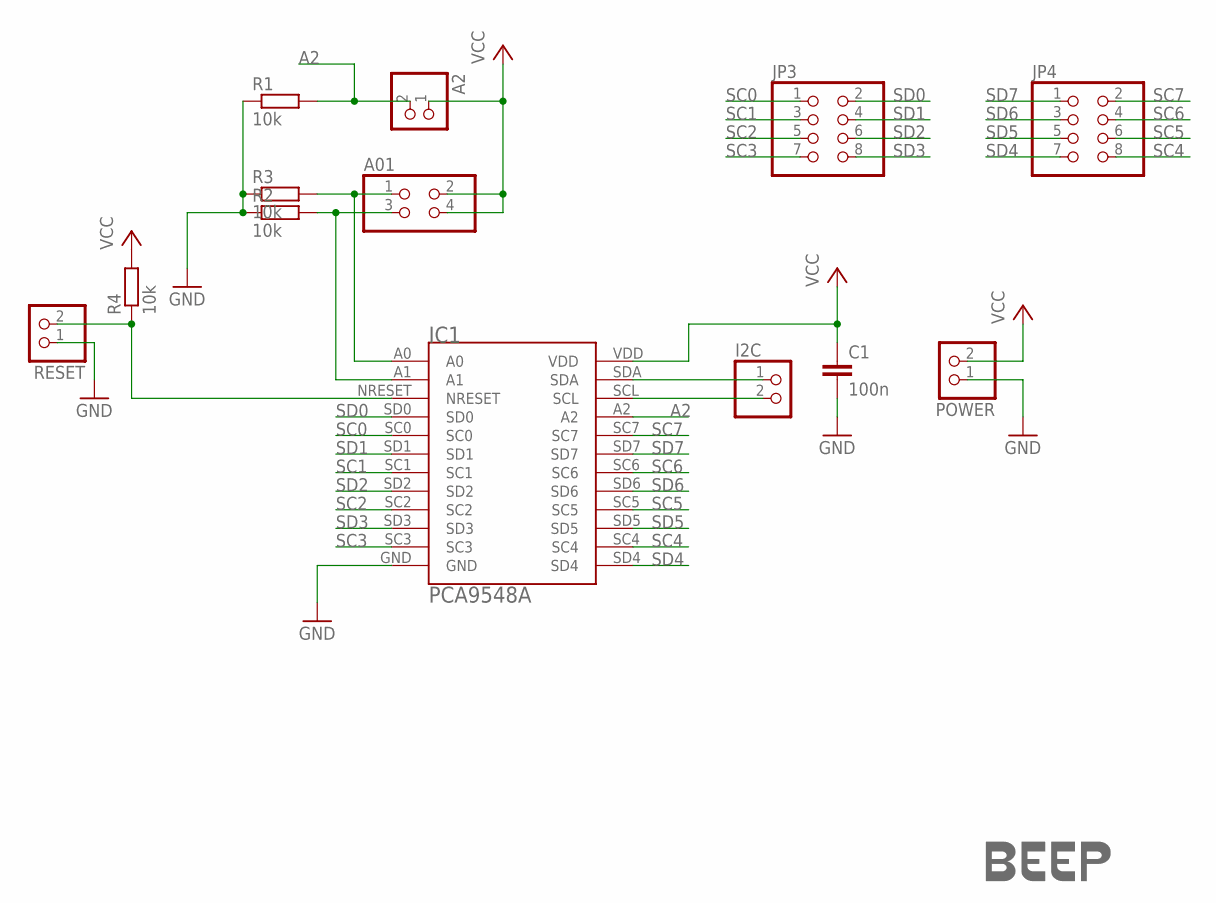
[picture p112: schematic PCA9548A.sch]

Parts:
A01: PINHD-2X2; 2X02
A2: PINHD-1X2; 1X02
C1: 100n; C0805
I2C: PINHD-1X2; 1X02
IC1: PCA9548A; TSSOP24
JP3, JP4: PINHD-2X4; 2X04
POWER: PINHD-1X2; 1X02
R1, R2, R3: 10k; 0207/7
R4: 10k; M0805
RESET: PINHD-1X2; 1X02
U$1: LOGO-COPPER4; COPPER4

Connections:
A2: A2.2, IC1.A2, R1.2
GND: C1.2, IC1.GND, POWER.1, R1.1, R2.1, R3.1, RESET.1
I"C: I2C.1, IC1.SDA
unnamed: IC1.NRESET, R4.1, RESET.2
unnamed: A01.1, IC1.A0, R3.2
unnamed: I2C.2, IC1.SCL
unnamed: A01.3, IC1.A1, R2.2
SC0: IC1.SC0, JP3.1
SC1: IC1.SC1, JP3.3
SC2: IC1.SC2, JP3.5
SC3: IC1.SC3, JP3.7
SC4: IC1.SC4, JP4.8
SC5: IC1.SC5, JP4.6
SC6: IC1.SC6, JP4.4
SC7: IC1.SC7, JP4.2
SD0: IC1.SD0, JP3.2
SD1: IC1.SD1, JP3.4
SD2: IC1.SD2, JP3.6
SD3: IC1.SD3, JP3.8
SD4: IC1.SD4, JP4.7
SD5: IC1.SD5, JP4.5
SD6: IC1.SD6, JP4.3
SD7: IC1.SD7, JP4.1
VCC: A01.2, A01.4, A2.1, C1.1, IC1.VDD, POWER.2, R4.2

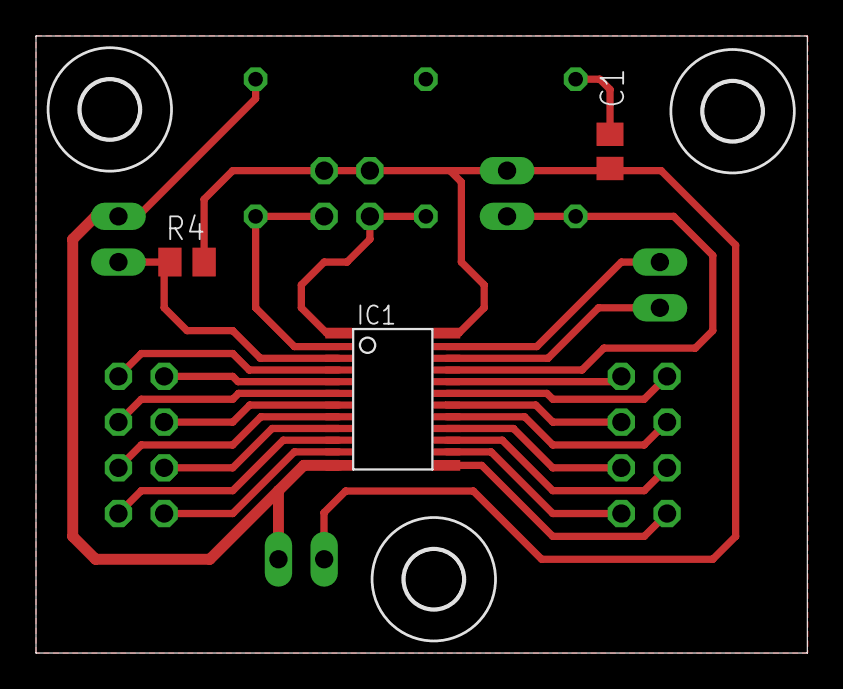
[picture p113: board PCA9548A.brd from above]

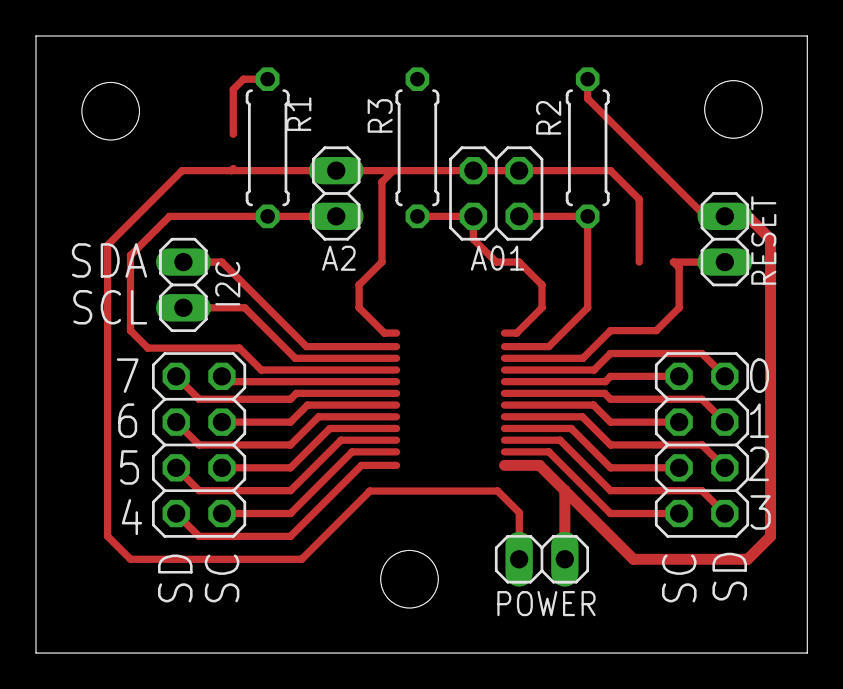
[picture p114: board PCA9548A.brd from below]

Board: 2 copper layers, 42.9 x 34.3 mm, 17 parts (10 on the bottom side), 24 nets.

Other parts of the board:
U$2, U$3, U$4: 3,2
