iti-luebeck/BEEP/Hardware/PCBs/BEEP_0.1/TCS32X0.brd

## EAGLE design Hardware/PCBs/BEEP_0.1/TCS32X0.brd (2013-05-05)

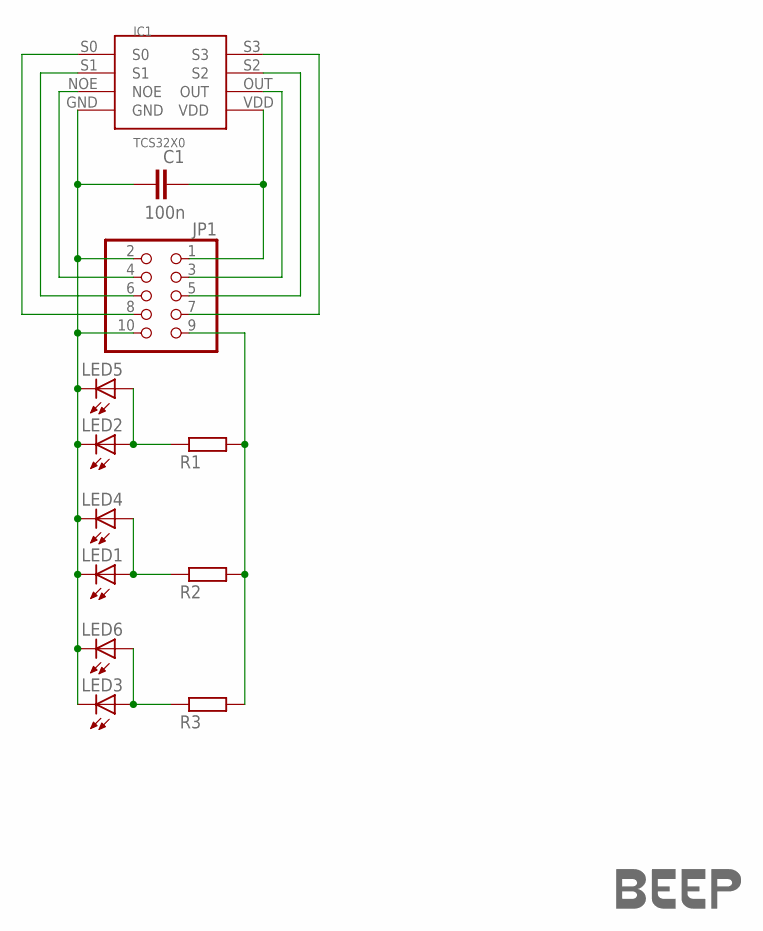
[picture p115: schematic TCS32X0.sch]

Parts:
C1: 100n; C0805
IC1: TCS32X0
JP1: PINHD-2X5; 2X05
LED1, LED2, LED3: LED3MM
LED4, LED5, LED6: NFSG036BT
R1, R2, R3: R-EU_M0805; M0805
U$1: LOGO-COPPER4; COPPER4

Connections:
GND: C1.1, IC1.GND, JP1.2, JP1.10, LED1.K (C), LED2.K (C), LED3.K (C), LED4.C, LED5.C, LED6.C
unnamed: JP1.9, R1.2, R2.2, R3.2
unnamed: IC1.NOE, JP1.4
unnamed: IC1.S1, JP1.6
unnamed: C1.2, IC1.VDD, JP1.1
unnamed: IC1.OUT, JP1.3
unnamed: IC1.S2, JP1.5
unnamed: LED2.A, LED5.A, R1.1
unnamed: LED1.A, LED4.A, R2.1
unnamed: LED3.A, LED6.A, R3.1
unnamed: IC1.S0, JP1.8
unnamed: IC1.S3, JP1.7

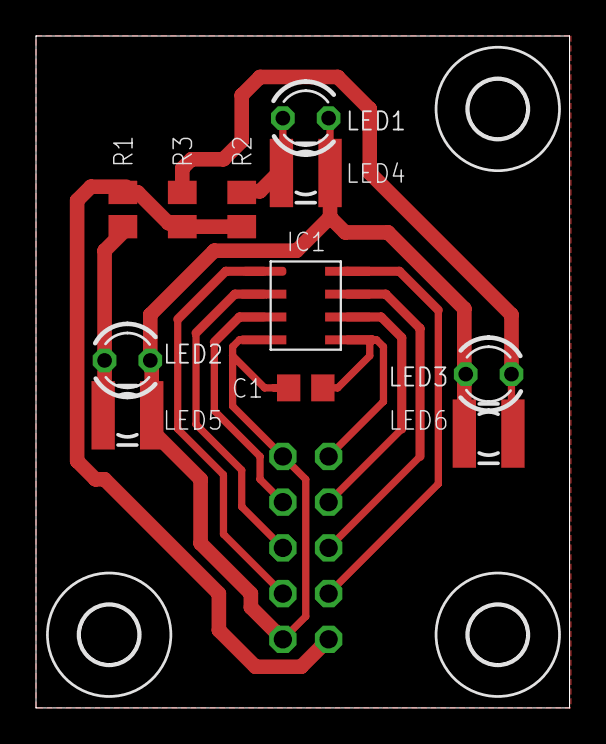
[picture p116: board TCS32X0.brd from above]

Board: 2 copper layers, 29.6 x 37.3 mm, 16 parts (1 on the bottom side), 12 nets.

Other parts of the board:
U$2, U$3, U$4: 3,2
