iti-luebeck/BEEP/Hardware/PCBs/BEEP_0.1/EE-SX1131.brd

## EAGLE design Hardware/PCBs/BEEP_0.1/EE-SX1131.brd (2013-06-06)

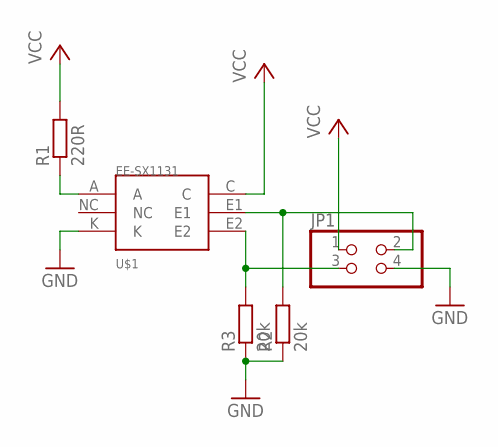
[picture p117: schematic EE-SX1131.sch]

Parts:
JP1: PINHD-2X2; 2X02
R1: 220R; M0805
R2, R3: 20k; M0805
U$1: EE-SX1131

Connections:
GND: JP1.4, R2.1, R3.1, U$1.K
unnamed: R1.1, U$1.A
unnamed: JP1.3, R3.2, U$1.E2
unnamed: JP1.2, R2.2, U$1.E1
VCC: JP1.1, R1.2, U$1.C

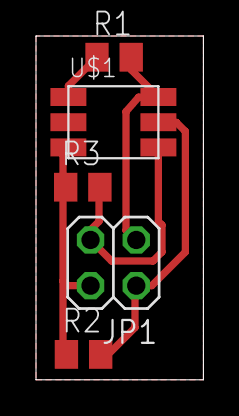
[picture p118: board EE-SX1131.brd from above]

Board: 2 copper layers, 9.3 x 19.1 mm, 5 parts (0 on the bottom side), 5 nets.
