iti-luebeck/BEEP/Hardware/PCBs/BEEP_0.1/TCS3103.brd

## EAGLE design Hardware/PCBs/BEEP_0.1/TCS3103.brd (2013-05-17)

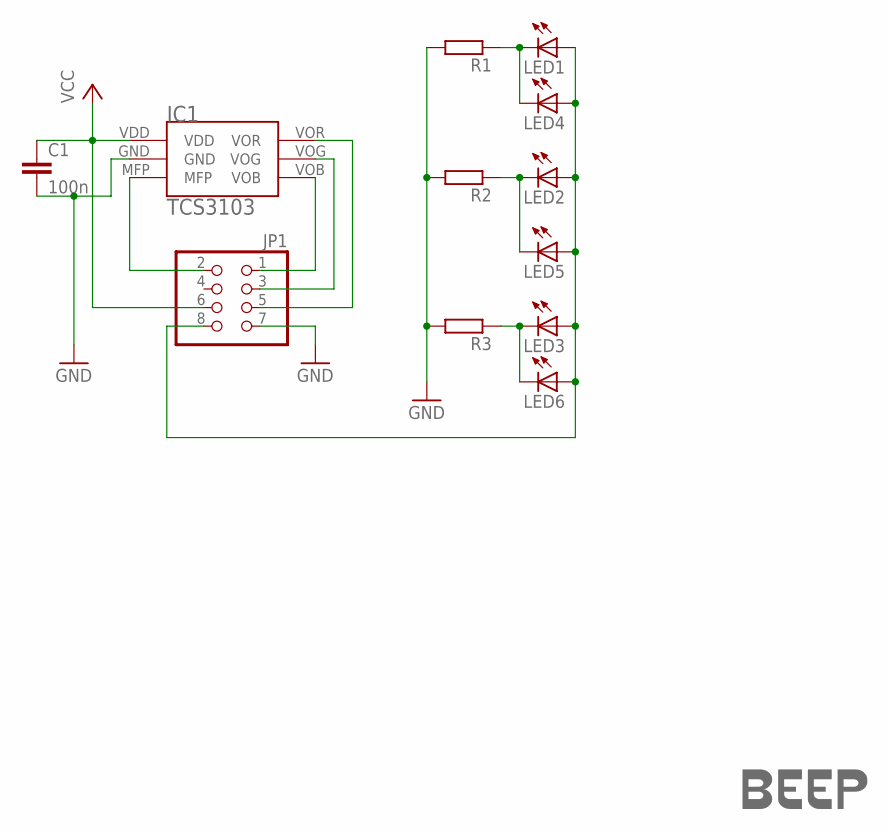
[picture p119: schematic TCS3103.sch]

Parts:
C1: 100n; C0805
IC1: TCS3103
JP1: PINHD-2X4; 2X04
LED1, LED2, LED3: LED3MM
LED4, LED5, LED6: NFSG036BT
R1, R2, R3: R-EU_M0805; M0805
U$1: LOGO-COPPER4; COPPER4

Connections:
GND: C1.2, IC1.GND, JP1.7, R1.2, R2.2, R3.2
unnamed: IC1.VOB, JP1.1
unnamed: IC1.VOG, JP1.3
unnamed: IC1.VOR, JP1.5
unnamed: IC1.MFP, JP1.2
unnamed: LED1.K (C), LED4.C, R1.1
unnamed: JP1.8, LED1.A, LED2.A, LED3.A, LED4.A, LED5.A, LED6.A
unnamed: LED3.K (C), LED6.C, R3.1
unnamed: LED2.K (C), LED5.C, R2.1
VCC: C1.1, IC1.VDD, JP1.6

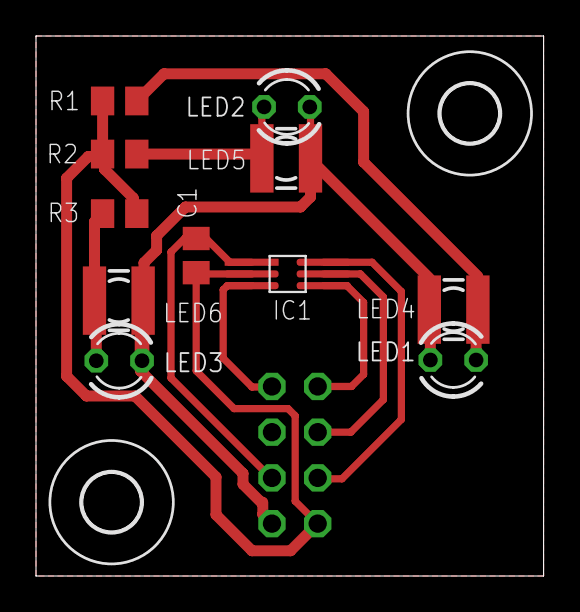
[picture p120: board TCS3103.brd from above]

Board: 2 copper layers, 28.2 x 30.0 mm, 15 parts (1 on the bottom side), 10 nets.

Other parts of the board:
U$3, U$4: 3,2
