iti-luebeck/BEEP/Software/BEEP_XMega/BEEP_XMega/BEEP_XMega.c

/*
 * BEEP_XMega.c
 *
 * Created: 02.09.2013 13:49:19
 *  Author: hanse
 */ 



#include <avr/io.h>
#include <stdint.h>
#include "lib/avr_compiler.h"
#include "lib/usart_driver.h"
#include "lib/motor_driver.h"
#include <stdbool.h>
#include <stdlib.h>
#include "lib/ir_driver.h"

#include "lib/xmega_freq_cntr.h"

#define beep_dev_mask 0xf0
#define beep_command_mask 0x0f

//devices
#define BEEP_DEV_MOTORS 0x40
#define BEEP_DEV_RGB_LED 0x50

//commands
#define BEEP_COM_LEFT_MOTOR 0x01
#define BEEP_COM_RIGHT_MOTOR 0x02
#define BEEP_COM_BOTH_MOTORS 0x03
#define beep_com_motor_shutdown 0x0f
#define beep_com_motor_enable 0x0e

#define BEEP_COM_LEDS_OFF 0x0f
#define BEEP_COM_LEDS_ON 0x0e

#define MAX_COMMAND_DATA 4
#define USART_BAUDRATE 38400UL

#define PWM_CH2 TCE0.CCC
#define PWM_CH1 TCE0.CCB
#define PWM_CH0 TCE0.CCA
#define PWM_CH2_ENABLE_gc TC0_CCCEN_bm
#define PWM_CH1_ENABLE_gc TC0_CCBEN_bm
#define PWM_CH0_ENABLE_gc TC0_CCAEN_bm

typedef struct RGB {
	uint8_t red;
	uint8_t green;
	uint8_t blue;
} RGB;

//calculated using wolfram alpha
//table[round(pow(2, log2(2^12-1) * (x+1) / 256)) ,{x,0,255,1}
//first value =0
// Table for rgb-led pwm (need enhancement!)
const uint16_t pwmtable_12[256] PROGMEM = {
	0, 1, 1, 1, 1, 1, 1, 1, 1, 1, 1, 1, 2, 2, 2, 2, 2, 2, 2, 2, 2, 2, 2, 2, 2, 2, 2, 2, 3, 3, 3, 3, 3, 3, 3, 3, 3, 3, 4, 4, 4, 4, 4, 4, 4, 4, 5, 5, 5, 5, 5, 5, 6, 6, 6, 6, 6, 7, 7, 7, 7, 7, 8, 8, 8, 9, 9, 9, 9, 10, 10, 10, 11, 11, 11, 12, 12, 13, 13, 13, 14, 14, 15, 15, 16, 16, 17, 17, 18, 19, 19, 20, 21, 21, 22, 23, 23, 24, 25, 26, 27, 27, 28, 29, 30, 31, 32, 33, 35, 36, 37, 38, 39, 41, 42, 43, 45, 46, 48, 49, 51, 53, 54, 56, 58, 60, 62, 64, 66, 68, 71, 73, 75, 78, 80, 83, 86, 89, 91, 95, 98, 101, 104, 108, 111, 115, 119, 123, 127, 131, 135, 140, 144, 149, 154, 159, 164, 170, 175, 181, 187, 193, 200, 206, 213, 220, 227, 235, 242, 250, 259, 267, 276, 285, 295, 304, 314, 325, 336, 347, 358, 370, 382, 395, 408, 421, 435, 450, 464, 480, 496, 512, 529, 546, 564, 583, 602, 622, 643, 664, 686, 708, 732, 756, 781, 807, 833, 861, 889, 919, 949, 980, 1013, 1046, 1081, 1116, 1153, 1191, 1231, 1271, 1313, 1357, 1402, 1448, 1496, 1545, 1596, 1649, 1703, 1759, 1818, 1878, 1940, 2004, 2070, 2138, 2209, 2282, 2357, 2435, 2515, 2598, 2684, 2773, 2864, 2959, 3057, 3158, 3262, 3370, 3481, 3596, 3715, 3837, 3964, 4095
};


const volatile uint16_t* const red_channel_lut[] PROGMEM = 
	{&PWM_CH1,&PWM_CH0,&PWM_CH0,&PWM_CH1,&PWM_CH1,&PWM_CH0,&PWM_CH0,&PWM_CH1};
const volatile uint8_t PWM_red_ENABLE_gc_lut[] PROGMEM = 
	{PWM_CH1_ENABLE_gc,PWM_CH0_ENABLE_gc,PWM_CH0_ENABLE_gc,PWM_CH1_ENABLE_gc,PWM_CH1_ENABLE_gc,PWM_CH0_ENABLE_gc,PWM_CH0_ENABLE_gc,PWM_CH1_ENABLE_gc};

const volatile uint16_t* const blue_channel_lut[] PROGMEM  =
{&PWM_CH0, &PWM_CH1, &PWM_CH1, &PWM_CH0, &PWM_CH0, &PWM_CH1, &PWM_CH1, &PWM_CH2};
const volatile uint8_t PWM_blue_ENABLE_gc_lut[] PROGMEM =
	{PWM_CH0_ENABLE_gc,PWM_CH1_ENABLE_gc,PWM_CH1_ENABLE_gc,PWM_CH0_ENABLE_gc,PWM_CH0_ENABLE_gc,PWM_CH1_ENABLE_gc,PWM_CH1_ENABLE_gc,PWM_CH2_ENABLE_gc};
		
const volatile uint16_t* const green_channel_lut[] PROGMEM  =
	{&PWM_CH2, &PWM_CH2, &PWM_CH2, &PWM_CH2, &PWM_CH2, &PWM_CH2, &PWM_CH2, &PWM_CH0};
const volatile uint8_t PWM_green_ENABLE_gc_lut[] PROGMEM =
	{PWM_CH2_ENABLE_gc,PWM_CH2_ENABLE_gc,PWM_CH2_ENABLE_gc,PWM_CH2_ENABLE_gc,PWM_CH2_ENABLE_gc,PWM_CH2_ENABLE_gc,PWM_CH2_ENABLE_gc,PWM_CH0_ENABLE_gc};
	

//startup colors
volatile RGB myColors[8];


/* \brief Struct to manage next command and its data */
typedef struct Command_Buffer{
	/* \brief device the received command referes to*/
	uint8_t device;
	/* \brief command for the device*/
	uint8_t command;
	/* \brief number of missing data-bytes to execute command*/
	int8_t data_missing;
	/* \brief Array of data needed for command. -1 if no command/device received*/
	uint8_t data[MAX_COMMAND_DATA];
	/* \brief index of the next position to store data in*/
	uint8_t head;
	}Command_Buffer_t;



void init_enable_32mhz(void){
		OSC.CTRL |= OSC_RC32MEN_bm; //Enable 32 Mhz oscillator
		while(!(OSC.STATUS & OSC_RC32MRDY_bm)); //Wait until 32 Mhz oscillator is ready
		CCP = CCP_IOREG_gc; //Disable configuration change protection for four cycles
		CLK.CTRL = CLK_SCLKSEL_RC32M_gc; //Set 32Mhz as main clock
		OSC.CTRL &= ~OSC_RC2MEN_bm; //Disable 2 Mhz oscillator
}

void init_usart(void){
	// Output TX
	PORTD.DIRSET = PIN3_bm;
	// Input RX
	PORTD.DIRCLR = PIN2_bm;
	
	// init Buffers using USARTD0
	USART_InterruptDriver_Initialize(&USART_data, &USARTD0, USART_DREINTLVL_LO_gc);
	
	/* USARTD0, 8 Data bits, No Parity, 1 Stop bit. */
	USART_Format_Set(USART_data.usart, USART_CHSIZE_8BIT_gc,
                     USART_PMODE_DISABLED_gc, false);

	/* Enable RXC interrupt. */
	USART_RxdInterruptLevel_Set(USART_data.usart, USART_RXCINTLVL_LO_gc);

	/* Set Baudrate to baudrate bps:
	 * Do not use the baudrate scale factor (factor = 0)
	 * Baudrate ((I/O clock frequency)/(2^(ScaleFactor)*16*Baudrate))-1
	 */	
	USART_Baudrate_Set(&USARTD0, ((F_CPU/(16*USART_BAUDRATE))-1) , 0);
	
	//USART_Baudrate_Set(&USARTD0, 1/(16*((F_CPU/baudrate)-1)) , 0);

	/* Enable both RX and TX. */
	USART_Rx_Enable(USART_data.usart);
	USART_Tx_Enable(USART_data.usart);
}


void init_rgb_led(void){
	PORTF.DIRSET = PIN3_bm | PIN4_bm | PIN5_bm; //LED multiplexer Pins as output
	PORTE.DIRSET = PIN0_bm | PIN1_bm | PIN2_bm; //Set LED PWM as output
	
	//only for inverted driver
	//PORTE.PIN0CTRL = PORT_INVEN_bm;
	//PORTE.PIN1CTRL = PORT_INVEN_bm;
	//PORTE.PIN2CTRL = PORT_INVEN_bm;

	TCE0.CTRLB = PWM_CH0_ENABLE_gc|PWM_CH2_ENABLE_gc|PWM_CH1_ENABLE_gc| TC_WGMODE_SS_gc; //enable pwm output, Single slope pwm
	
	TCE0.PER = 0xfff; //12 Bit resolution per period
	
	//Enable overflow interrupt for Timer 0 on Port C to swich rgb LED
	TCE0.INTCTRLA = TC_OVFINTLVL_LO_gc;
}

inline void enable_rgb_leds(bool enable);
void enable_rgb_leds(bool enable){
	if (enable){
		//reset counter
		TCE0.CNT = 0x00;
		//restart counter
		TCE0.CTRLA = TC_CLKSEL_DIV1_gc;
	}else{
		TCE0.CTRLA = 0; // disable pwm output
		PORTE.OUTCLR = PIN0_bm | PIN1_bm | PIN2_bm; // clear outputs
	}
}

//lookup table for RGB darlington
const uint8_t rgb_led_lut[8] PROGMEM = {
	0b000<<3, 0b100<<3 ,0b010<<3, 0b110<<3, 0b001<<3, 0b101<<3, 0b011<<3, 0b111<<3};




/*! \brief Sets speed of motor.
*	Positive values will cause the motor to turn in forwards direction of the robot
*	Negative values will cause the motor to turn in backwards direction of the robot
*	
*	\param motor motor that shall receive ne speed value
*	\param speed speed for the motor. (-128 to 127)
*/

void set_beepmotor_speed(motor_t motor, int8_t speed){
	motor_op_mode_t op = motor_stop;
	// calculate rotation direction
	if (speed<0){
		if(speed == INT8_MIN){
			speed = INT8_MAX;
		}else{
			speed = -speed;
		}		
		if(motor == motor_l){
			op = motor_cw;
		}else if(motor == motor_r){
			op = motor_ccw;
		}
	}else{
		if(motor == motor_l){
			op = motor_ccw;
		}else if(motor == motor_r){
			op = motor_cw;
		}
	}
	//scale to uint8 value
	uint8_t new_speed = speed * (UINT8_MAX / INT8_MAX);
	//activate motor
	set_motor_operation_mode(motor, op);
	set_motor_speed(motor, new_speed);
	
}


inline uint8_t sconvert_to_uint8_t(float in);
inline uint8_t sconvert_to_uint8_t(float in){
	if(in > UINT8_MAX){
		return UINT8_MAX;
	}else if(in < 0){
		return 0;
	} else{
		return (int) in;
	}
}

int main(void){
	
	init_enable_32mhz();
	init_usart();
	init_motor();
	init_ir_driver();
	
	init_rgb_led();
	enable_rgb_leds(true);

	/* Enable PMIC interrupt level low. */
	PMIC.CTRL |= PMIC_LOLVLEX_bm;

	/* Enable global interrupts. */
	sei();

	// set some colors
	myColors[0].red = 0x00;
	myColors[0].green = 0xFF;
	myColors[0].blue = 0x00;
	
	myColors[1].red = 0x00;
	myColors[1].green = 0xFF;
	myColors[1].blue = 0x00;	
	
	myColors[2].red = 0x00;
	myColors[2].green = 0xFF;
	myColors[2].blue = 0x00;
	
	myColors[3].red = 0x00;
	myColors[3].green = 0xFF;
	myColors[3].blue = 0x00;
	
	myColors[4].red = 0x00;
	myColors[4].green = 0xFF;
	myColors[4].blue = 0x00;
	
	myColors[5].red = 0x00;
	myColors[5].green = 0xFF;
	myColors[5].blue = 0x00;
	
	myColors[6].red = 0x00;
	myColors[6].green = 0xFF;
	myColors[6].blue = 0x00;
	
	myColors[7].red = 0x00;
	myColors[7].green = 0xFF;
	myColors[7].blue = 0x00;
	
		
	int8_t led_swich_workaround = 0;
	
	
	set_motor_on(true);

	Command_Buffer_t next_command;
	next_command.data_missing =- 1;
	next_command.head = 0;
	next_command.command = 0;
	next_command.device = 0;
	
	set_motor_on(true);
	set_beepmotor_speed(motor_l, 0);
	set_beepmotor_speed(motor_r, 0);	
	
	//set IO for color sensors
	PORTD.DIRSET = PIN1_bm|PIN4_bm|PIN5_bm|PIN6_bm|PIN7_bm;
	PORTD.DIRCLR = PIN0_bm;
	PORTE.DIRSET = PIN3_bm;
	PORTE.OUTSET = PIN3_bm;

	
	xmega_freq_cntr_init();				// Initializes XMEGA timer/counters and Event System
	xmega_tcca_clk_freq_sel(TC_CLKSEL_DIV8_gc);
	



    while(1){
		//temp
		//enable audio amplifier
		PORTF.DIRSET = PIN6_bm;
		PORTF.OUTCLR = PIN6_bm;
		
		/* temp color reading
		//temp
		float color_correction_matrix [3][3] = {
			{ 0.0970121,  -0.0324089,  -0.0426333},
			{-0.0618194,   0.3345633,  -0.1681146},
			{-0.0088497,  -0.2017551,   0.3783317}};

		//red
		PORTD.OUTCLR = PIN5_bm | PIN6_bm;
		PORTD.OUTSET = 0;
		xmega_freq_cntr_start_meas();
		while(xmega_get_result() ==0){}
		uint16_t red_raw = xmega_get_result(); // result available here
		xmega_freq_cntr_clr_result();// clears result coming from driver

		//green
		PORTD.OUTCLR = PIN5_bm | PIN6_bm;
		PORTD.OUTSET = PIN5_bm | PIN6_bm;
		xmega_freq_cntr_start_meas();
		while(xmega_get_result() ==0){}
		uint16_t green_raw = xmega_get_result(); // result available here
		xmega_freq_cntr_clr_result();// clears result coming from driver

		//blue
		PORTD.OUTCLR = PIN5_bm | PIN6_bm;
		PORTD.OUTSET = PIN6_bm;
		xmega_freq_cntr_start_meas();
		while(xmega_get_result() ==0){}
		uint16_t blue_raw = xmega_get_result(); // result available here
		xmega_freq_cntr_clr_result();// clears result coming from driver

		//apply color correction matrix
		float fred = round(
			red_raw*color_correction_matrix[0][0]+
			green_raw*color_correction_matrix[1][0]+
			blue_raw*color_correction_matrix[2][0]);
		float fgreen = round(
			red_raw*color_correction_matrix[0][1]+
			green_raw*color_correction_matrix[1][1]+
			blue_raw*color_correction_matrix[2][1]);
		float fblue = round(
			red_raw*color_correction_matrix[0][2]+
			green_raw*color_correction_matrix[1][2]+
			blue_raw*color_correction_matrix[2][2]);


		uint8_t red = sconvert_to_uint8_t(fred);
		uint8_t green = sconvert_to_uint8_t(fgreen);
		uint8_t blue = sconvert_to_uint8_t(fblue);
		
 		myColors[1].red = red;
 		myColors[1].green = green;
 		myColors[1].blue = blue;
		//temp end
		*/
		
		if(ir_driver_is_measuring() == false){
			//TODO delete workaround when hardware fixed
			led_swich_workaround++;
			led_swich_workaround &= 8;
			
			ir_led_enable(led_swich_workaround);
			
			if(USART_RXBufferData_Available(&USART_data)){
				uint8_t data = USART_RXBuffer_GetByte(&USART_data);
				if(next_command.data_missing == -1){
					next_command.device = data & beep_dev_mask;
					next_command.command = data & beep_command_mask;
					//get number of missing data to execute command
					if(next_command.device == BEEP_DEV_MOTORS){
						if(next_command.command == BEEP_COM_LEFT_MOTOR){
							next_command.data_missing = 1;
						}else if (next_command.command == BEEP_COM_RIGHT_MOTOR){
							next_command.data_missing = 1;
						}else if (next_command.command == BEEP_COM_BOTH_MOTORS){
							next_command.data_missing = 2;
						}else if (next_command.command == beep_com_motor_enable){
							set_motor_on(true);
							//next_command.data_missing = -1;
						}else if (next_command.command == beep_com_motor_shutdown){
							set_motor_on(false);
							//next_command.data_missing = -1;
						}
					}else if(next_command.device == BEEP_DEV_IR){			
						if(next_command.command <= 7){
							measure_ir_distances(next_command.command, 1, false);
						}else if (next_command.command == BEEP_COM_IR_ALL){							
							measure_ir_distances(0, 8, false);
						}
						//next_command.data_missing = -1;
					}else if(next_command.device == BEEP_DEV_IR_FILTERED){
						if(next_command.command <= 7){
							measure_ir_distances(next_command.command, 1, true);
						}else if (next_command.command == BEEP_COM_IR_ALL){
							measure_ir_distances(0, 8, true);
						}
					}else if(next_command.device == BEEP_DEV_RGB_LED){
						if(next_command.command == BEEP_COM_LEDS_OFF){
							enable_rgb_leds(false);
						}else if(next_command.command == BEEP_COM_LEDS_ON){
							enable_rgb_leds(true);
						}else if(next_command.command < 8){
							next_command.data_missing = 3;
						}
					}
				}else{
					next_command.data[next_command.head] = data;
					next_command.head += 1;
					next_command.data_missing -= 1;
					if (next_command.data_missing == 0){					
						if(next_command.device==BEEP_DEV_MOTORS){
							if(next_command.command == BEEP_COM_LEFT_MOTOR){
								set_beepmotor_speed(motor_l, next_command.data[0]);
							}else if(next_command.command == BEEP_COM_RIGHT_MOTOR){
								set_beepmotor_speed(motor_r, next_command.data[0]);
							}else if(next_command.command == BEEP_COM_BOTH_MOTORS){
								set_beepmotor_speed(motor_l, next_command.data[0]);
								set_beepmotor_speed(motor_r, next_command.data[1]);
							}
						}else if(next_command.device == BEEP_DEV_RGB_LED){
							if (next_command.command < 8){
								myColors[next_command.command].red = next_command.data[0];
								myColors[next_command.command].green = next_command.data[1];
								myColors[next_command.command].blue = next_command.data[2];
							}
						}
					
						//command executed, prepare for new command
						next_command.head = 0;
						next_command.data_missing =- 1;
					}
				}
			}
		}
    }
}


ISR(USARTD0_RXC_vect){
	USART_RXComplete(&USART_data);
}


ISR(USARTD0_DRE_vect){
	USART_DataRegEmpty(&USART_data);
}


ISR(ADCA_CH0_vect){
		
	ISR_adc_ir_driver();
	
}

//RGB LED multiplexing
ISR(TCE0_OVF_vect){
	static uint8_t led_multiplex_counter = 0; //software prescale
	static uint8_t led = 0; //next led number
	if(led_multiplex_counter++ > 0x5){
		led_multiplex_counter=0;
		//disable LED OUTPUT
		TCE0.CTRLB = TC_WGMODE_SS_gc; //disable pwm output, leave Single slope on
		PORTE.OUTCLR = PIN0_bm | PIN1_bm | PIN2_bm; // clear outputs
		TCE0.CTRLA = 0; // disable counter


		enable_rgb_leds(false);
		
		//choose LED on multiplexer
		PORTF.OUTCLR = (0b111 << 3);
		PORTF.OUTSET = (pgm_read_word (&rgb_led_lut[led]));
		
		//set pwm values
		if(pgm_read_word (&pwmtable_12[myColors[led].red])){
			//TODO finish to implement LUT
			//uint16_t
			volatile uint16_t* adress = (uint16_t*) pgm_read_word(&red_channel_lut[led]);
			*adress = pgm_read_word(&pwmtable_12[myColors[led].red]);
			TCE0.CTRLB |= pgm_read_byte(&PWM_red_ENABLE_gc_lut[led]);
		}

		if(pgm_read_word(&pwmtable_12[myColors[led].blue])){
			volatile uint16_t* adress = (uint16_t*) pgm_read_word(&blue_channel_lut[led]);
			*adress = pgm_read_word(&pwmtable_12[myColors[led].blue]);
			TCE0.CTRLB |= pgm_read_byte(&PWM_blue_ENABLE_gc_lut[led]);
		}
		
		if(pgm_read_word (&pwmtable_12[myColors[led].green])){
			volatile uint16_t* adress = (uint16_t*) pgm_read_word(&green_channel_lut[led]);
			*adress = pgm_read_word(&pwmtable_12[myColors[led].green]);
			TCE0.CTRLB |= pgm_read_byte(&PWM_green_ENABLE_gc_lut[led]);
		}

		//reset counter, start counter
		TCE0.CNT = 0x00;
		TCE0.CTRLA = TC_CLKSEL_DIV1_gc;
		
		//select next LED
		led++;
		led &= 0b111;
	}
}
