iti-luebeck/BEEP/Software/catkin_ws/src/beep_imu/ir_distance2a.py

#!/usr/bin/env python

import smbus
import time

bus = smbus.SMBus(1)
irAddress = 0x39

def init():
  #bus.write_byte_data(irAddress, 0, 0);
  bus.write_byte_data(irAddress, 0xA2, 0xFF) #set proximity integration time
  bus.write_byte_data(irAddress, 0x83, 0xFF) #set wait time
  bus.write_byte_data(irAddress, 0x8E, 0x05) #set pulse count
  bus.write_byte_data(irAddress, 0x8F, 0x20) #100mA, diode channel 0 and 1
  bus.write_byte_data(irAddress, 0x80, 0x07) #enable
  time.sleep(0.012)


init()
while True:
  #print "Clear (not for 2671)"
  #print bus.read_word_data(irAddress, 0x94)
  #print "IR (not for 2671)"
  #print bus.read_word_data(irAddress, 0x96)
  #print "Prox"
  print bus.read_word_data(irAddress, 0x98) #PDATA
  #print
  #time.sleep(0.01)
