iti-luebeck/BEEP/Software/beep_atmega/beep_atmega.c

/*
 * beep_atmega.c
 *
 * Created: 17.05.2013 20:36:21
 *  Author: hartmann
 */ 


#include <avr/io.h>

int main(void)
{
    while(1)
    {
        //TODO:: Please write your application code 
    }
}
