iti-luebeck/BEEP/(commit log)

2013-02-09 Added node publishing an (not finished) imu msg
2013-04-29 initialize .gitignore commit prototype boards
    [8_RGB_SMD_LEDs.brd, 8_RGB_SMD_LEDs.sch, 8_R_G_B_LEDs.brd, 8_R_G_B_LEDs.sch, APDS-9801.brd, APDS-9801.sch, ATMEGA168.brd, ATMEGA168.sch]
2013-04-29 enlarge Clearence to 10mil created some pdf files for the boards
    [8_RGB_SMD_LEDs.brd, APDS-9801.brd, ATMEGA168.brd, Easy_LED.brd, HSDL-9100.brd, PCA9548A.brd, TCS3103.brd, TCS32X0.brd]
2013-05-05 Add branding ;) enhance PCBs finish Easy RGB Board add Texas Instruments libray from Element 14 add dxf import ulp for eagle add Script for easy eagle export to pdf for etching minor cleanup
    [8_RGB_SMD_LEDs.brd, 8_RGB_SMD_LEDs.sch, 8_R_G_B_LEDs.brd, 8_R_G_B_LEDs.sch, APDS-9801.brd, APDS-9801.sch, ATMEGA168.brd, ATMEGA168.sch]
2013-05-10 remove GND under TSL2671 fix LED size fix Cap size
    [TSL2671.brd, TSL2671.sch]
2013-05-15 update HSDL-9100 footprint and pcb
    [HSDL-9100.brd, HSDL-9100.sch]
2013-05-16 rotate reset button on atmega board remove GND under TCS3103
    [ATMEGA168.brd, ATMEGA168.sch, TCS3103.brd]
2013-05-23 add initial 3D plans
    [Baugruppe1.0004.iam, Baugruppe1.iam, PSteg.0001.ipt, PSteg.ipt, Stirnräder1.iam, Stirnräder2.iam, Stirnräder3.0001.iam, Stirnräder3.iam]
2013-05-24 add lot of 3D sketches. Needs some cleanup.
    [BaneBots2375.ipt, Baugruppe1.0004.iam, Baugruppe1.0005.iam, Getriebe1.0006.iam, Getriebe1.0010.iam, Getriebe1.iam, PCB.0004.ipt, PCB.ipt]
2013-05-28 add transmission really needs some cleanup!
    [Baugruppe1.0005.iam, EndA.ipt, EndAssembly.iam, EndCap.ipt, Getriebe1.0006.iam, I53.iam, I53D.ipt, I53O.ipt]
2013-05-28 Remove Inventor Backups
    [Baugruppe1.0005.iam, Getriebe1.0010.iam, PCB.0004.ipt, PSteg.0002.ipt, RaspberryPi.0002.iam, Z.0001.idw]
2013-05-31 add two experimental gear systems
    [BFront.ipt, DoppelZahnrad.iam, EE-SX1131.ipt, EncoderWheel.ipt, EncoderWheel2.ipt, GehäuseBack.ipt, GehäuseFront.ipt, Gertiebe.iam]
2013-06-03 minor harware moel changes
    [BaneBots2375.ipt, Gertiebe.iam, GetriebeC.iam, Robot.iam]
2013-06-03 enhance GetriebeB add cnc version of GetriebeB
    [EncoderWheel2.ipt, GehäuseBack.ipt, GehäuseFront.ipt, Gertiebe.iam, GertiebeBCNC.iam, Robot.iam]
2013-06-04 Enhance Getriebe B cnc lodistance
    [EncoderWheel2.ipt, GehauseBack.stl, GehäuseBack.ipt, GehäuseFront.ipt, GertiebeBCNC.iam, GertiebeBCNCld.iam, backcncld.ipt, frontcncld.dxf]
2013-06-04 create g code for gear system
    [EncoderWheel2.stl, GertiebeBCNCld.iam, Robot.iam, backcncld.ipt, backcncld.stl, frontcncld.dxf, frontcncld.ipt, frontcncld.stl]
2013-06-06 add some drill files etc.
    [EncoderWheel2.ipt, EncoderWheel2_.stl, GertiebeBCNCld.iam]
2013-06-06 add EE-SX1131 electronic
    [EE-SX1131.brd, EE-SX1131.sch]
2013-06-13 enhance HSDL-9100 electronic
    [HSDL-9100.brd, HSDL-9100.sch]
2013-06-14 enhance pads and board for HSDL-9100
    [HSDL-9100.brd, HSDL-9100.sch]
2013-06-14 edit version String
    [HSDL-9100.brd]
2013-06-24 add some eagle libraries add BEEP AIO Board
    [AIO.brd, AIO.sch]
2013-06-25 Big Cleanup: * new folder structure under Hardware * new CAD models for wheels, gear motor, batteries, battery holder, etc
    [8_RGB_SMD_LEDs.brd, 8_RGB_SMD_LEDs.sch, AIO.brd, AIO.sch, APDS-9801.brd, APDS-9801.sch, ATMEGA168.brd, ATMEGA168.sch]
2013-06-25 Fix battery names, enhance model
    [RaspberryPi_with_frame.iam, Robot.iam, battery_18650.ipt, frame.ipt, holder.ipt, holder_18500.ipt, holder_18650.ipt, holder_with_batteries.iam]
2013-06-26 minor tweaks to 3D CAD models
    [RaspberryPi.iam, RaspberryPi_with_frame.iam, Robot.iam, frame.ipt, holder_18650.ipt, holder_with_batteries_18650.iam]
2013-06-26 Begin with the case and the asus xtionPRO LIVE
    [RaspberryPi.iam, RaspberryPi_PCB.ipt, Robot.iam, base.ipt, head.ipt]
2013-06-27 enhance case add HSDL-9100 add holes for HSDL-9100
    [HSDL-9100.iam, RaspberryPi.iam, Robot.iam, base.ipt, bottom_pcb.ipt, top.ipt]
2013-06-28 enhance robot case enhance main circuit
    [AIO.brd, AIO.sch, Robot.iam, base.ipt]
2013-06-28 minor enhancement of robot case enhancements of RPi Footprint enhance main pcb add pcb space drawing
    [AIO.brd, AIO.sch, Robot.iam]
2013-06-28 add dxf, ps files for pcb dimensions
    [pcb_space.dxf]
2013-06-28 change dxf to mm format remove ps file enhance tips file for eagle dxf inmport
    [pcb_space.dxf]
2013-06-28 try again to export with mm
    [pcb_space.dxf]
2013-06-28 use LINE instead of POLYLINE in DXF
    [pcb_space.dxf]
2013-06-28 try another dxf export
    [pcb_space.dxf]
2013-06-28 add robot pcb space to eagle pcb enhance circuit
    [AIO.brd, AIO.sch, Robot.iam, pcb_space.dxf]
2013-07-01 enhance BEEP main pcb, rgb and ir boards
    [AIO.brd, AIO.sch, rgb_and_irdistance.brd, rgb_and_irdistance.sch]
2013-07-01 continue working on shematic for AIO BEEP started with pcb routing
    [AIO.brd, AIO.sch]
2013-07-03 partly route the main beep board
    [AIO.brd, AIO.sch]
2013-07-03 continue routing
    [AIO.brd, AIO.sch]
2013-07-25 *add i2c connector *continue routing
    [AIO.brd, AIO.sch]
2013-07-25 add i2c header continue routing
    [AIO.brd, AIO.sch]
2013-07-25 added some testnodes to catkin workspace catkin will not be used und probably deleted with the next commit added ir_distance and zusmoro_state_machine rosbuild package
2013-07-26 continue routing add hardware architecture shematic
    [AIO.brd, AIO.sch]
2013-07-29 add momentary push button with mosfet latch circuit as on/off switch continue routing
    [AIO.brd, AIO.sch]
2013-07-29 continue routing replace so16 multiplexer with ssop16 add ssop16 footprint to beep library
    [AIO.brd, AIO.sch]
2013-07-30 continue routing...
    [AIO.brd, AIO.sch]
2013-07-31 restructured sensor architecture
2013-07-31 Add audio amplifier correct batt rev circuit and on off circuit some routing
    [AIO.brd, AIO.sch]
2013-07-31 add critical DRC file continue routing
    [AIO.brd, AIO.sch]
2013-07-31 change folder structure and naming shema
    [AIO.brd, main.sch, rgb_and_irdistance.brd, rgb_and_irdistance.sch]
2013-07-31 further cleanup
    [AIO.brd, AIO.sch]
2013-07-31 add poweroff line to atxmega
    [AIO.brd, AIO.sch]
2013-08-01 enhance routing fix rgb and ir distance board (connector was on the wrong side)
    [AIO.brd, rgb_and_irdistance.brd, rgb_and_irdistance.sch]
2013-08-01 rearrange connectors routing
    [AIO.brd, rgb_and_irdistance.brd, rgb_and_irdistance.sch]
2013-08-02 move folders try to apply drc from sparkfun (wip) moved audio connetor add slice for camera flexcable
    [AIO.brd, AIO.sch, rgb_and_irdistance.brd, rgb_and_irdistance.sch]
2013-08-02 beep node requests all sensor data from xmega and publishes them on topics beep node also can be used to send actuator commands to xmega by publishing on topics
2013-08-22 enhance routing, add external crystal, move components for Raspberry Pi
    [AIO.brd, AIO.sch]
2013-08-23 Use PORTC for TWI, bcause of really annoying errata that states that TWI on PORT E is unusable for Revisions prior of I. damn errata!!!
    [AIO.brd, AIO.sch]
2013-08-24 minor enhancements
    [AIO.brd, AIO.sch]
2013-08-24 add 3M 8526-4500PL to RPi drawing and adjust PCB change keepout to restrict layer for usb and network port locations
    [AIO.brd, AIO.sch]
2013-08-24 add lib for modified micromatch connector (with orietation hole) use micromatch connector with orientation hole
    [AIO.brd, AIO.sch]
2013-08-24 add some 3D rendering of the PCB
2013-08-25 minor pcb changes add 3D model of main pcb to 3d CAD folder clean up
    [12520.ipt, 12521.ipt, 8526-4500pl-01.ipt, AIO.brd, AIO.sch, HSDL-9100.iam, PCB.ipt, RaspberryPi.iam]
2013-08-26 continue work on 3D model and replace connector for ir rgb board
    [12520.ipt, 12521.ipt, 8526-4500pl-01.ipt, HSDL-9100.iam, PCB.ipt, RaspberryPi.iam, Robot.iam, b3w-1000.ipt]
2013-08-26 recover sch from trash... :-/
    [AIO.sch]
2013-08-26 change most 0603 components to 0805 change smd Typ D Footprint to THT Footprint
    [AIO.brd, AIO.sch, Robot.iam]
2013-08-27 enhance 3D model
    [RaspberryPi.iam, Robot.iam, base.ipt, beep_main_assembled.iam, beep_rgb_ir.ipt, beep_rgb_ir_assembled.iam, pcb_assembly.iam]
2013-08-27 minor enhancement of symbol placement
    [AIO.sch]
2013-08-27 add connections from xmega to encoders enhance Borders
    [AIO.brd, AIO.sch]
2013-08-27 minor pcb changes
    [AIO.brd]
2013-08-27 last? minor changes.
    [AIO.brd, AIO.sch]
2013-08-30 modelling 3D model of case, minor change of ir / rgb board
    [5050_LED.ipt, PCB.ipt, RaspberryPi.iam, Robot.iam, base.ipt, beep_main.ipt, beep_main_assembled.iam, beep_main_new.ipt]
2013-08-30 change value of cap in of off circuit continue case design
    [AIO.brd, AIO.sch, Robot.iam, beep_rgb_ir_assembled.iam]
2013-09-05 add new parts
    [beep_main.ipt, beep_main_assembled.iam, beep_main_new.ipt, cny-70.ipt, pcb_assembly.iam, top.ipt]
2013-09-09 enhance case
    [Robot.iam, base.ipt, beep_main_assembled.iam, beep_main_new.ipt, camera.ipt, camera_modul.iam, connector.ipt, pcb.ipt]
2013-09-09 add 3D CAD render and images of the pcb
2013-09-10 add irlml2244 to pwm simulation
2013-09-10 add IRLML2244 transistor to library add pcb to fix heigh side driver
    [high_side_driver_fix.brd, high_side_driver_fix.sch]
2013-09-13 Case modifications: *add stand for ball caster *add mounting hole >>This is the 3D printed case<<
    [Robot.iam, base.ipt, beep_main_assembled.iam, beep_main_new.ipt, camera_modul.iam, pcb_assembly.iam]
2013-09-16 add images of BEEP 0.2 case
2013-09-16 rename files add bottom board (WIP)
    [bottom.sch, high_side_driver_fix.brd, high_side_driver_fix.sch, main.brd, main.sch]
2013-09-17 add encoder wheel inlay add ods file to calculate XMega baud rate
    [Xmega_baud_calculator.ods, encoder_wheel.ipt, encoder_wheel.stl, encoder_wheel.stp]
2013-09-18 add simulation for comperator with hysteresis add library with atmel products (by element14) continue work on bottom shematic
    [bottom.sch]
2013-09-18 add side sensor board
    [rgb_and_irdistance_side.brd, rgb_and_irdistance_side.sch]
2013-09-19 add more distance boards continue work on bottom pcb
    [bottom.brd, bottom.sch, rgb_and_irdistance_side1.brd, rgb_and_irdistance_side1.sch, rgb_and_irdistance_side2.brd, rgb_and_irdistance_side2.sch, rgb_and_irdistance_side3.brd, rgb_and_irdistance_side3.sch]
2013-09-20 started routing of the bottom pcb
    [bottom.brd]
2013-09-20 continue work on bottom pcb
    [bottom.brd, bottom.sch]
2013-09-23 continue work on bottom pcbs
    [bottom.brd, bottom.sch, color_sensor.brd]
2013-09-26 continue work on bottom pcb add simulation for attiny on/off
    [bottom.brd, bottom.sch]
2013-09-26 add modified gcode export script finish bottom pcb add gcode for cnc
    [bottom.brd]
2013-10-11 add 74hcxx spice models add new enhanced attiny on off circuit (rev2=pmos, rev3=nmos and experimental)
2013-10-11 fix simulation of on/off switch add attiny on off switch code add latest xmega code changes
    [IR_analyse.ods]
2013-10-15 correct encoder on bottom pcb enhance attiny code
    [bottom.brd, bottom.sch]
2013-12-19 the forgotten commit ;)
    * enhance bottom, rgb sensor pcb
    * create attiny and lm239 eval boards
    * bug fix for the pdf export scripts
    * correct attiny soft power switch simulation
    * add experimental color sensor code
    * add rgb color look up table
    * correct motor roations
    * various other (this is the forgetten commit)
    [bottom.brd, color_sensor.brd, lm239d.brd, lm239d.sch, rgb_and_irdistance_side.brd, rgb_and_irdistance_side.sch, tiny10.brd, tiny10.sch]
2014-01-06 Add new color calibration values
2014-01-09 updated 3d CAD models. Add exploded view. Add blender rendering + image.
    [5050_LED.ipt, HSDL-9100.iam, PCB.ipt, RaspberryPi.iam, Robot.iam, Robot.ipn, Wheel.iam, b3w-1000.ipt]
2014-01-09 added measurement-evaluation of IR-filter
    [Evaluation IRfilterung.ods]
2014-01-10 use mean instead of sum to calculate the mean sdt derivation of the color calibration
